gymneus/f-watch/doc/fosdem2015/pictures/pcb_component_placement.jpg

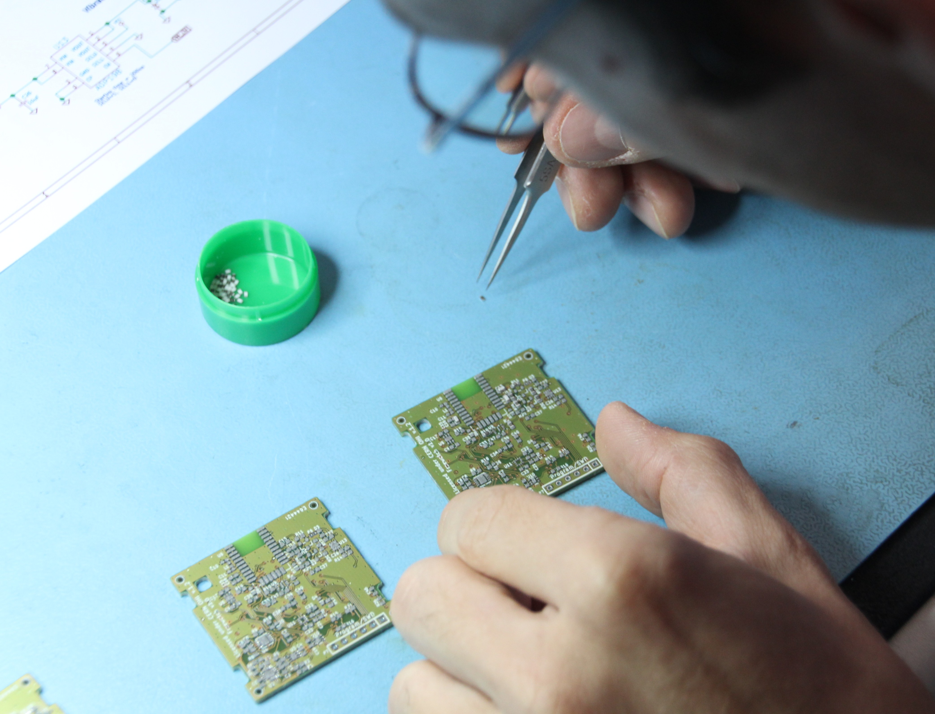
doc/fosdem2015/pictures/pcb_component_placement.jpg
