gymneus/f-watch/doc/fosdem2015/pictures/pcb_assembly_diagram.jpg

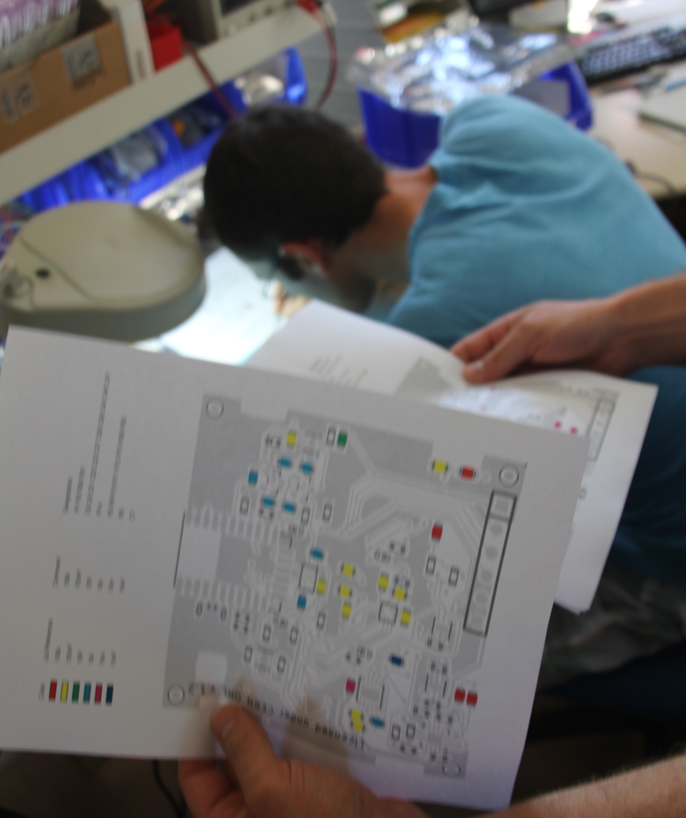
doc/fosdem2015/pictures/pcb_assembly_diagram.jpg
