gymneus/f-watch/doc/fosdem2015/pictures/battery.jpg

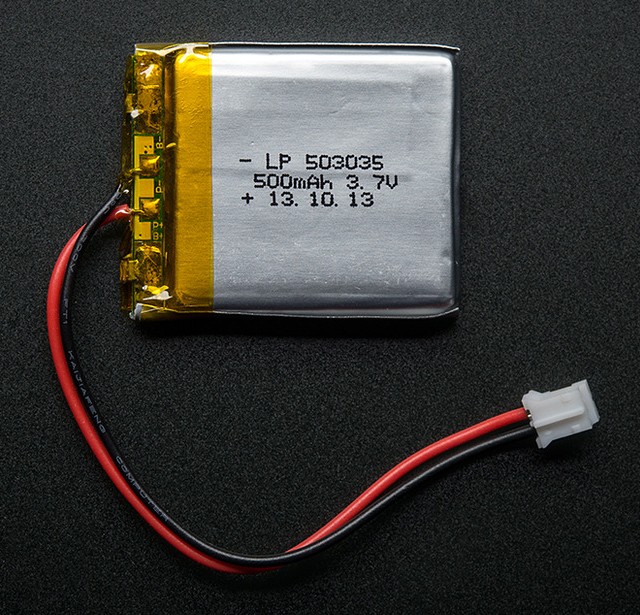
doc/fosdem2015/pictures/battery.jpg
