gymneus/f-watch/doc/fosdem2015/pictures/bl_custom_off.jpg

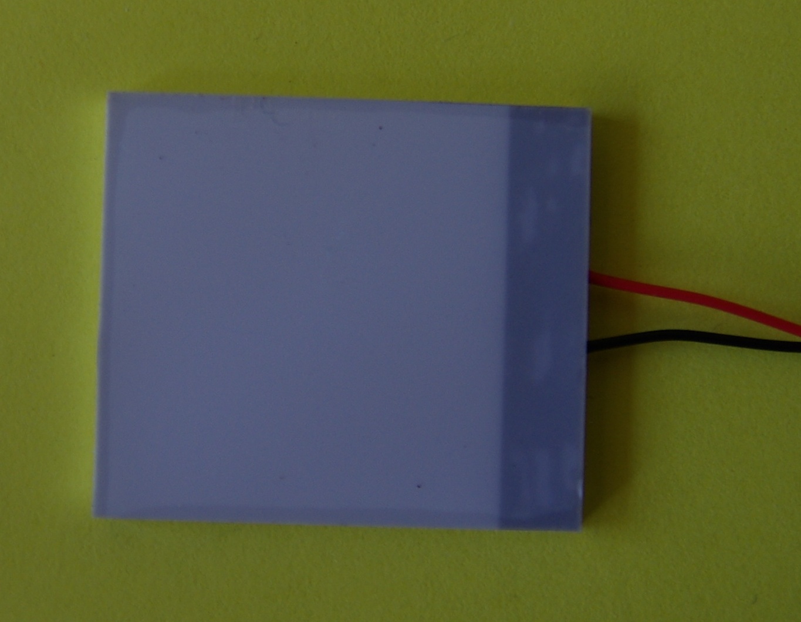
doc/fosdem2015/pictures/bl_custom_off.jpg
