gymneus/f-watch/doc/fosdem2015/pictures/bl_custom_on.jpg

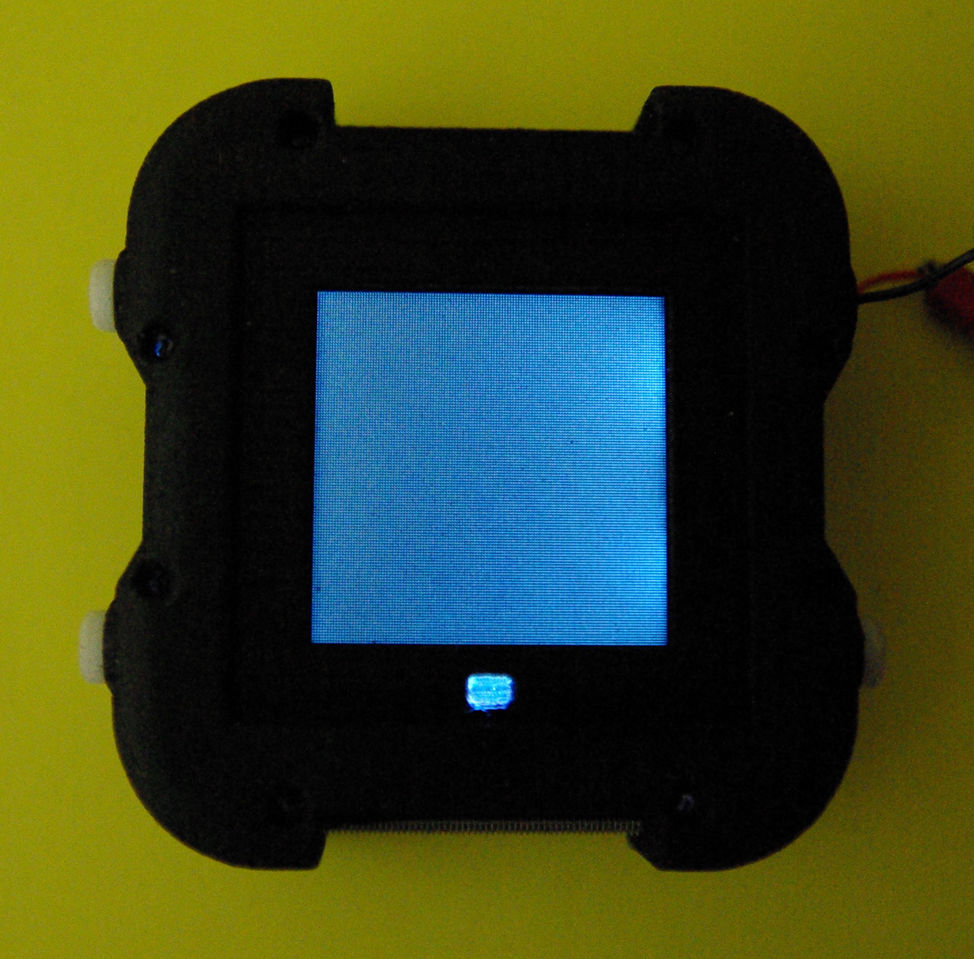
doc/fosdem2015/pictures/bl_custom_on.jpg
