gymneus/f-watch/doc/fosdem2015/pictures/bl_led_off.jpg

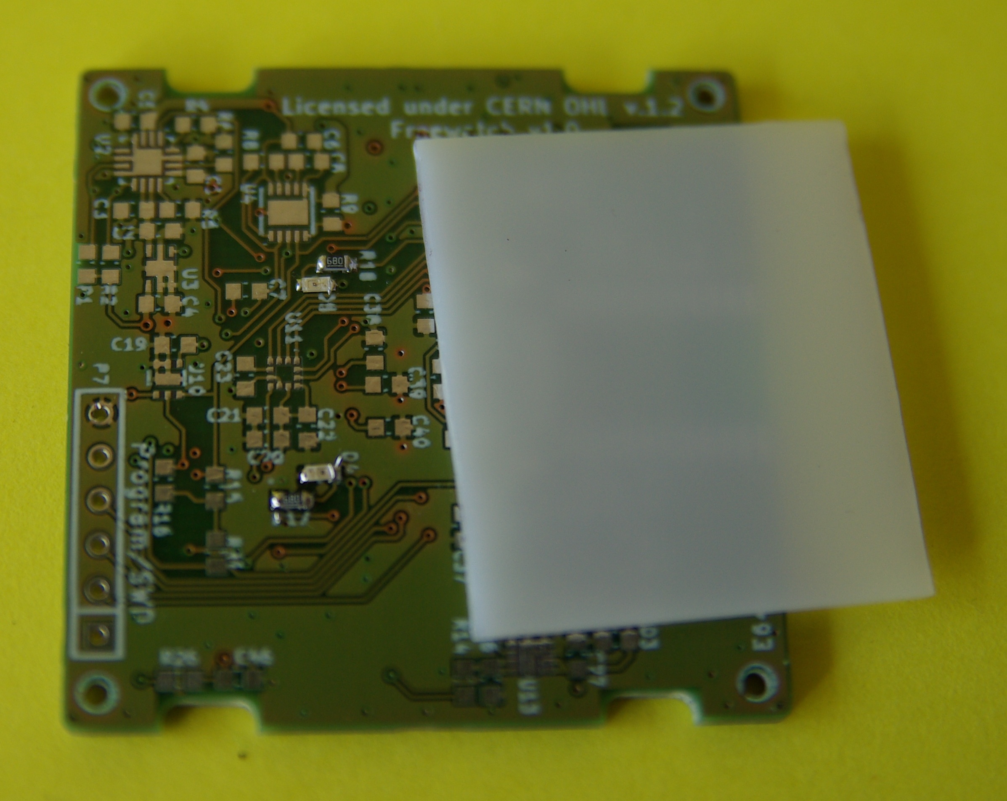
doc/fosdem2015/pictures/bl_led_off.jpg
