gymneus/f-watch/doc/fosdem2015/pictures/bl_led_on.jpg

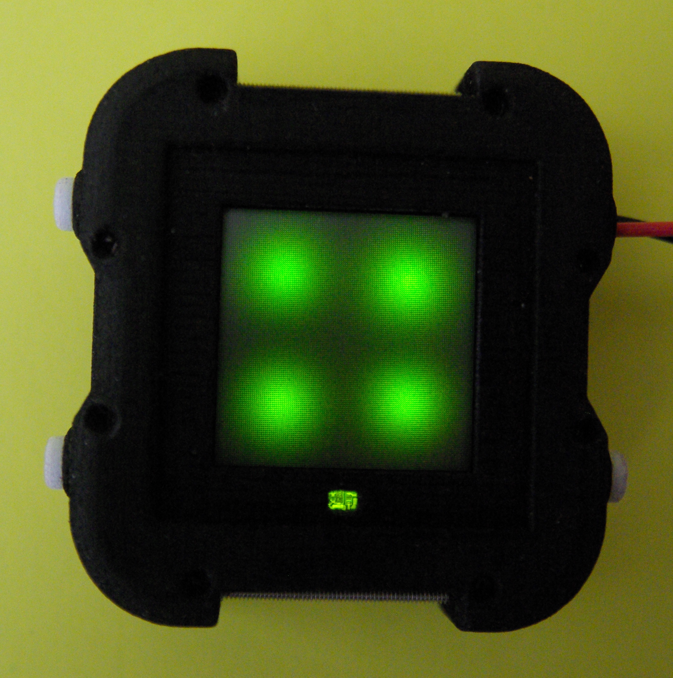
doc/fosdem2015/pictures/bl_led_on.jpg
