gymneus/f-watch/doc/fosdem2015/pictures/bl_smartphone_off.jpg

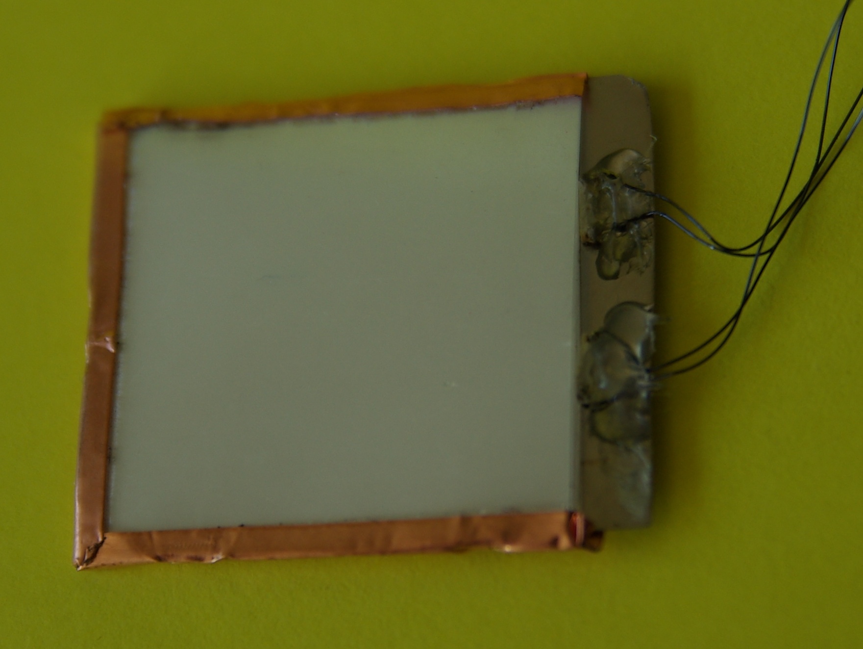
doc/fosdem2015/pictures/bl_smartphone_off.jpg
