gymneus/f-watch/doc/fosdem2015/pictures/bl_smartphone_on.jpg

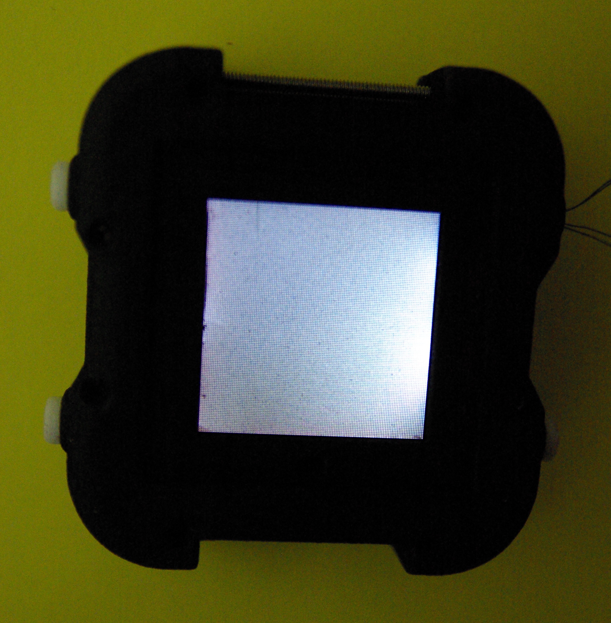
doc/fosdem2015/pictures/bl_smartphone_on.jpg
