gymneus/f-watch/doc/fosdem2015/pictures/case-design-model.jpg

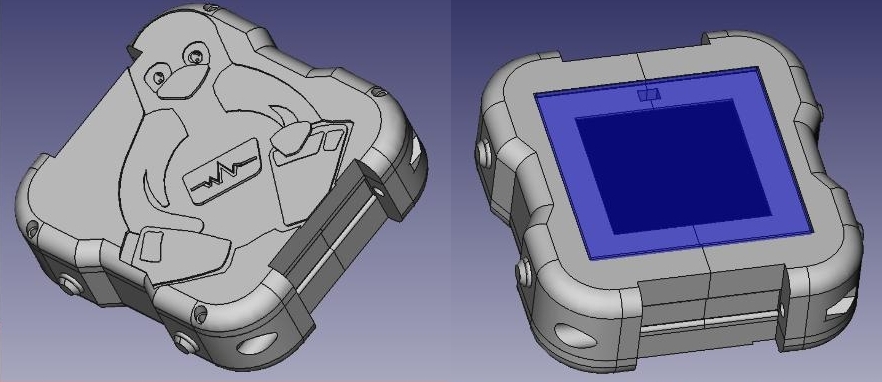
doc/fosdem2015/pictures/case-design-model.jpg
