gymneus/f-watch/doc/fosdem2015/pictures/fwatch-bike.jpg

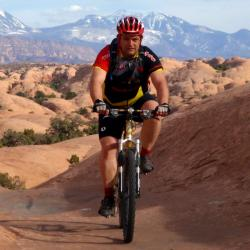
doc/fosdem2015/pictures/fwatch-bike.jpg
