gymneus/f-watch/doc/fosdem2015/pictures/fwatch-full-side-btn.jpg

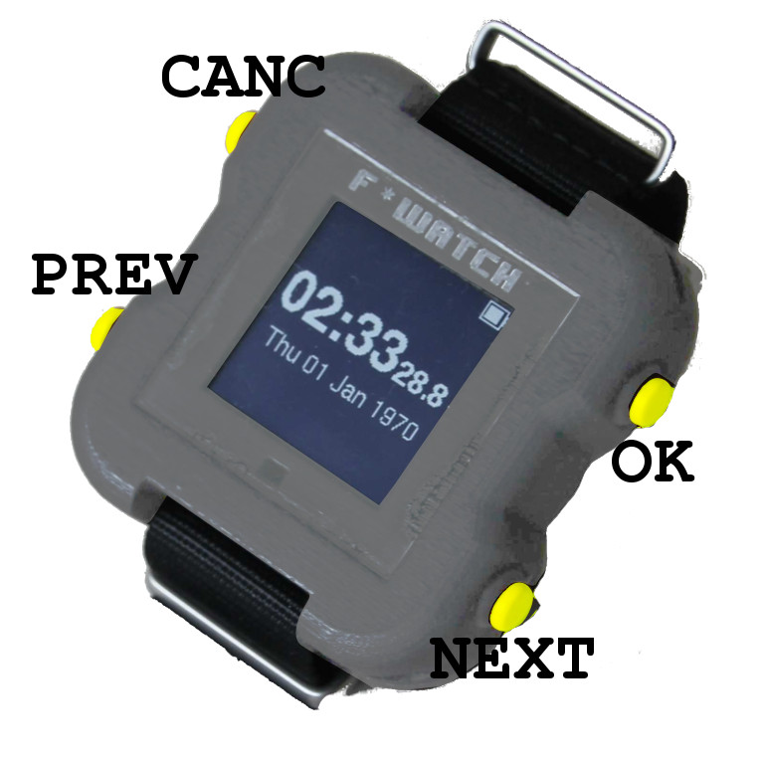
doc/fosdem2015/pictures/fwatch-full-side-btn.jpg
