gymneus/f-watch/doc/fosdem2015/pictures/fwatch-full-side.jpg

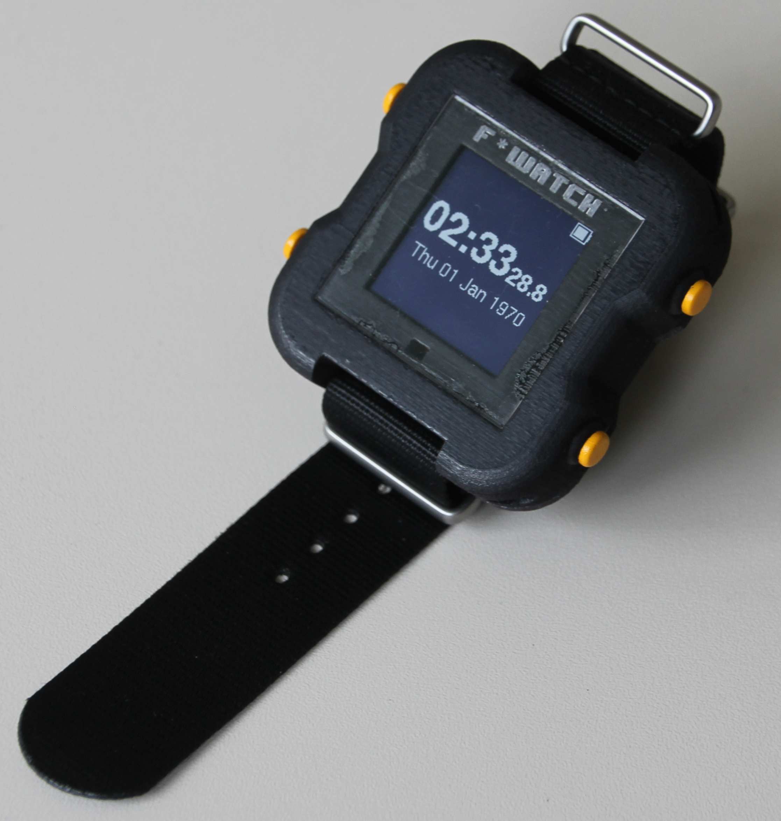
doc/fosdem2015/pictures/fwatch-full-side.jpg
