gymneus/f-watch/doc/fosdem2015/pictures/fwatch-para.jpg

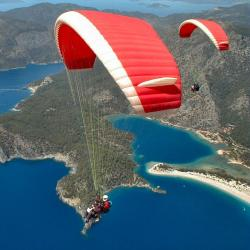
doc/fosdem2015/pictures/fwatch-para.jpg
