gymneus/f-watch/doc/fosdem2015/pictures/fwatch-team.jpg

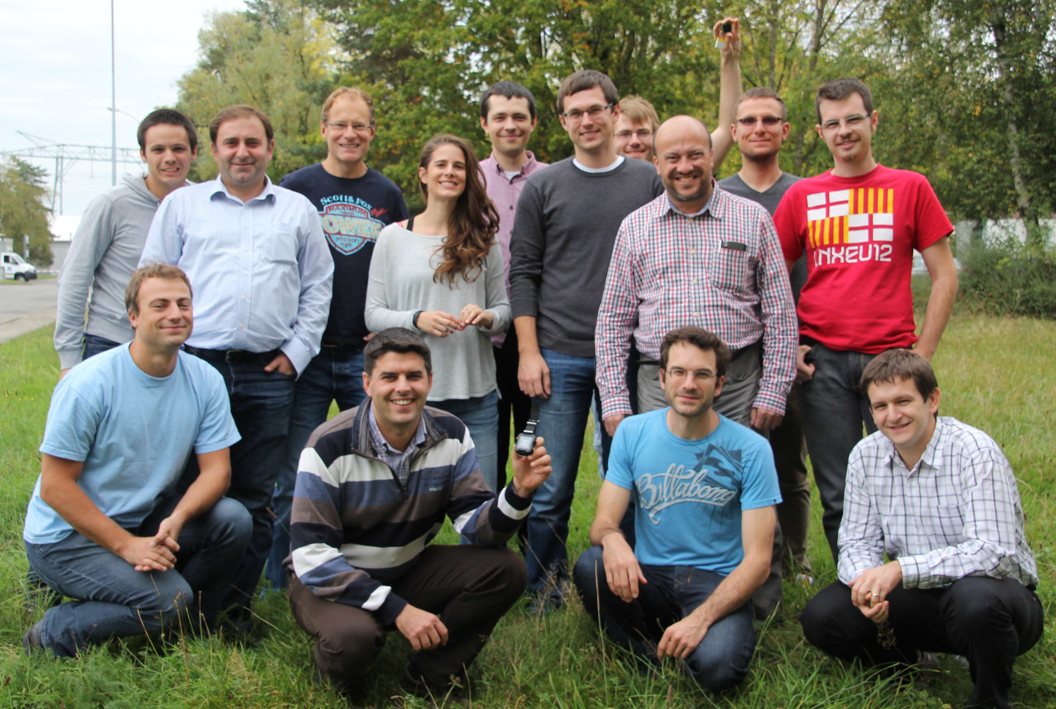
doc/fosdem2015/pictures/fwatch-team.jpg
