gymneus/f-watch/doc/fosdem2015/pictures/fwatch-tenn.jpg

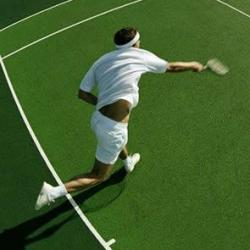
doc/fosdem2015/pictures/fwatch-tenn.jpg
