gymneus/f-watch/doc/fosdem2015/pictures/fwatch-trek.jpg

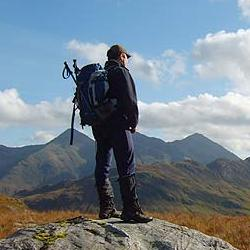
doc/fosdem2015/pictures/fwatch-trek.jpg
