gymneus/f-watch/doc/fosdem2015/pictures/LCD.jpg

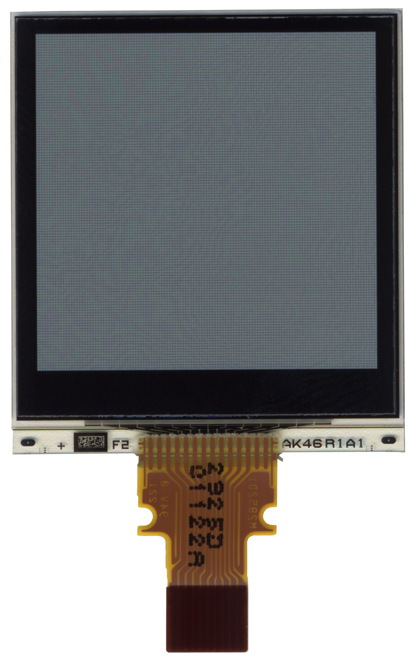
doc/fosdem2015/pictures/LCD.jpg
