gymneus/f-watch/doc/fosdem2015/pictures/M10478-A1.jpg

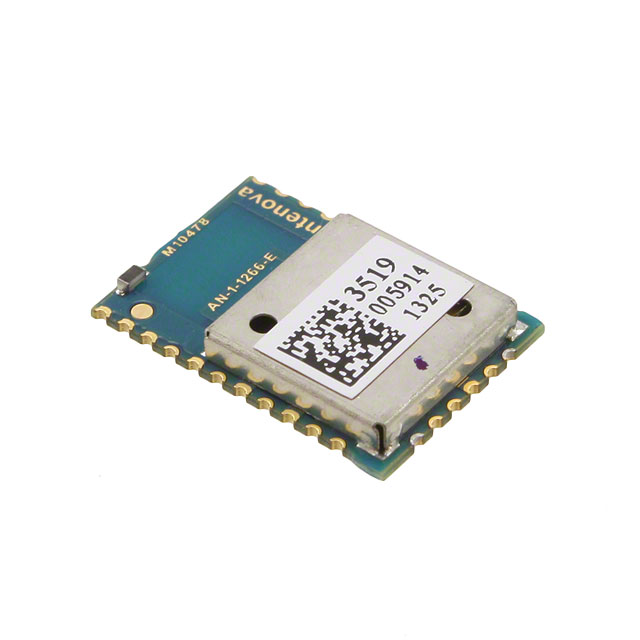
doc/fosdem2015/pictures/M10478-A1.jpg
