gymneus/f-watch/doc/fosdem2015/pictures/mcu_efm32.jpg

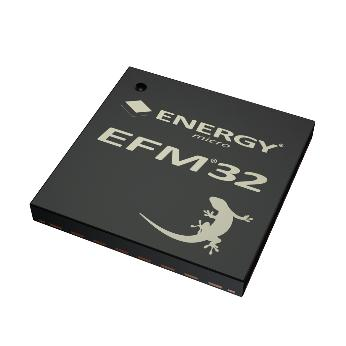
doc/fosdem2015/pictures/mcu_efm32.jpg
