gymneus/f-watch/doc/fosdem2015/pictures/MS5806-02BA52-51.jpg

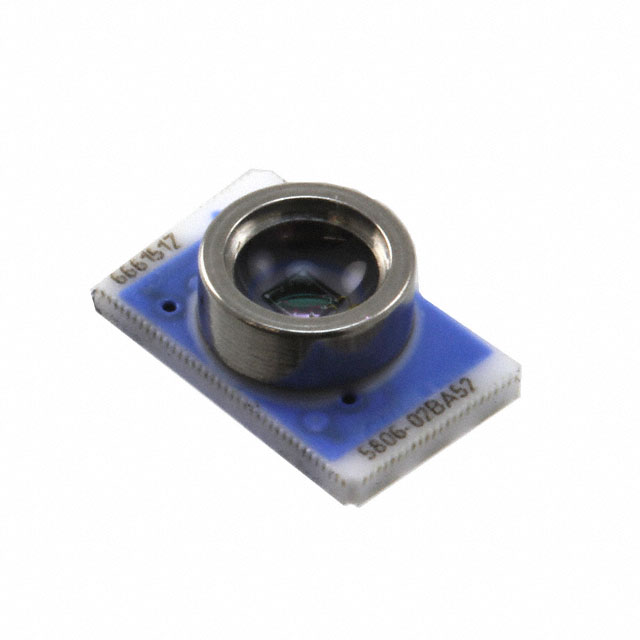
doc/fosdem2015/pictures/MS5806-02BA52-51.jpg
