gymneus/f-watch/doc/fosdem2015/pictures/pcb_mounted_bottom.jpg

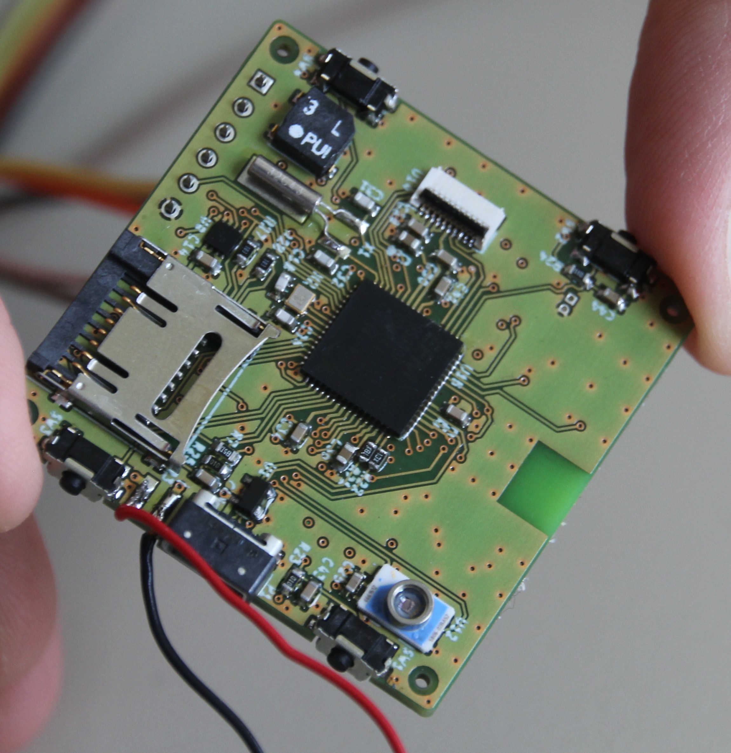
doc/fosdem2015/pictures/pcb_mounted_bottom.jpg
