gymneus/f-watch/doc/fosdem2015/pictures/pcb_mounted_top.jpg

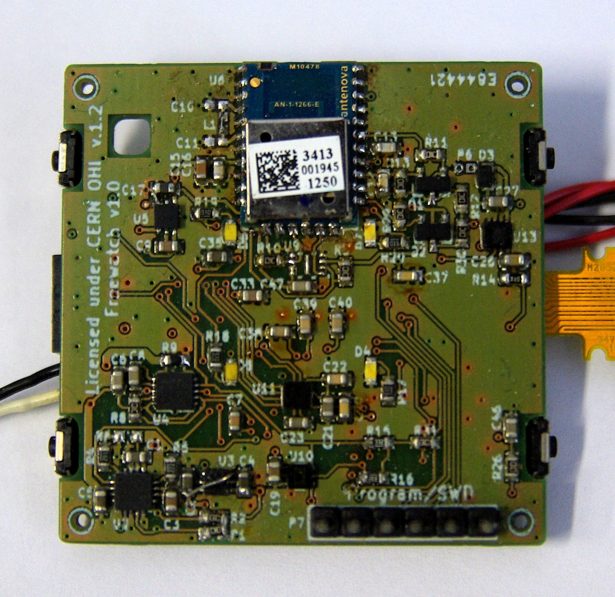
doc/fosdem2015/pictures/pcb_mounted_top.jpg
