gymneus/f-watch/doc/fosdem2015/pictures/pcb_stencil_paste.jpg

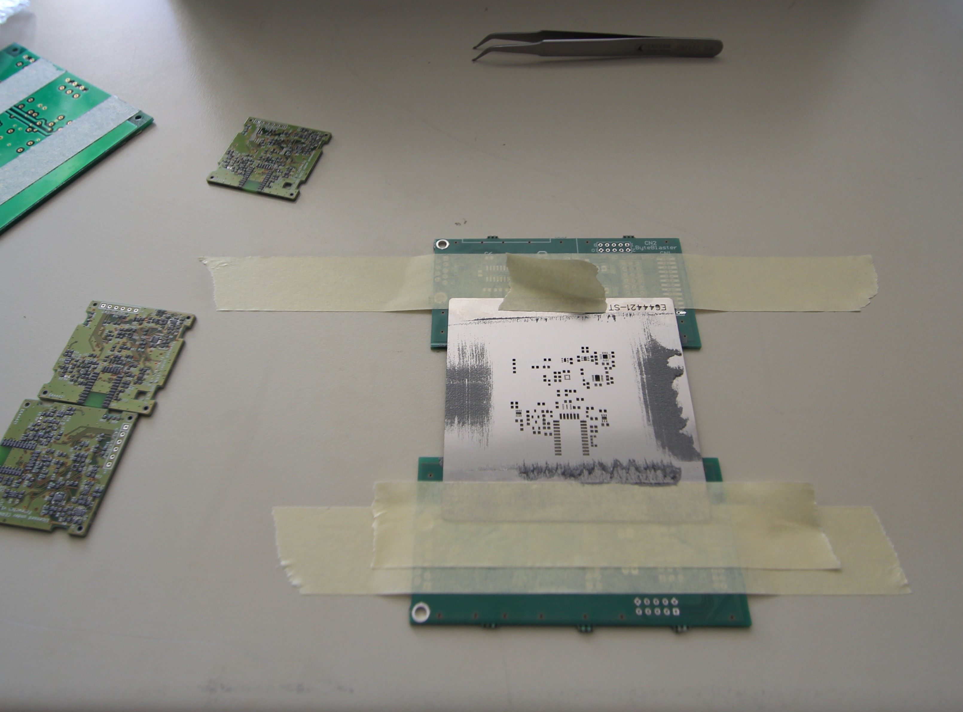
doc/fosdem2015/pictures/pcb_stencil_paste.jpg
