gymneus/f-watch/doc/fosdem2015/pictures/plexiglass.jpg

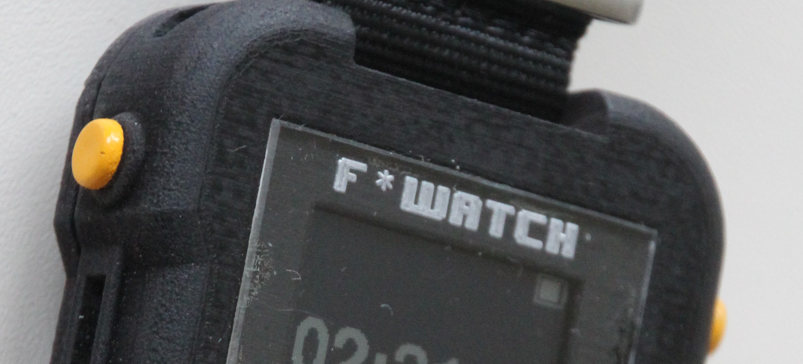
doc/fosdem2015/pictures/plexiglass.jpg
