gymneus/f-watch/doc/fosdem2015/pictures/sw_hello_world.jpg

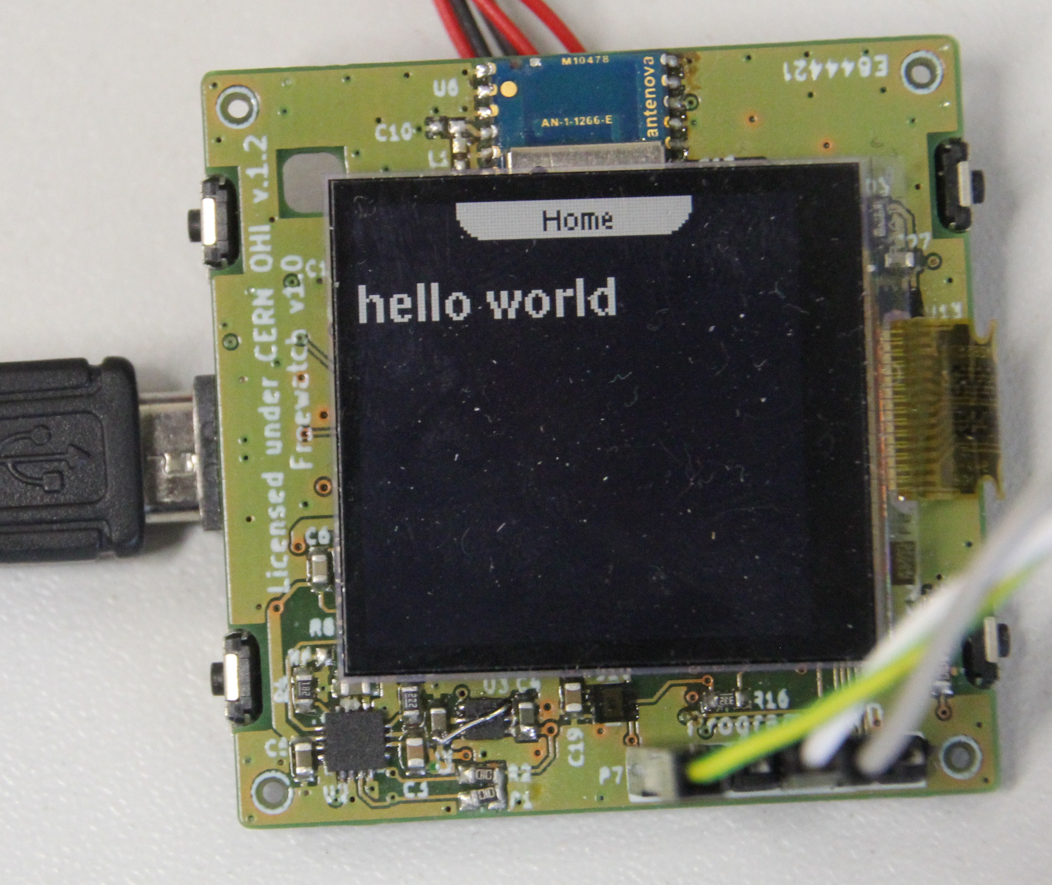
doc/fosdem2015/pictures/sw_hello_world.jpg
