gymneus/f-watch/doc/fosdem2015/pictures/tools.jpg

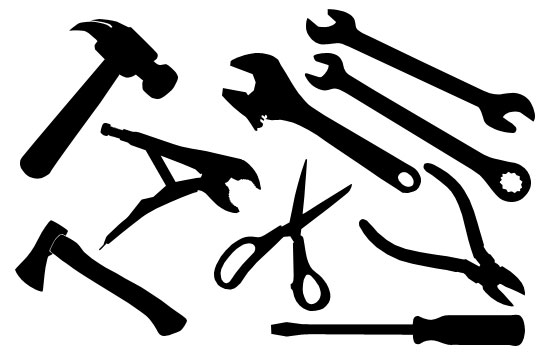
doc/fosdem2015/pictures/tools.jpg
