gymneus/f-watch/flyer.jpg

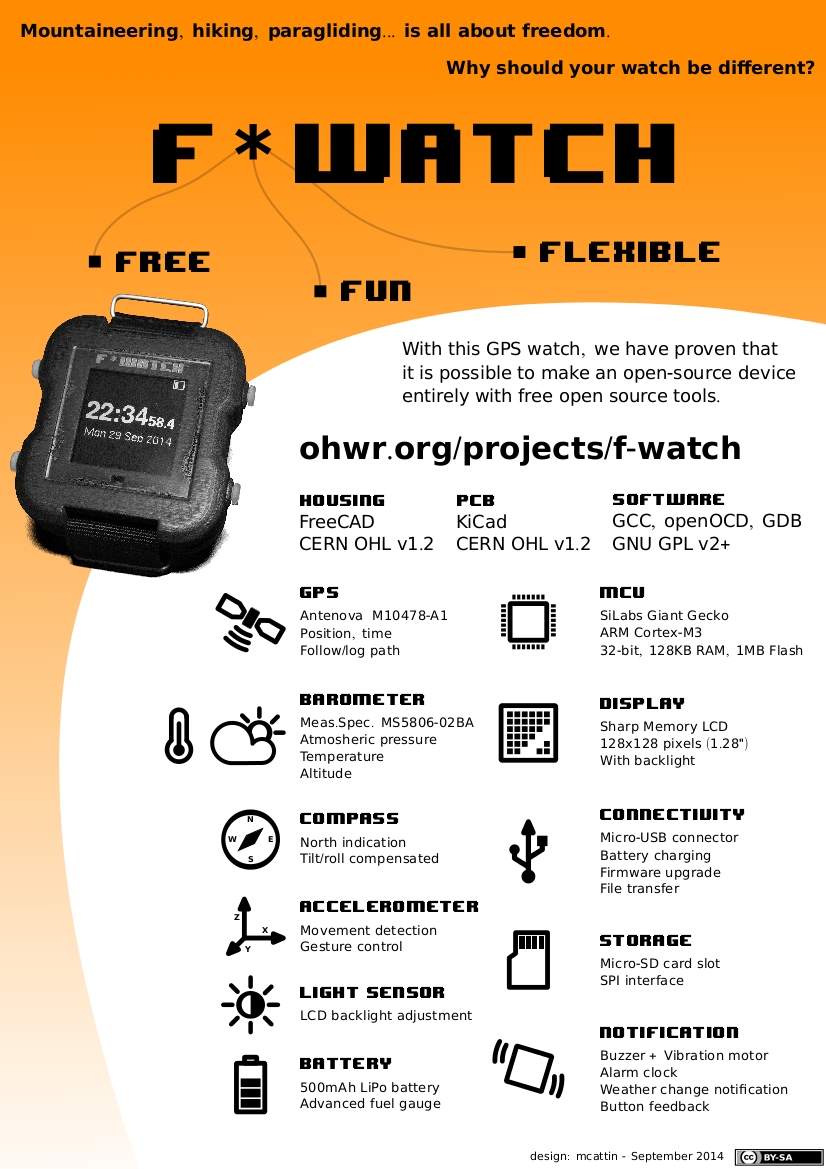
flyer.jpg
