gymneus/f-watch/sw/bitmaps/comp_circle2.bmp

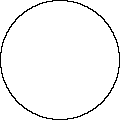
sw/bitmaps/comp_circle2.bmp
