gymneus/f-watch/sw/bitmaps/comp_circle3.bmp

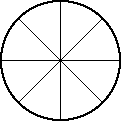
sw/bitmaps/comp_circle3.bmp
