gymneus/f-watch/sw/common/emdrv/emdrvdoc/html/group__EM__Drivers.png

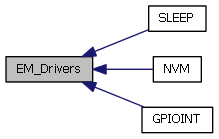
sw/common/emdrv/emdrvdoc/html/group__EM__Drivers.png
