gymneus/f-watch/mec/pcb_model/pcb_assembly.fcstd

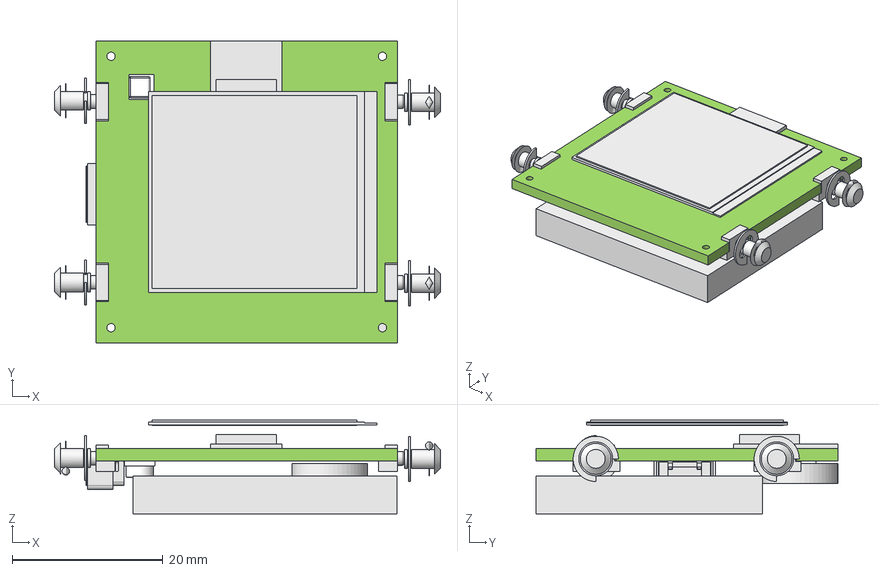
[picture p32: CAD file, 2014-10-09]
mec/pcb_model/pcb_assembly.fcstd
51.2 x 40.0 x 12.4 mm
Button1
Button2
Button3
Button4
Pressure_sensor
USB
GPS
Display
battery
Rivet_button1
Rivet_button2
Rivet_button3
Rivet_button4
PCB
Vibrating Motor
