gymneus/f-watch/mec/button_model/3d_printed_button.fcstd

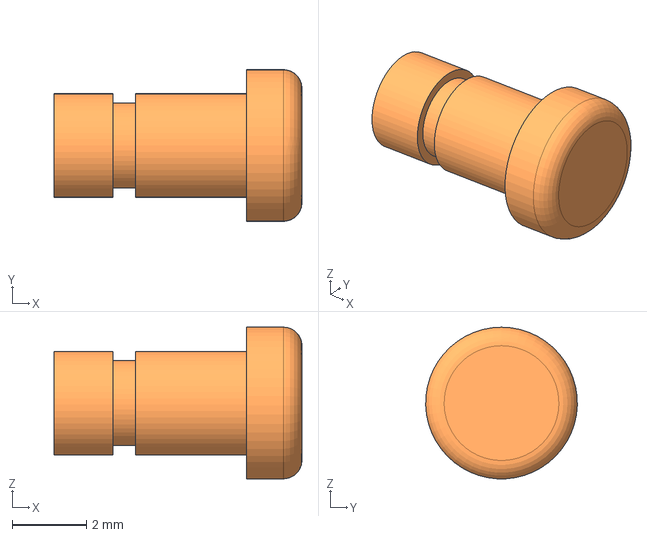
[picture p33: CAD file, 2014-10-09]
mec/button_model/3d_printed_button.fcstd
6.70 x 4.10 x 4.10 mm
