gymneus/f-watch/mec/case_model/Exported.v3/bottom.stl

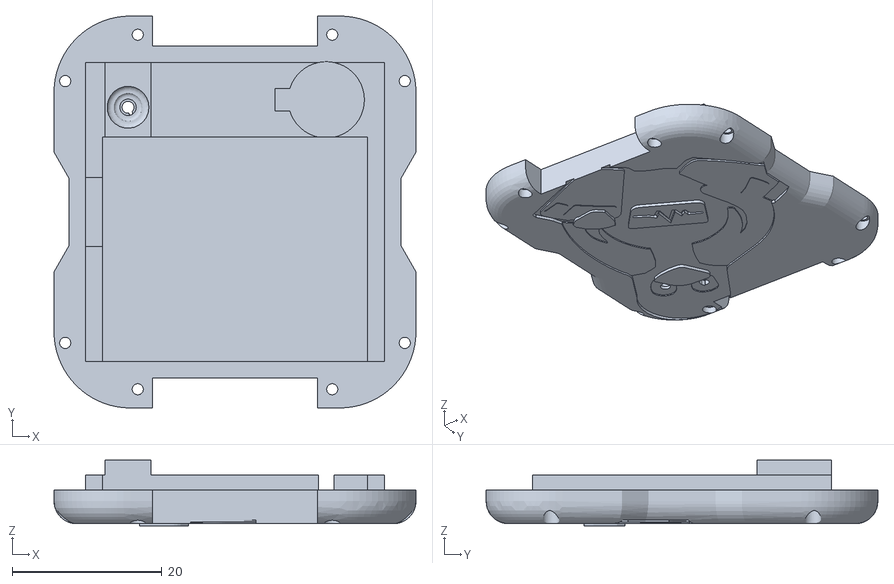
[picture p34: CAD file, 2014-10-09]
mec/case_model/Exported.v3/bottom.stl
48.4 x 52.4 x 8.80
