gymneus/f-watch/mec/case_model/Exported/TopRight.step

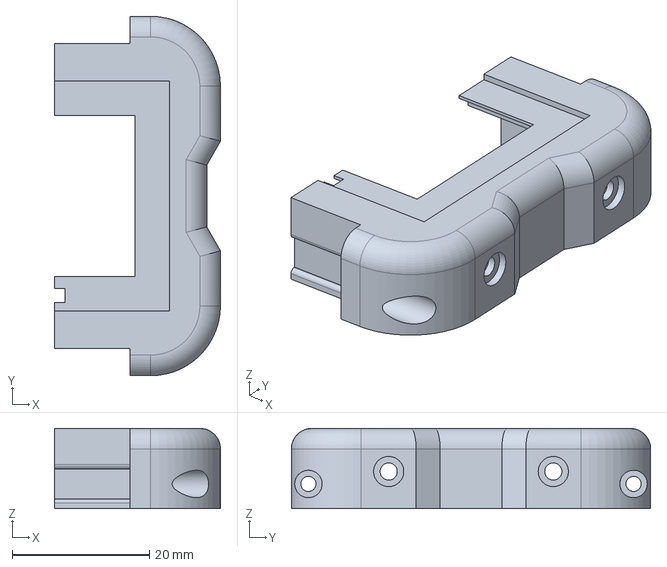
[picture p35: CAD file, 2014-10-09]
mec/case_model/Exported/TopRight.step
24.2 x 52.4 x 11.7 mm
