gymneus/f-watch/mec/case_model/watch_case.v2-simple.fcstd

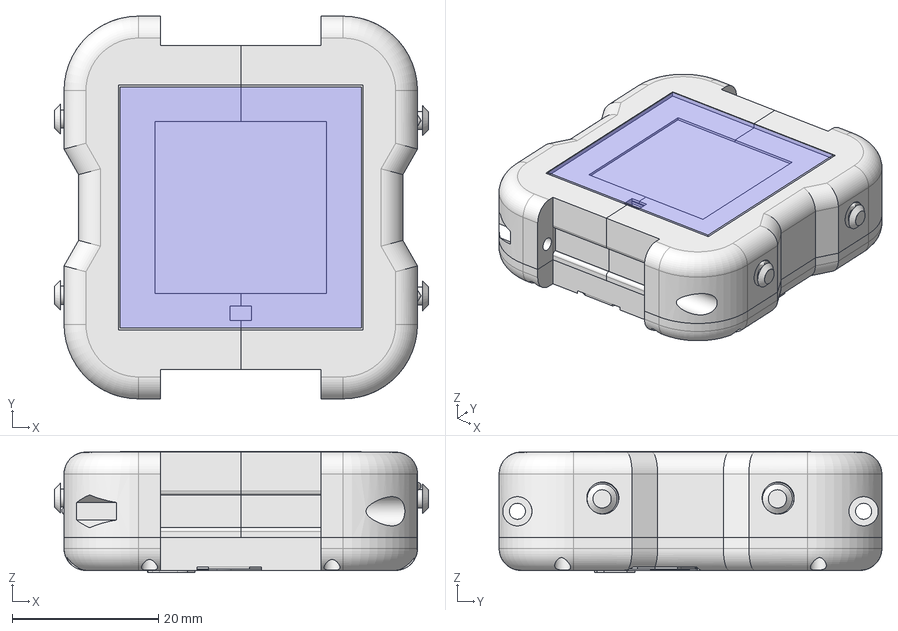
[picture p36: CAD file, 2014-10-09]
mec/case_model/watch_case.v2-simple.fcstd
51.2 x 52.4 x 16.6 mm
Rivet_buttons
PCB_assemblly
Sapphire Glass
Bottom
TopLeft
TopRigth
