gymneus/f-watch/mec/pcb_model/display_LS013B7DH03.fcstd

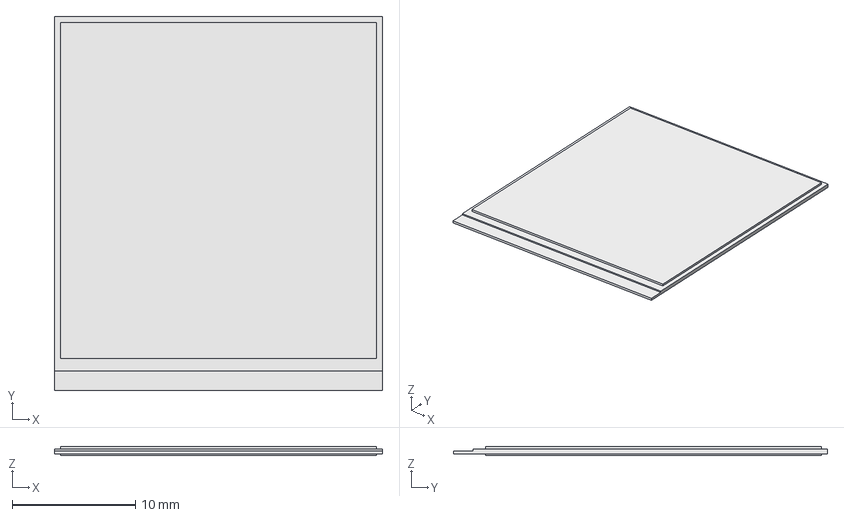
[picture p37: CAD file, 2014-10-09]
mec/pcb_model/display_LS013B7DH03.fcstd
26.6 x 30.3 x 0.741 mm
