gymneus/f-watch/mec/sketch/watch_case.fcstd

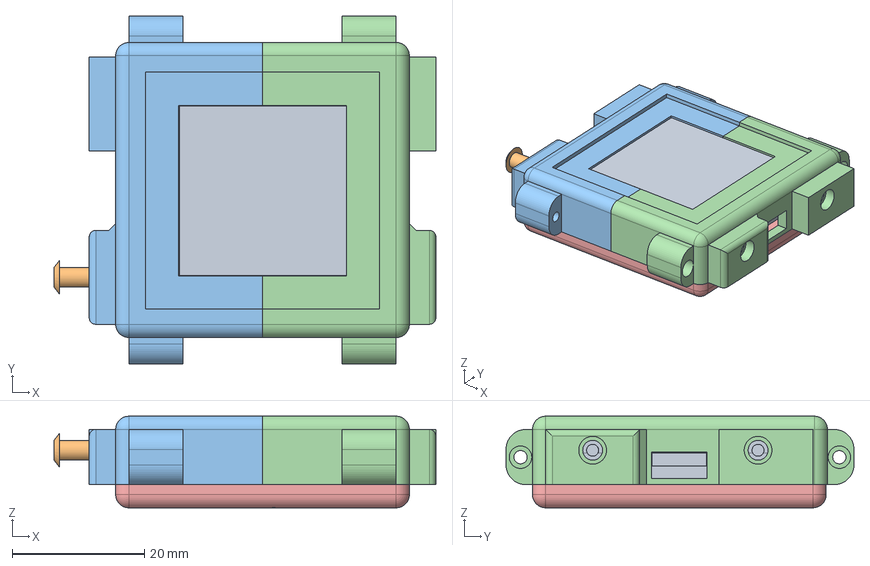
[picture p38: CAD file, 2014-10-09]
mec/sketch/watch_case.fcstd
57.7 x 52.6 x 13.9 mm
Pocket017 (Mirror #1)
