gymneus/f-watch/mec/button_model/array_test.fcstd

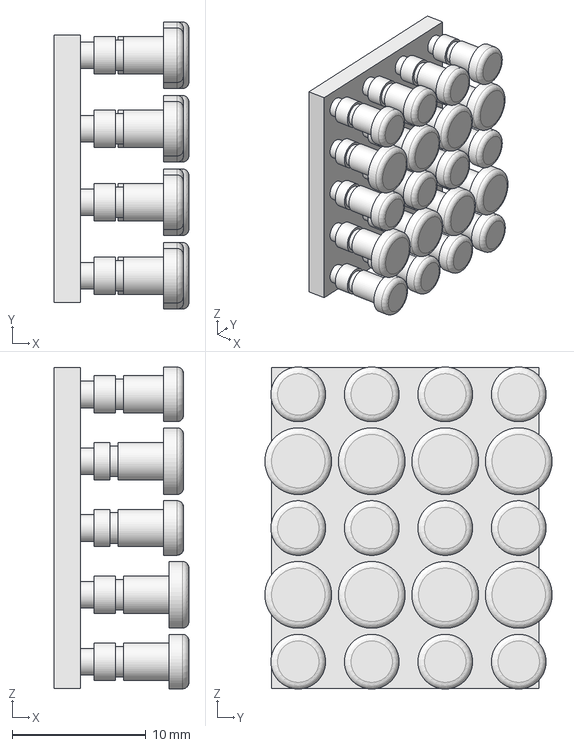
[picture p39: CAD file, 2014-10-09]
mec/button_model/array_test.fcstd
10.1 x 21.5 x 24.1 mm
