gymneus/f-watch/mec/case_model/Exported.v3/top.stl

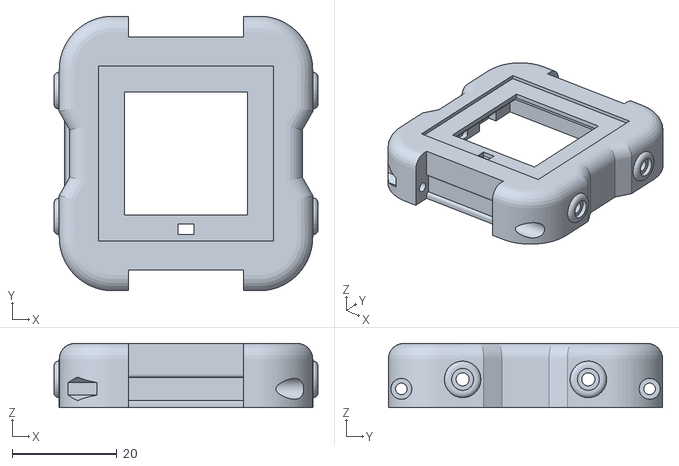
[picture p40: CAD file, 2014-10-09]
mec/case_model/Exported.v3/top.stl
50.4 x 52.4 x 12.3
