gymneus/f-watch/mec/case_model/watch_case.v1.fcstd

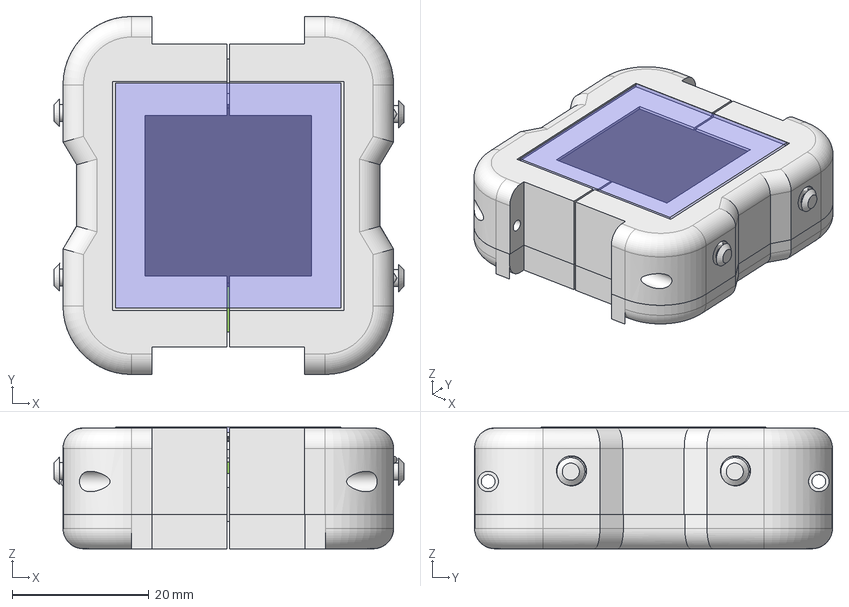
[picture p41: CAD file, 2014-10-09]
mec/case_model/watch_case.v1.fcstd
51.2 x 52.4 x 17.8 mm
Button1
Button2
Button3
Button4
Pressure_sensor
USB
GPS
Display
battery
PCB
Rivet_buttons
Vibrating Motor
Fillet001001001001002 (Mirror #2)
Sapphire Glass
