gymneus/f-watch/mec/pcb_model/gps_module_M10478.fcstd

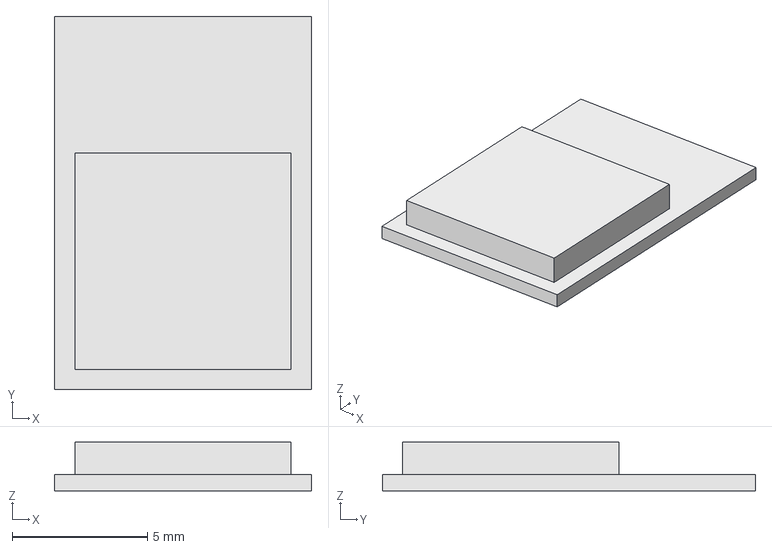
[picture p42: CAD file, 2014-10-09]
mec/pcb_model/gps_module_M10478.fcstd
9.50 x 13.8 x 1.80 mm
