gymneus/f-watch/mec/button_model/Rivet_button.fcstd

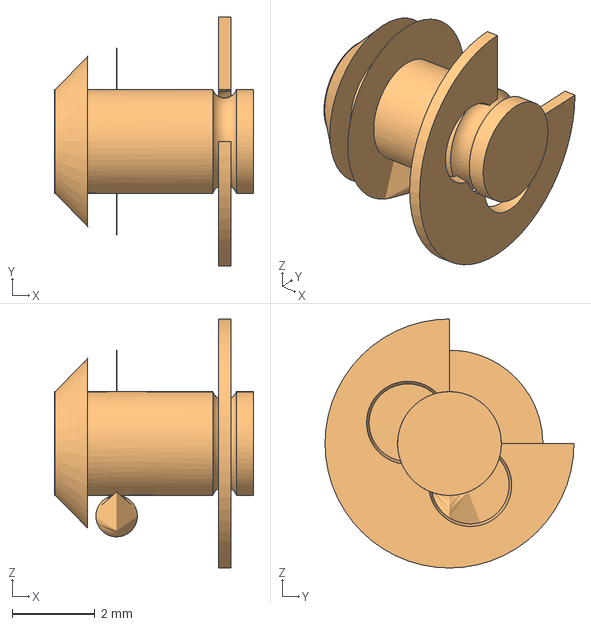
[picture p43: CAD file, 2014-10-09]
mec/button_model/Rivet_button.fcstd
4.80 x 6.00 x 6.00 mm
Rivet_button
