gymneus/f-watch/mec/pcb_model/pcb.fcstd

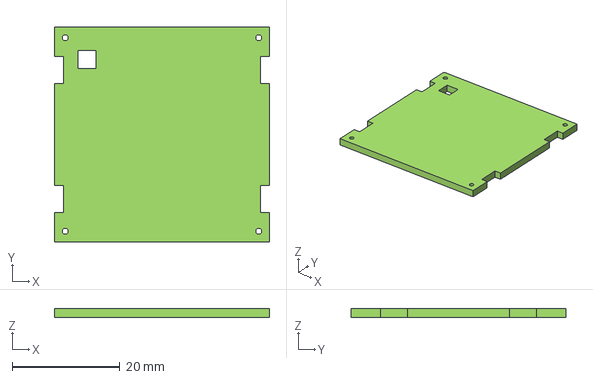
[picture p44: CAD file, 2014-10-09]
mec/pcb_model/pcb.fcstd
40.0 x 40.0 x 1.70 mm
