gymneus/f-watch/mec/sketch/watch_case.v2.fcstd

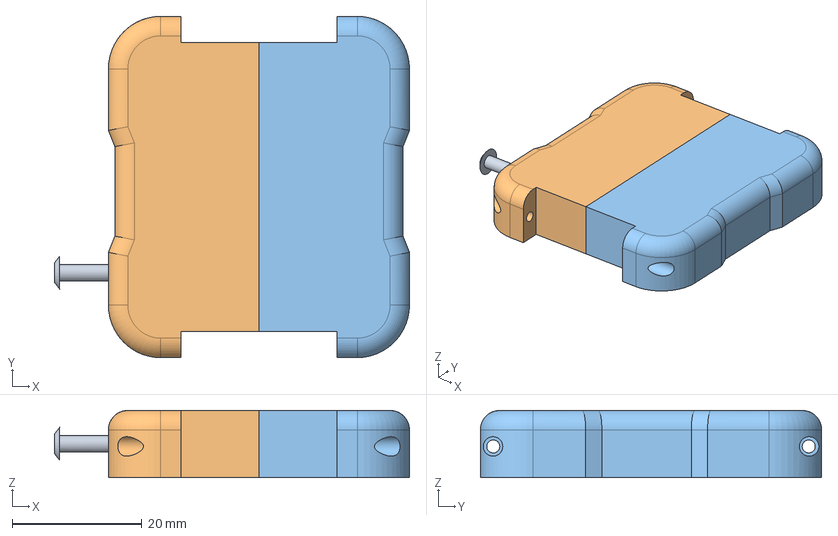
[picture p45: CAD file, 2014-10-09]
mec/sketch/watch_case.v2.fcstd
54.7 x 52.6 x 10.4 mm
Fillet (Mirror #1)
