gymneus/f-watch/mec/case_model/Exported/Top.step

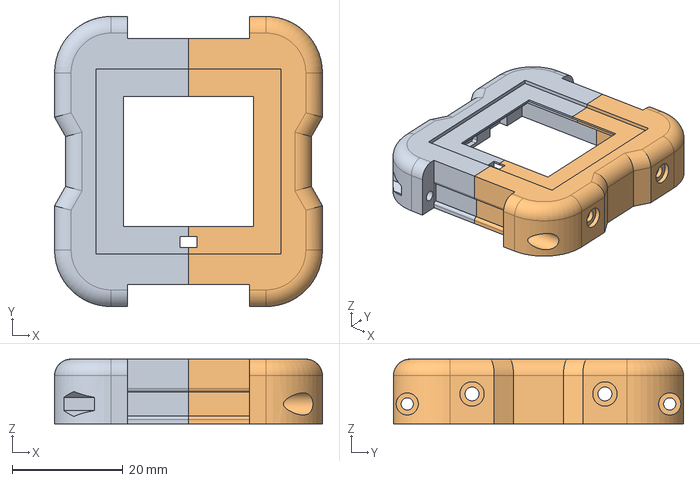
[picture p46: CAD file, 2014-10-09]
mec/case_model/Exported/Top.step
48.4 x 52.4 x 11.7 mm
