gymneus/f-watch/mec/pcb_model/pressure_sensor_MS5806-02BA.fcstd

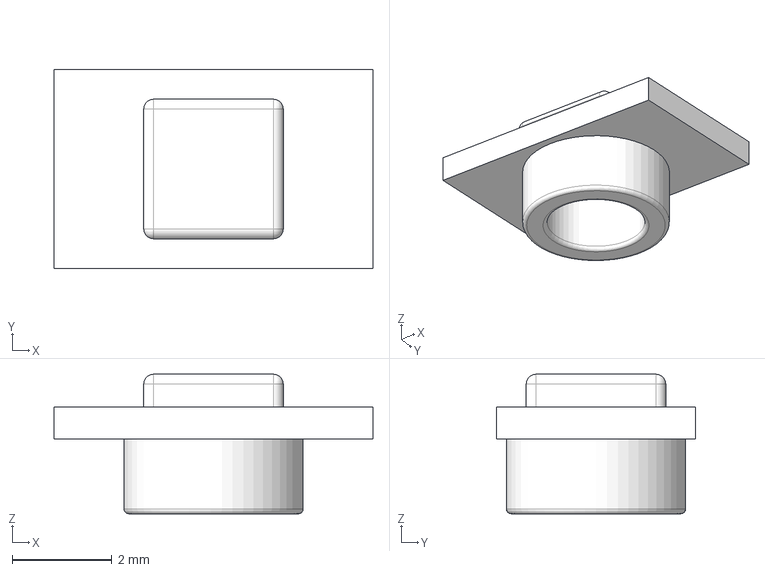
[picture p47: CAD file, 2014-10-09]
mec/pcb_model/pressure_sensor_MS5806-02BA.fcstd
6.40 x 4.00 x 2.80 mm
