gymneus/f-watch/mec/sketch/components_placement.fcstd

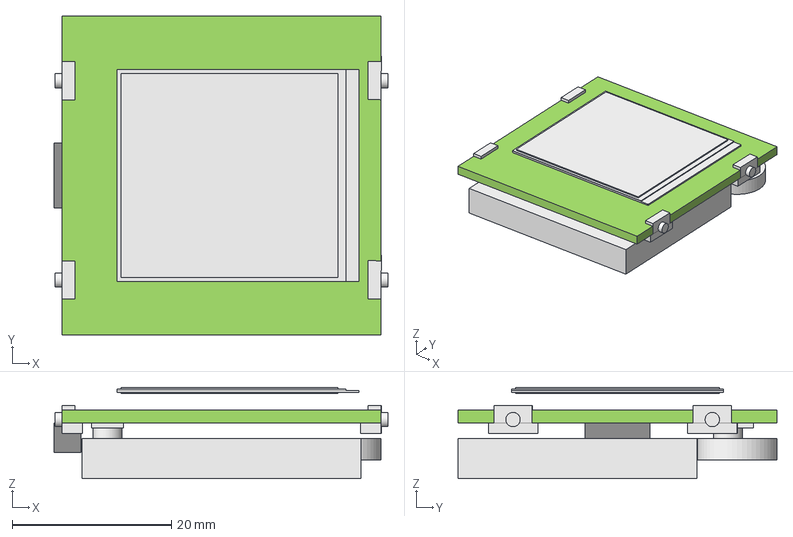
[picture p48: CAD file, 2014-10-09]
mec/sketch/components_placement.fcstd
41.9 x 40.0 x 11.4 mm
battery
usb
pcb
vibre
button
button001
button002
button003
button004
display
MS5806-02BA
