gymneus/f-watch/mec/pcb_model/button_EVQP4.fcstd

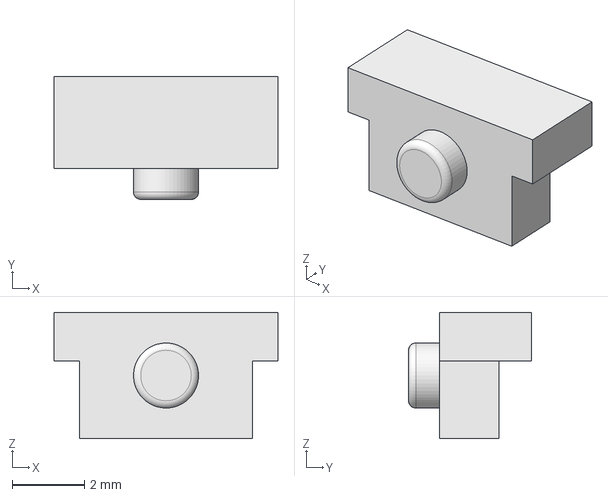
[picture p49: CAD file, 2014-10-09]
mec/pcb_model/button_EVQP4.fcstd
6.20 x 3.40 x 3.50 mm
