gymneus/f-watch/mec/sketch/button_idea.fcstd

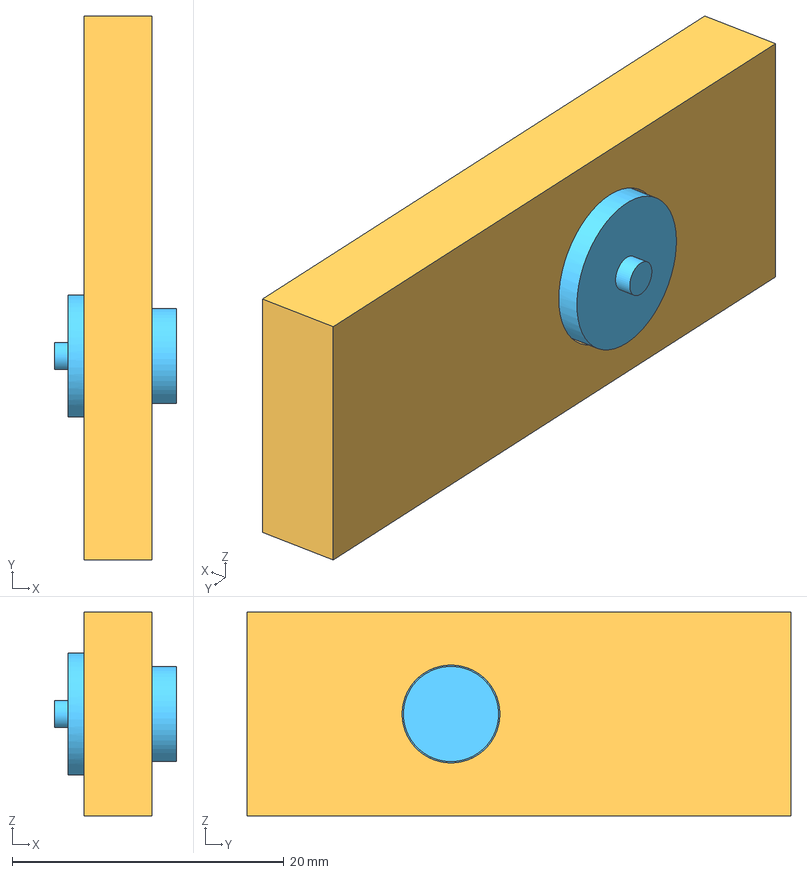
[picture p50: CAD file, 2014-05-12]
mec/sketch/button_idea.fcstd
9.00 x 40.0 x 15.0 mm
o-ring
button
