gymneus/f-watch/mec/pcb_model/usb_connector_1551629.fcstd

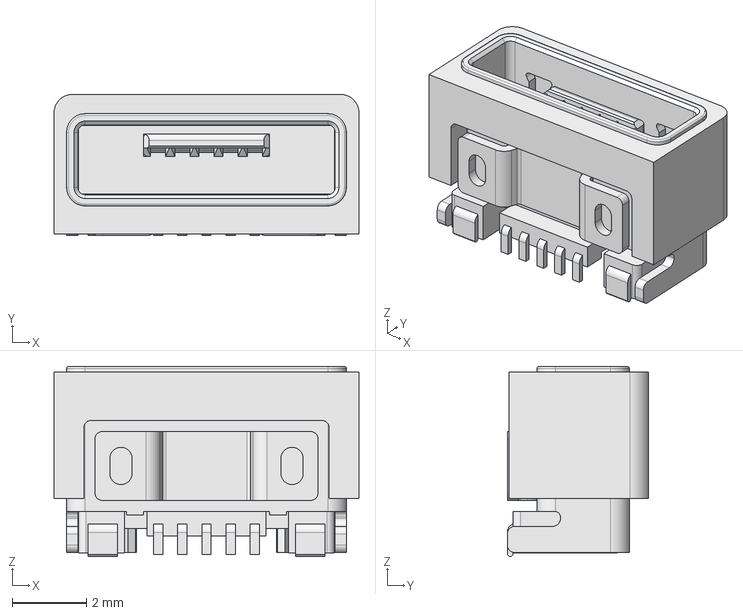
[picture p51: CAD file, 2014-10-09]
mec/pcb_model/usb_connector_1551629.fcstd
8.20 x 3.80 x 5.11 mm
