gymneus/f-watch/(list of files, cad)

Other CAD files:
watch_case.v2-simple.fcstd
mec/case_model/Exported/Bottom.step
mec/sketch/watch_case-testing-crazy-idea.fcstd
watch_case.v2.fcstd
mec/case_model/Exported/TopLeft.step
mec/case_model/Exported/Bottom.stl
mec/case_model/Exported/Top.stl
mec/case_model/Exported/TopLeft.stl
mec/case_model/Exported/TopRight.stl
