gymneus/f-watch/doc/fosdem2015/pictures/case-design-print-v1-2.jpg

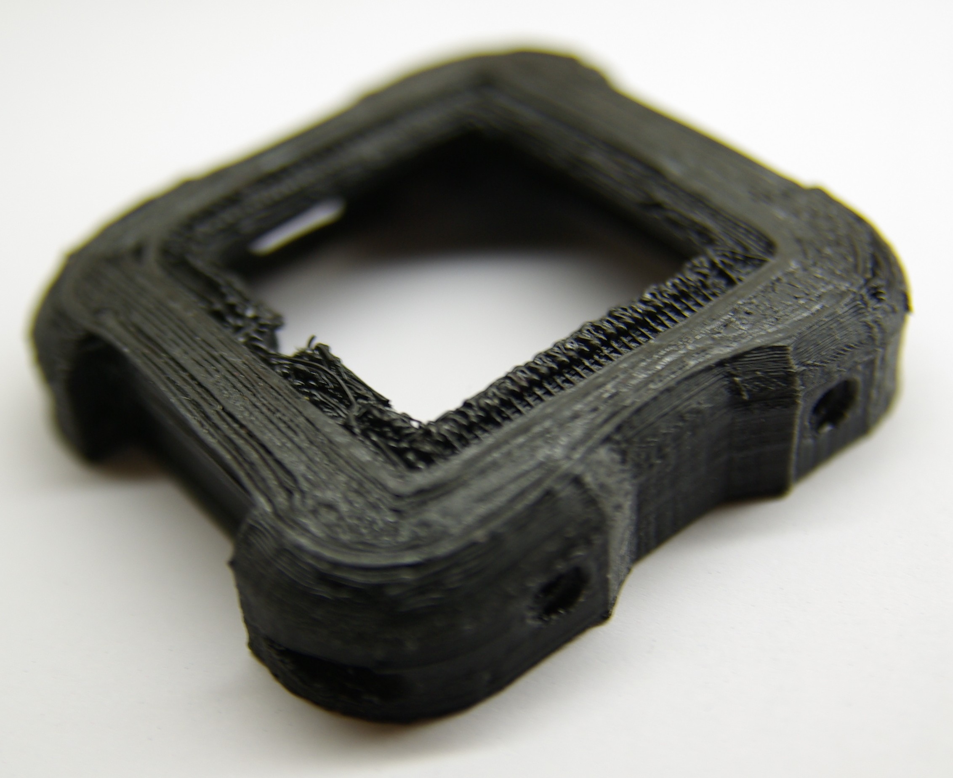
doc/fosdem2015/pictures/case-design-print-v1-2.jpg
