gymneus/f-watch/doc/fosdem2015/pictures/case-design-print-v3.jpg

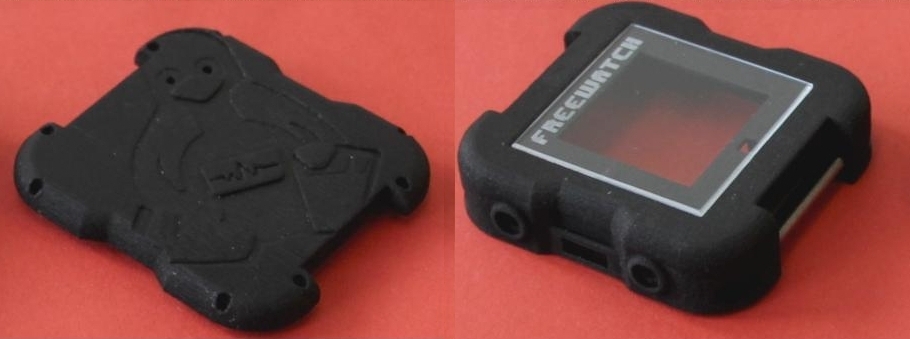
doc/fosdem2015/pictures/case-design-print-v3.jpg
