gymneus/f-watch/flyer.pdf

Mountaineering, hiking, paragliding... is all about freedom.

## Why should your watch be different?

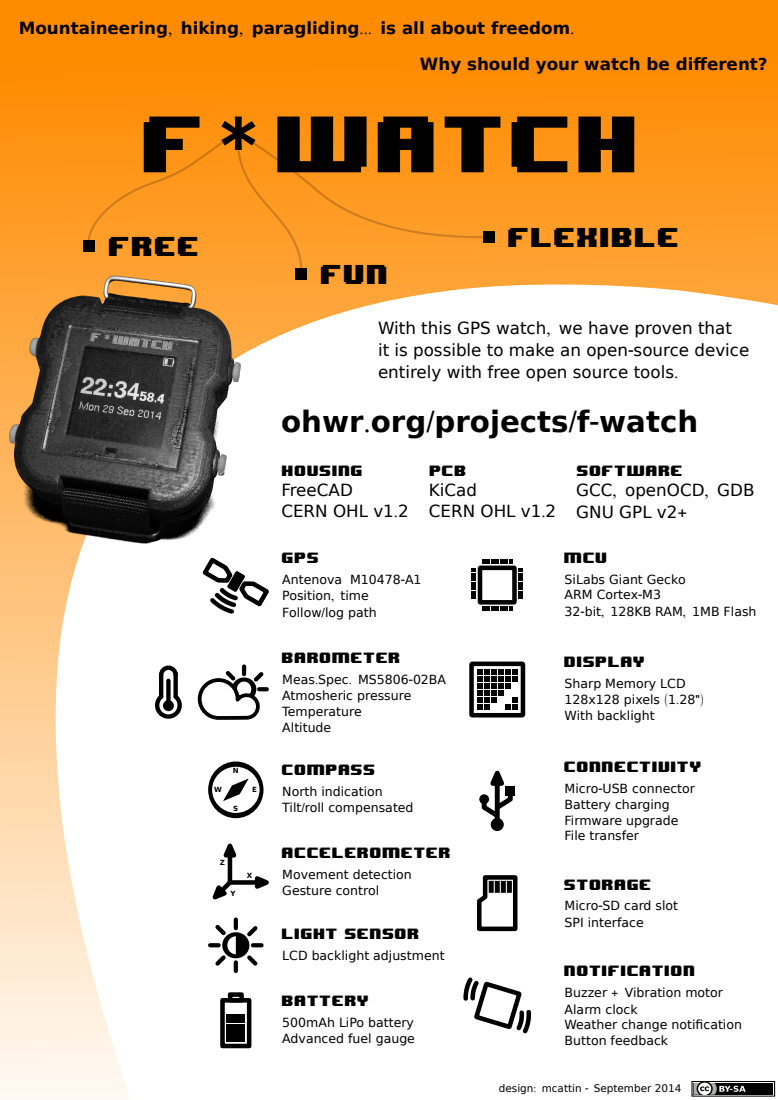
[picture p56: page 1]
FreeCAD CERN OHL v1.2; HOUSING; KiCad CERN OHL v1.2; PCB; BAROMETER; Meas.Spec. MS5806-02BA Atmosheric pressure Temperature Altitude; ACCELEROMETER; Movement detection Gesture control; FREE; FLEXIBLE; FUN; F WATCH *

With this GPS watch, we have proven that
it is possible to make an open-source device
entirely with free open source tools.
ohwr.org/projects/f-watch

Software
GCC, openOCD, GDB
GNU GPL v2+

GPS
Antenova M10478-A1
Position, time
Follow/log path

MCU
SiLabs Giant Gecko
ARM Cortex-M3
32-bit, 128KB RAM, 1MB Flash

DISPLAY
Sharp Memory LCD
128x128 pixels (1.28")
With backlight

COMPASS
North indication
Tilt/roll compensated

CONNECTIVITY
Micro-USB connector
Battery charging
Firmware upgrade
File transfer

STORAGE
Micro-SD card slot
SPI interface

LIGHT SENSOR
LCD backlight adjustment

NOTIFICATION
Buzzer + Vibration motor
Alarm clock
Weather change notification
Button feedback

BATTERY
500mAh LiPo battery
Advanced fuel gauge

design: mcattin - September 2014
