gymneus/f-watch/freewatch_v1_sch.pdf

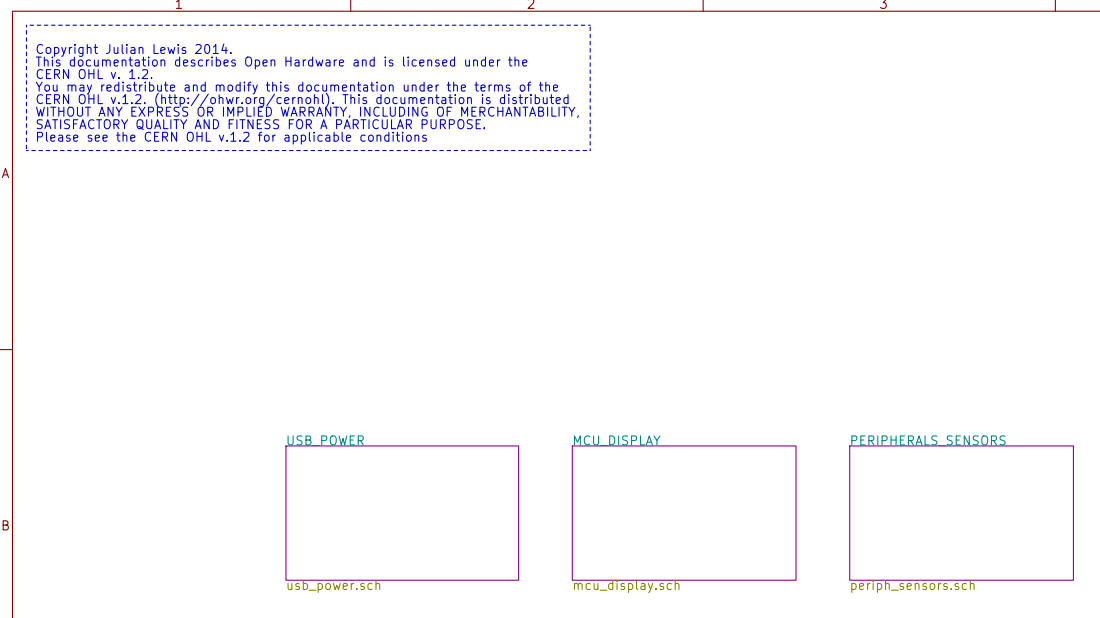
[picture p57: page 1]

Copyright Julian Lewis 2014.
This documentation describes Open Hardware and is licensed under the CERN OHL v. 1.2. You may redistribute and modify this documentation under the terms of the

CERN OHL v.1.2. (http://ohwr.org/cernohl). This documentation is distributed WITHOUT ANY EXPRESS OR IMPLIED WARRANTY, INCLUDING OF MERCHANTABILITY, SATISFACTORY QUALITY AND FITNESS FOR A PARTICULAR PURPOSE. Please see the CERN OHL v.1.2 for applicable conditions

File: freewatch_v1.sch Sheet: /
Id: 1/4 Title: Freewatch top

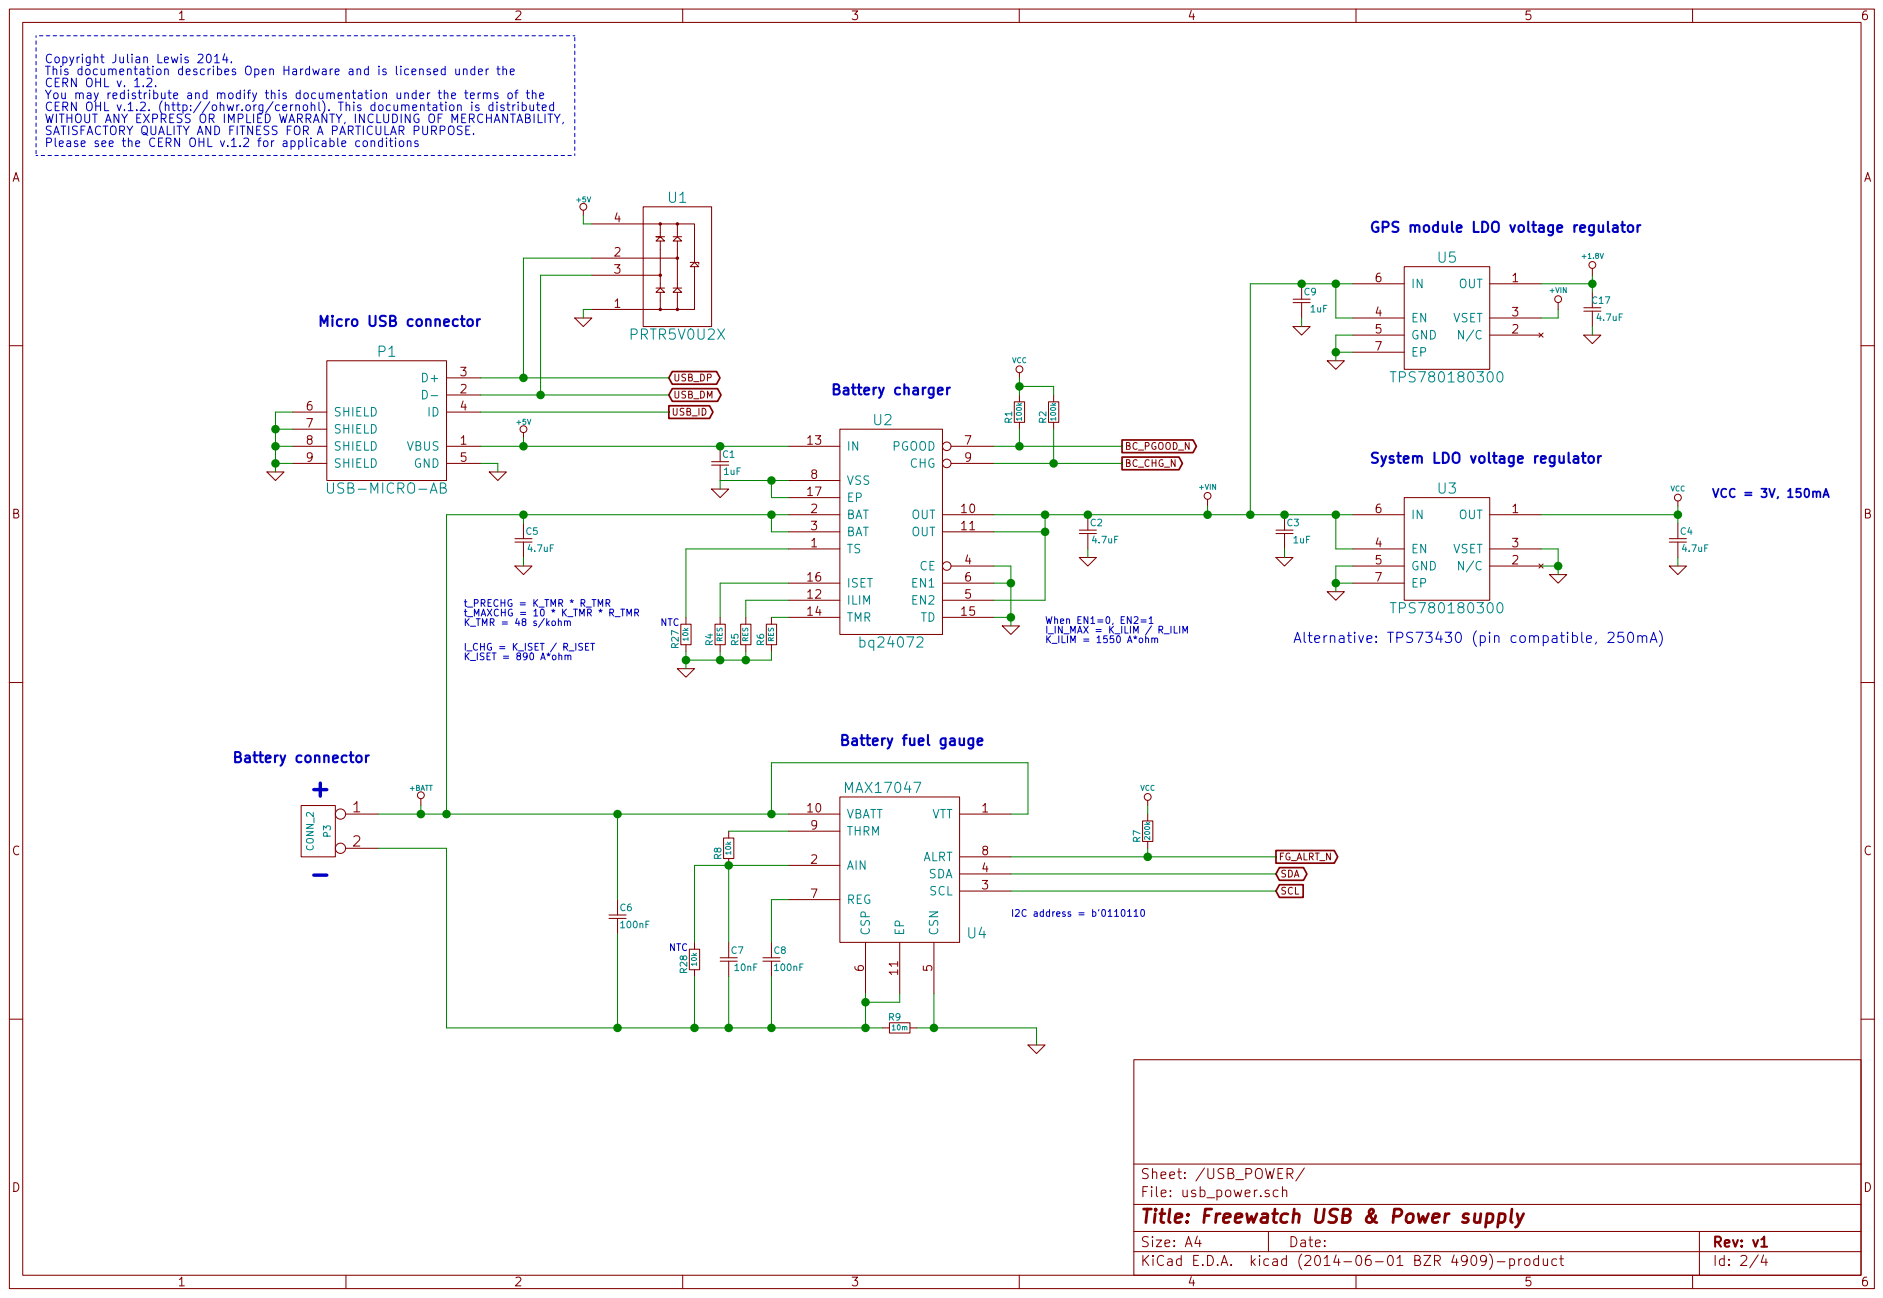
[picture p58: page 2]
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

4.7uF GPS module LDO voltage regulator

System LDO voltage regulator

6 REG 7 ALRT 8 THRM 9 VBATT 10 EP 11 U4 MAX17047

Sheet: /USB_POWER/
File: usb_power.sch
Id: 2/4 Title: Freewatch USB & Power supply

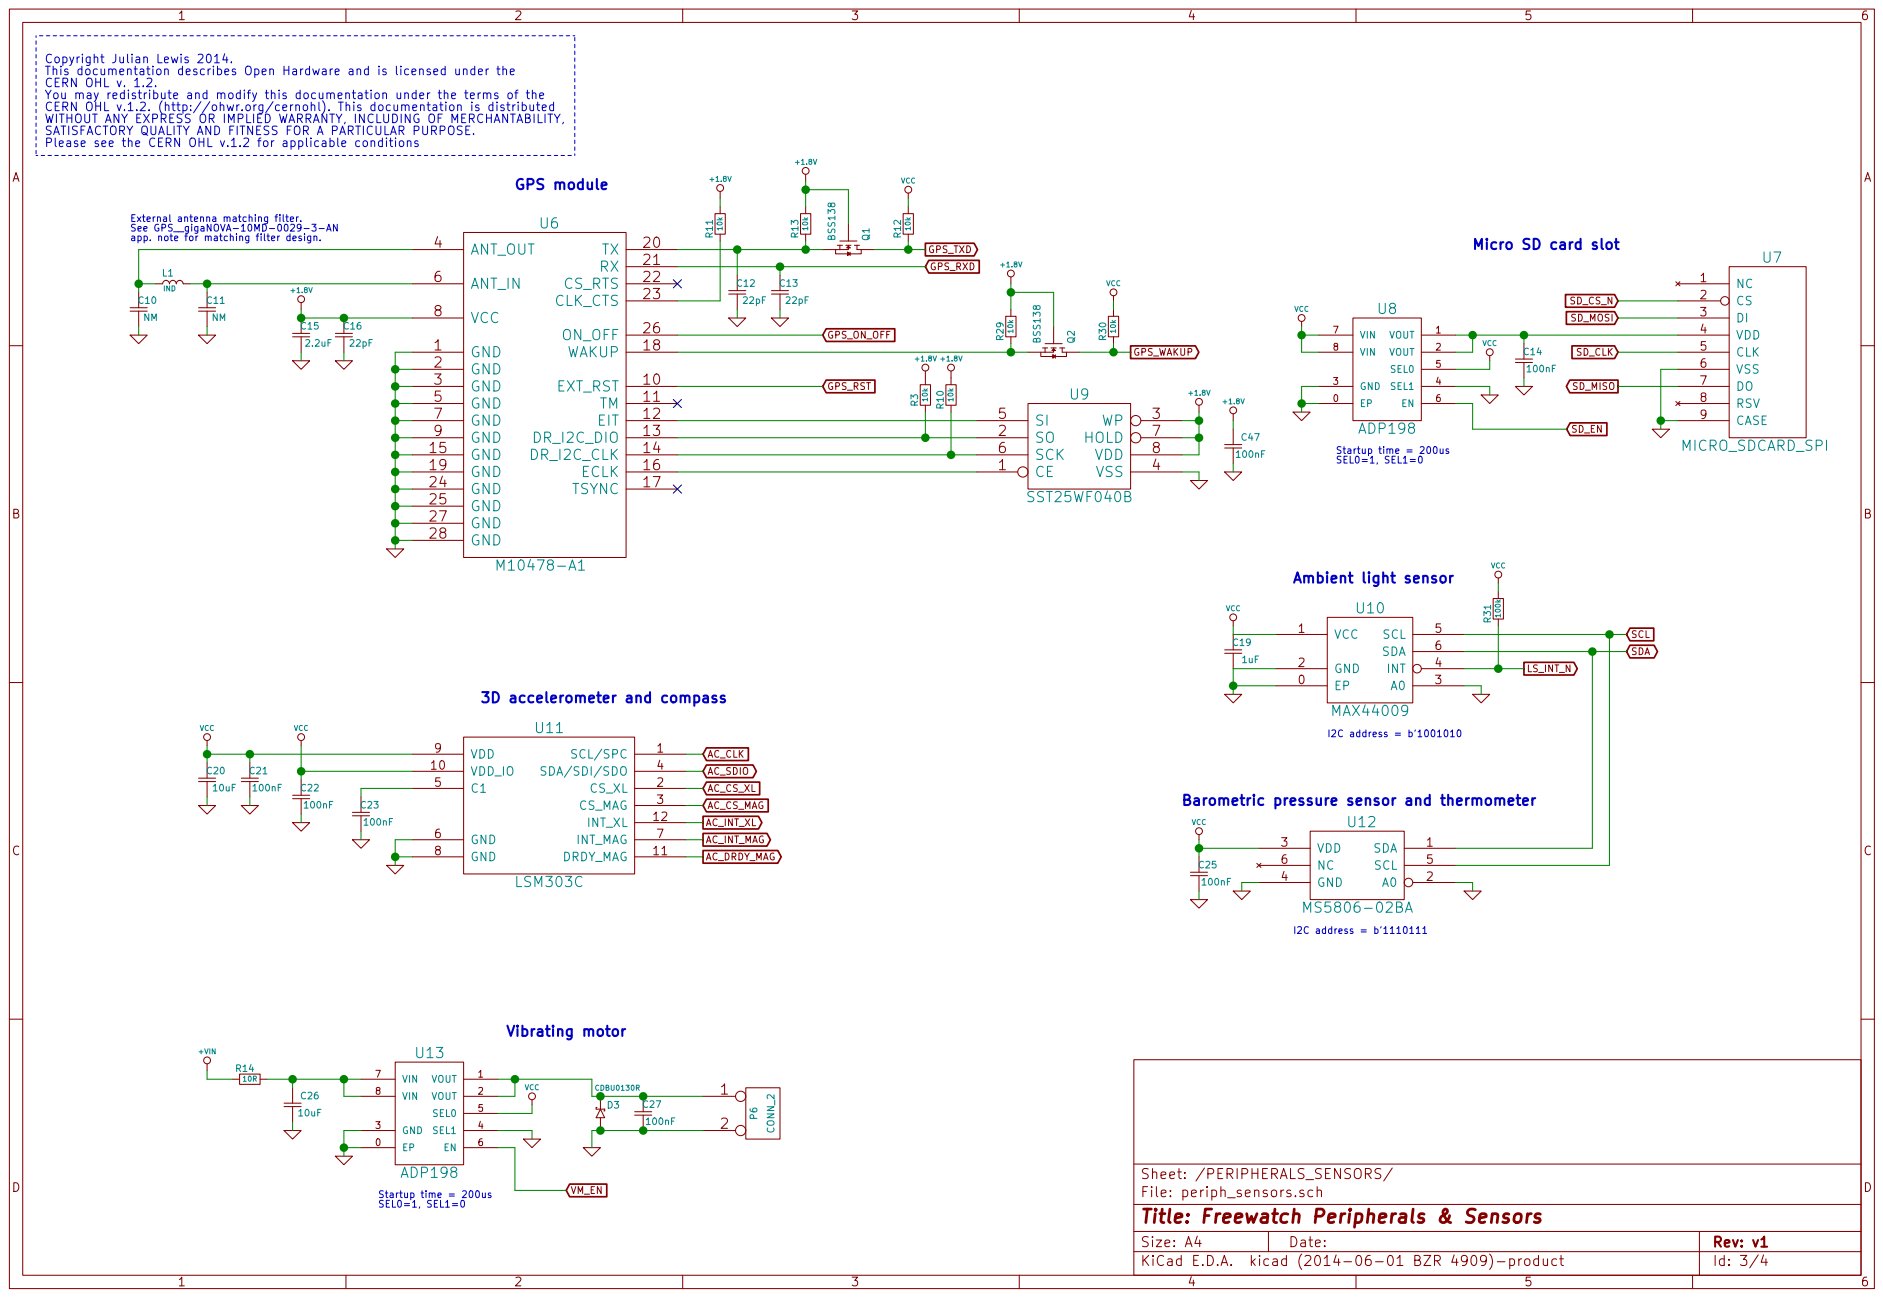
[picture p59: page 3]
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

External antenna matching filter. See GPS__gigaNOVA-10MD-0029-3-AN
app. note for matching filter design.

Micro SD card slot

Barometric pressure sensor and thermometer Startup time = 200us SEL0=1, SEL1=0

File: periph_sensors.sch
Id: 3/4 Title: Freewatch Peripherals & Sensors

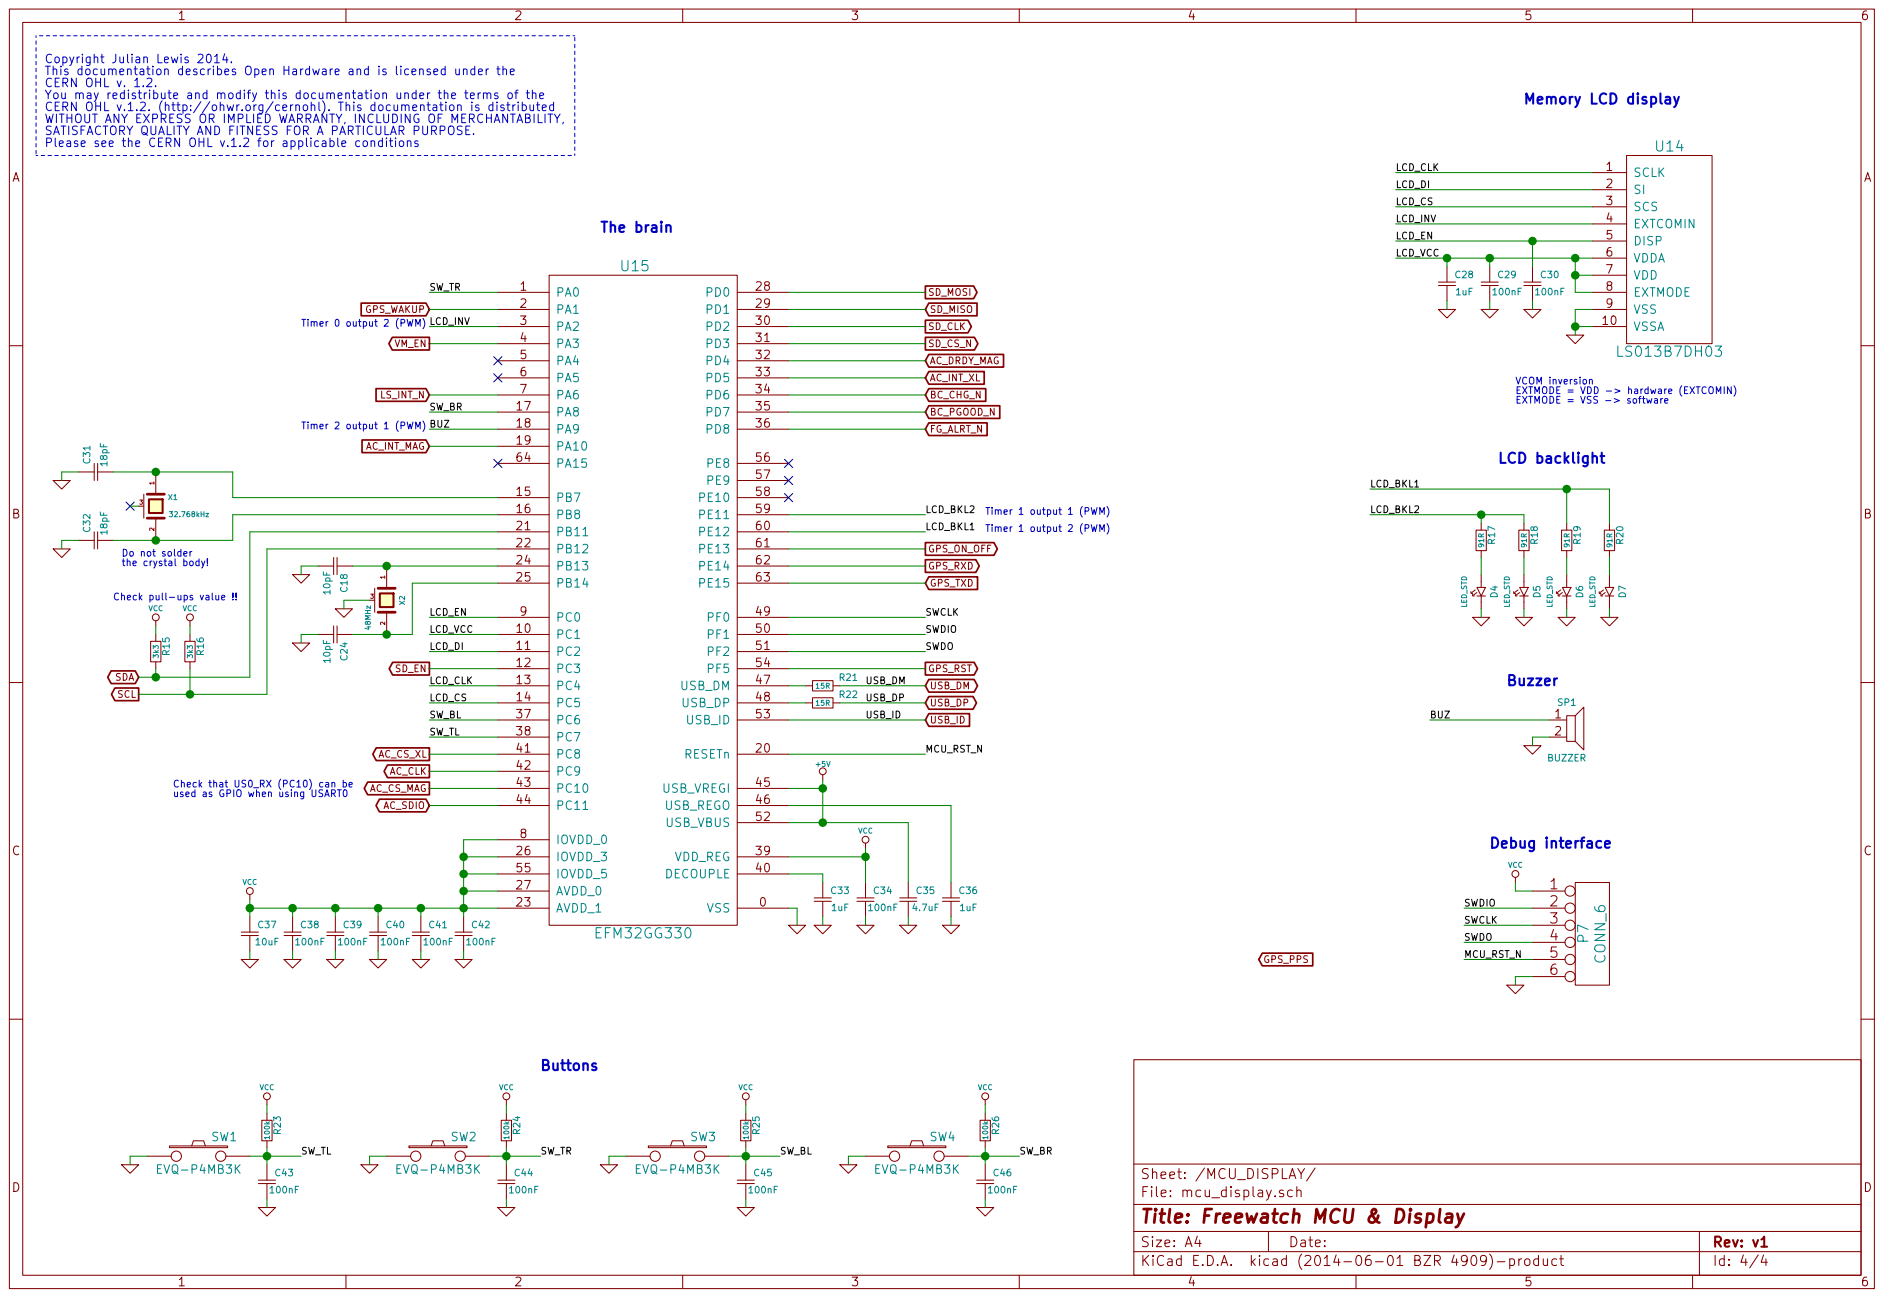
[picture p60: page 4]

This documentation describes Open Hardware and is licensed under the CERN OHL v. 1.2. You may redistribute and modify this documentation under the terms of the
LCD_DI LCD_INV

VCOM inversion EXTMODE = VDD -> hardware (EXTCOMIN) EXTMODE = VSS -> software C29

Check that US0_RX (PC10) can be

File: mcu_display.sch
Id: 4/4 Title: Freewatch MCU & Display
