gymneus/f-watch/freewatch_v1_layout.pdf

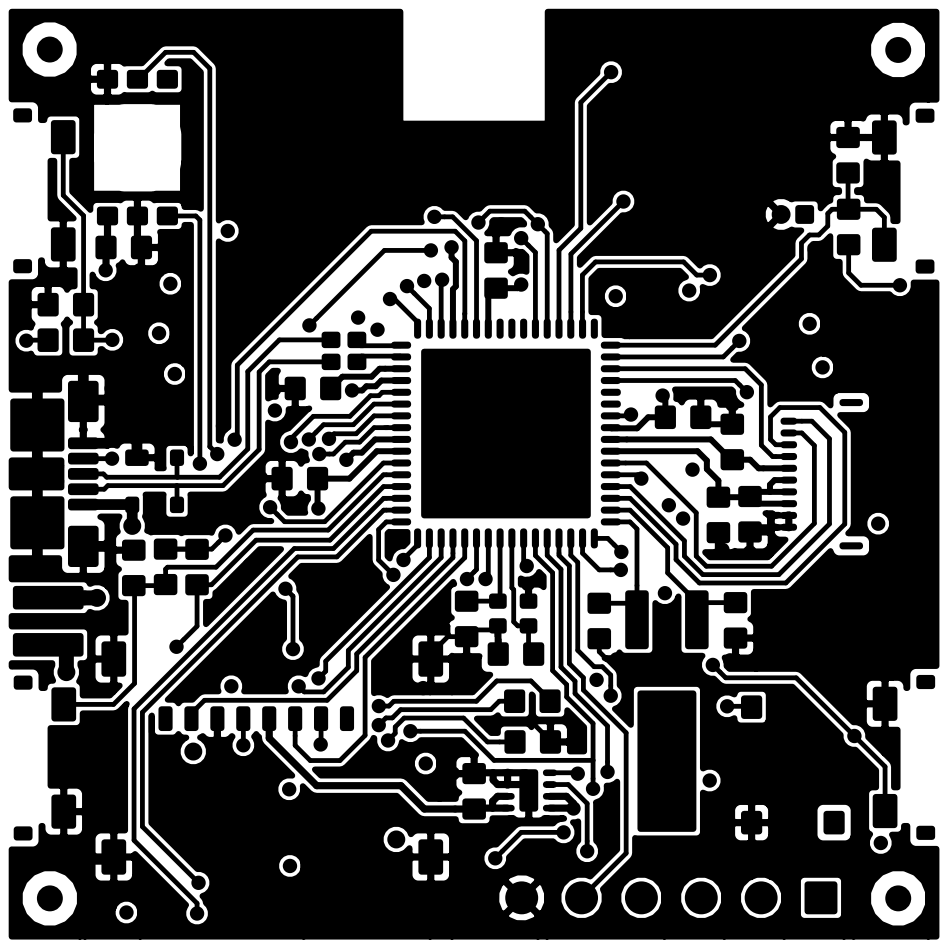
[picture p61: page 1]

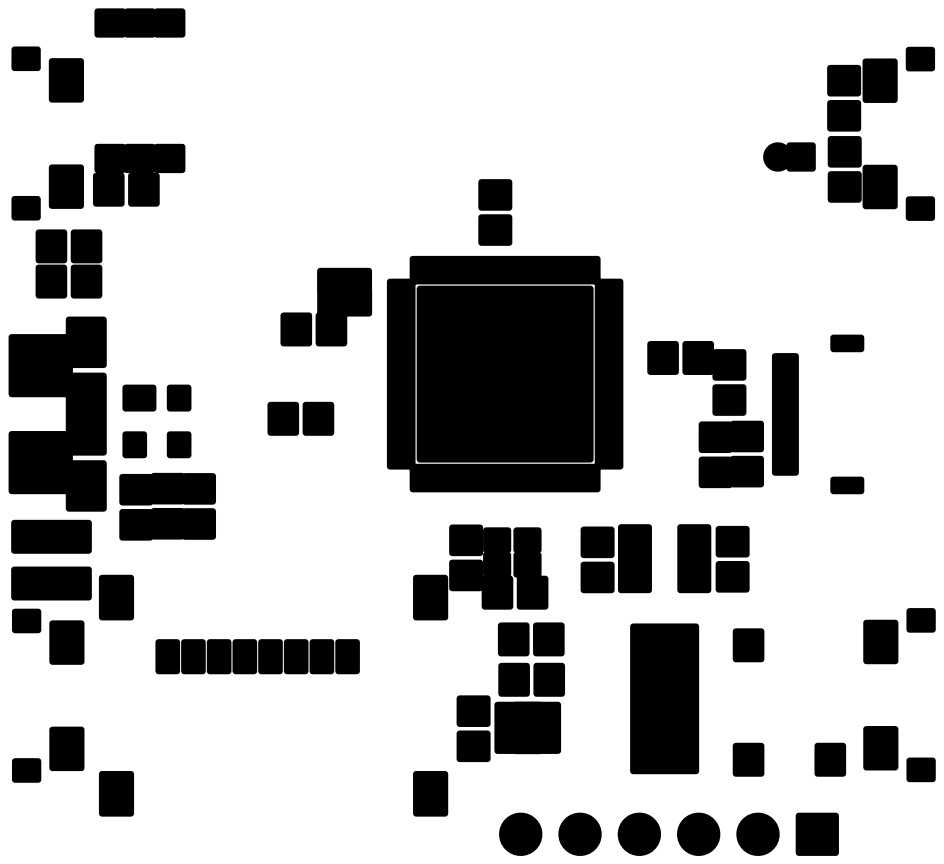
[picture p62: page 2]

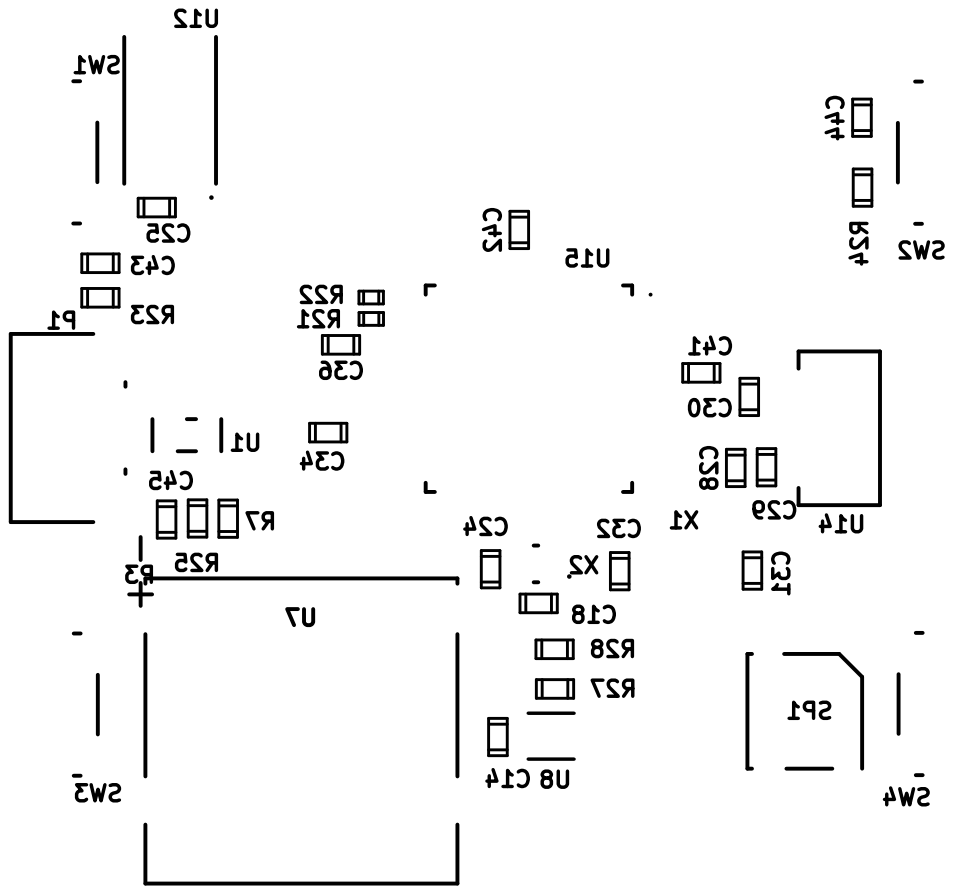
[picture p63: page 4]

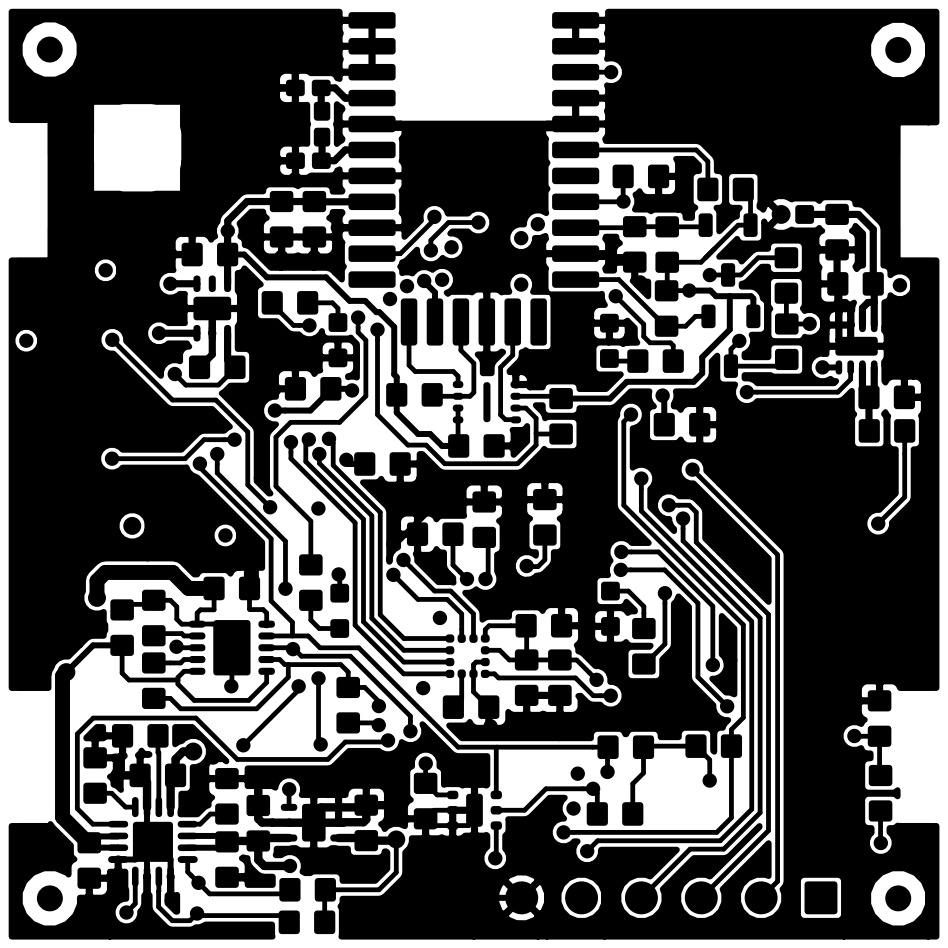
[picture p64: page 6]

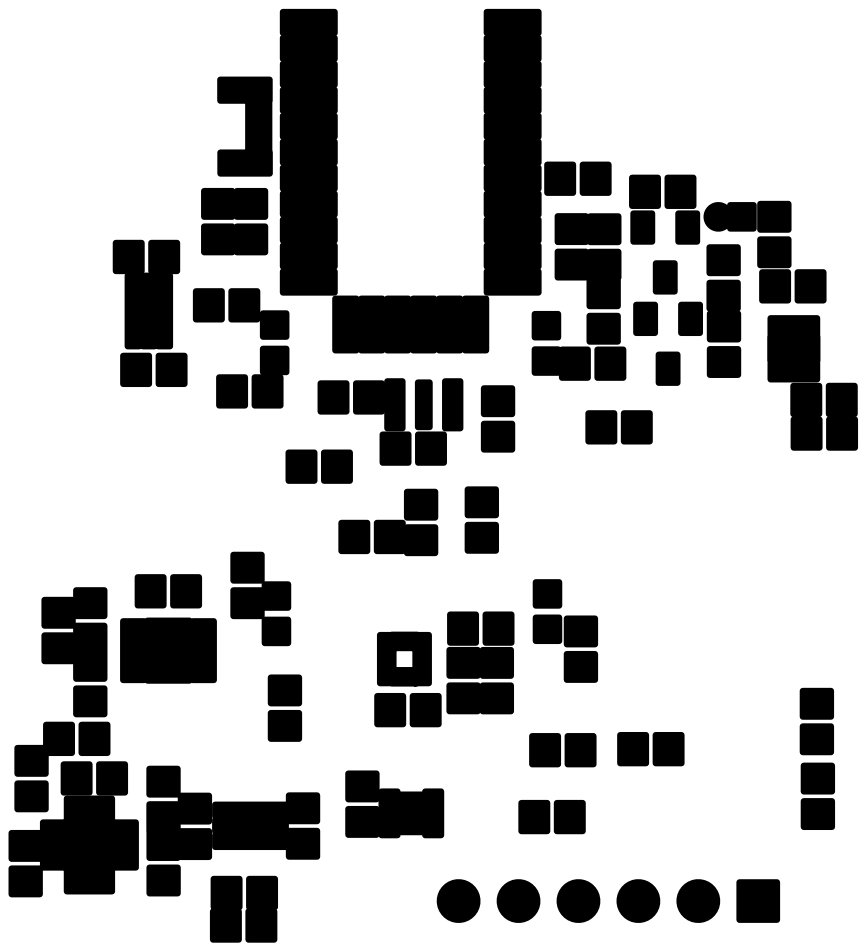
[picture p65: page 7]

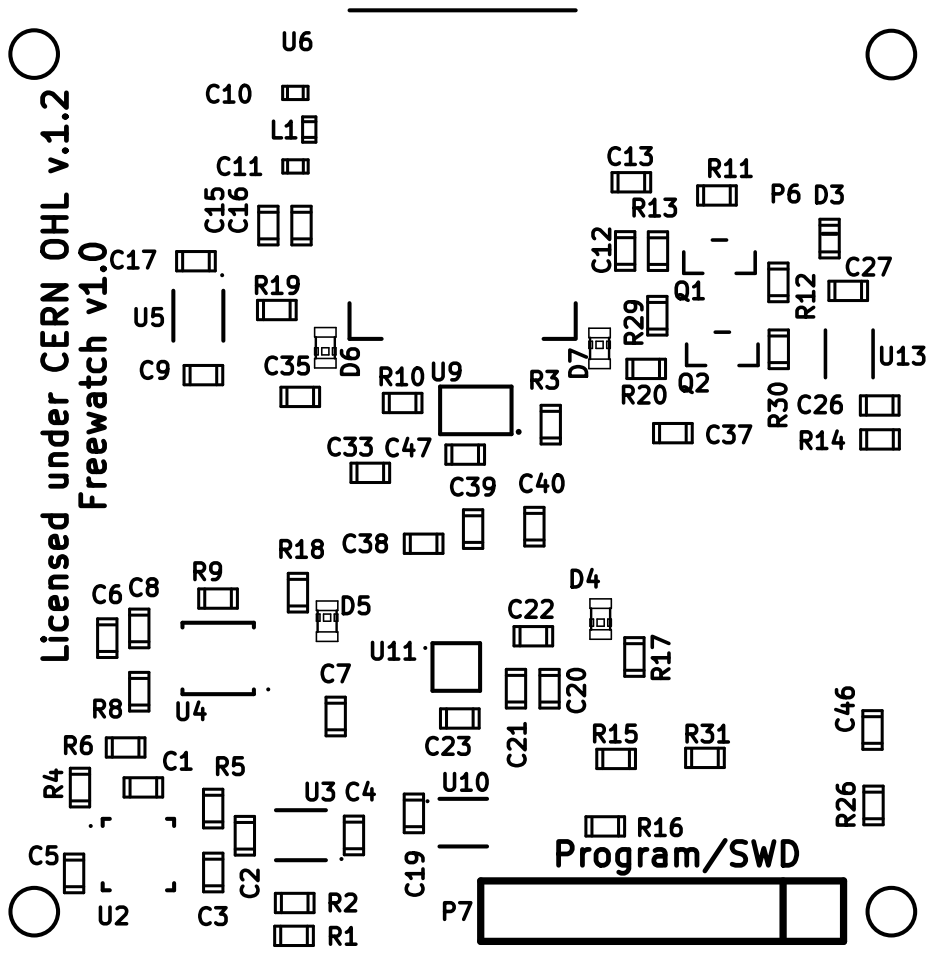
[picture p66: page 9]

Freewatch v1.0 Program/SWD Licensed under CERN OHL v.1.2 C47 R10 U6 C35 C33C38 C39 C40 D7U13 U11 U10 U4 U3 U2 R26 R20 R19R18 R17 R16 R15R13 R12 R11 R9 R8 R6 R5 R4 R2 R1 D3 C46 C37 C27 C23 C22C21 C20 C19 C17 C15 C16 C13 C12 C9 C8 C7 C6 C5 C4 C3 C2 C1 D4 D6 D5 C10 C11 L1 Q1 R3 Q2 R29 R30 U5 P7 P6C26 R14 R31 U9

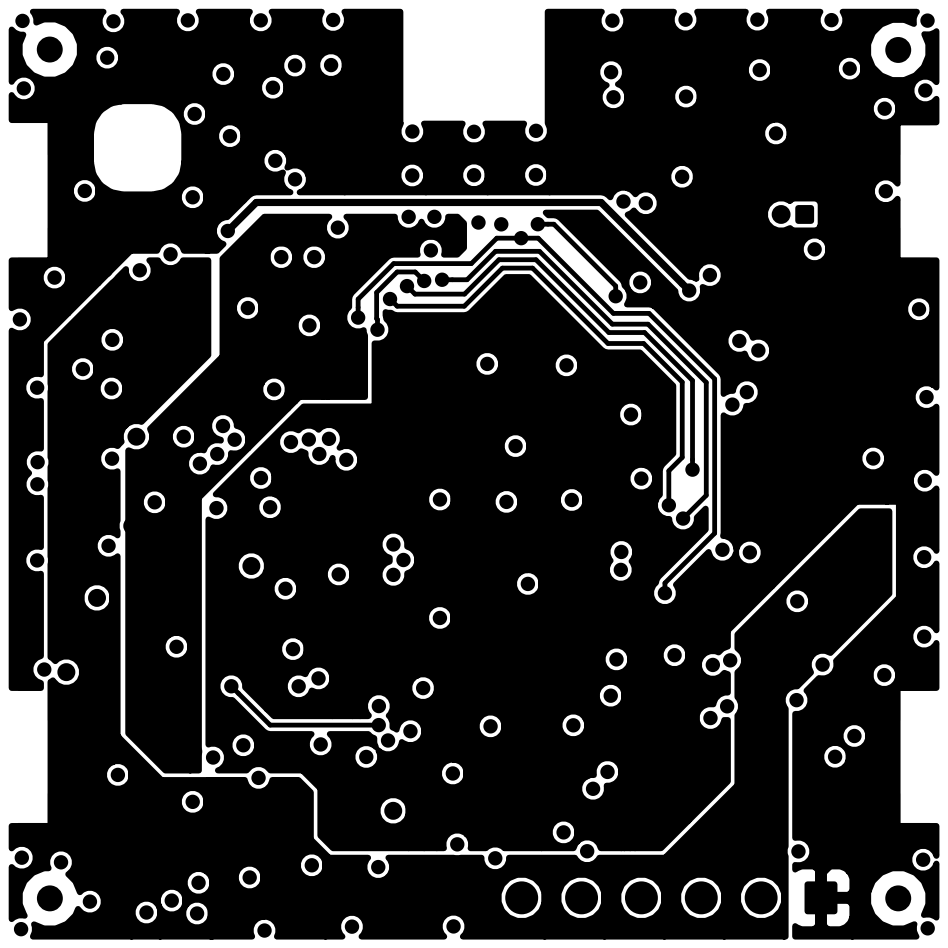
[picture p67: page 10]

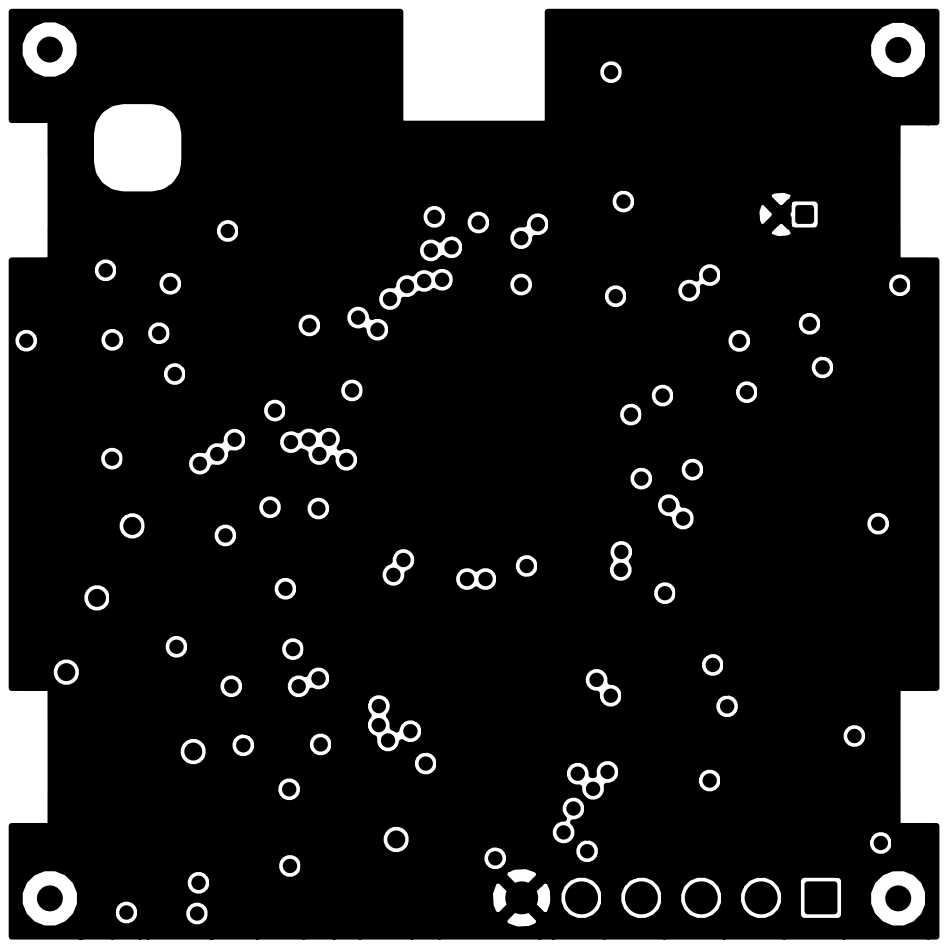
[picture p68: page 11]

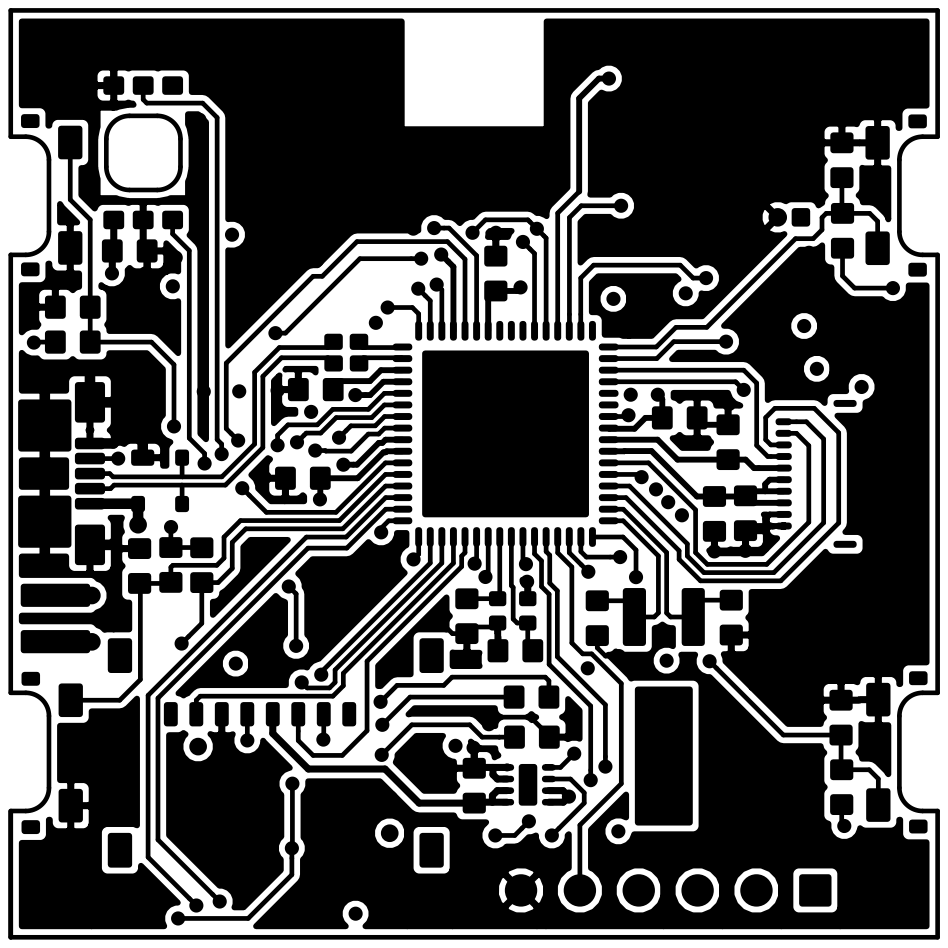
[picture p69: page 12]

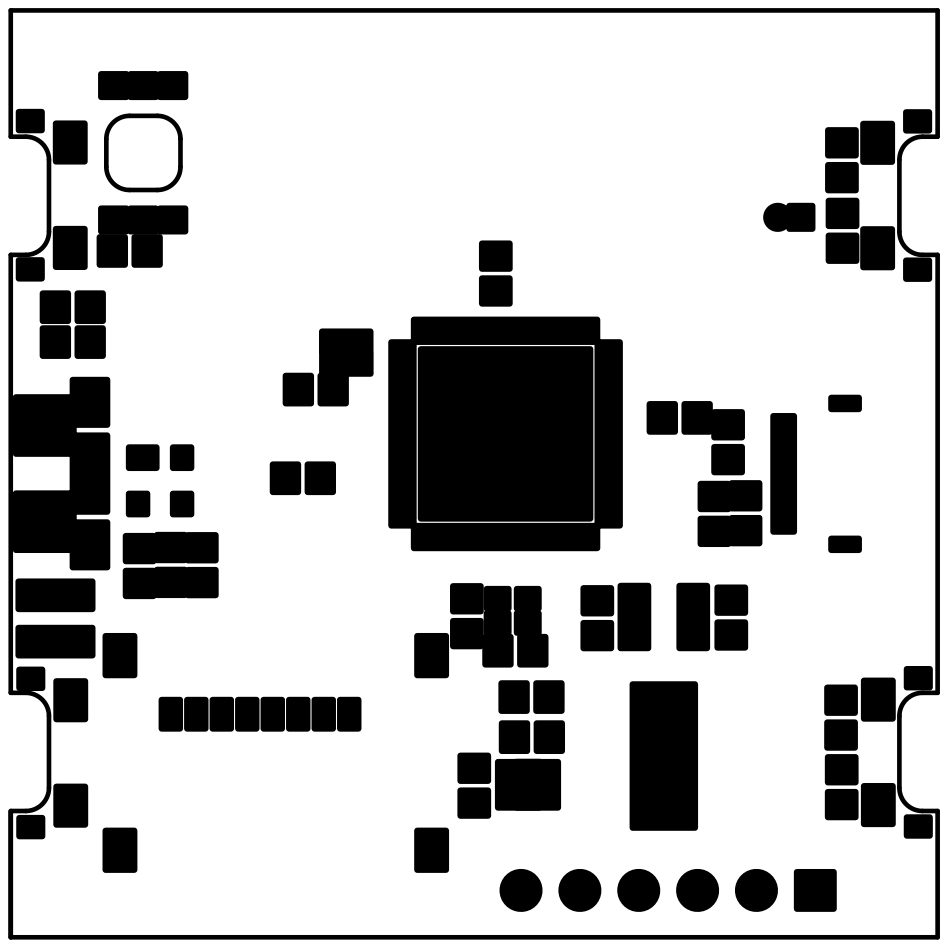
[picture p70: page 13]

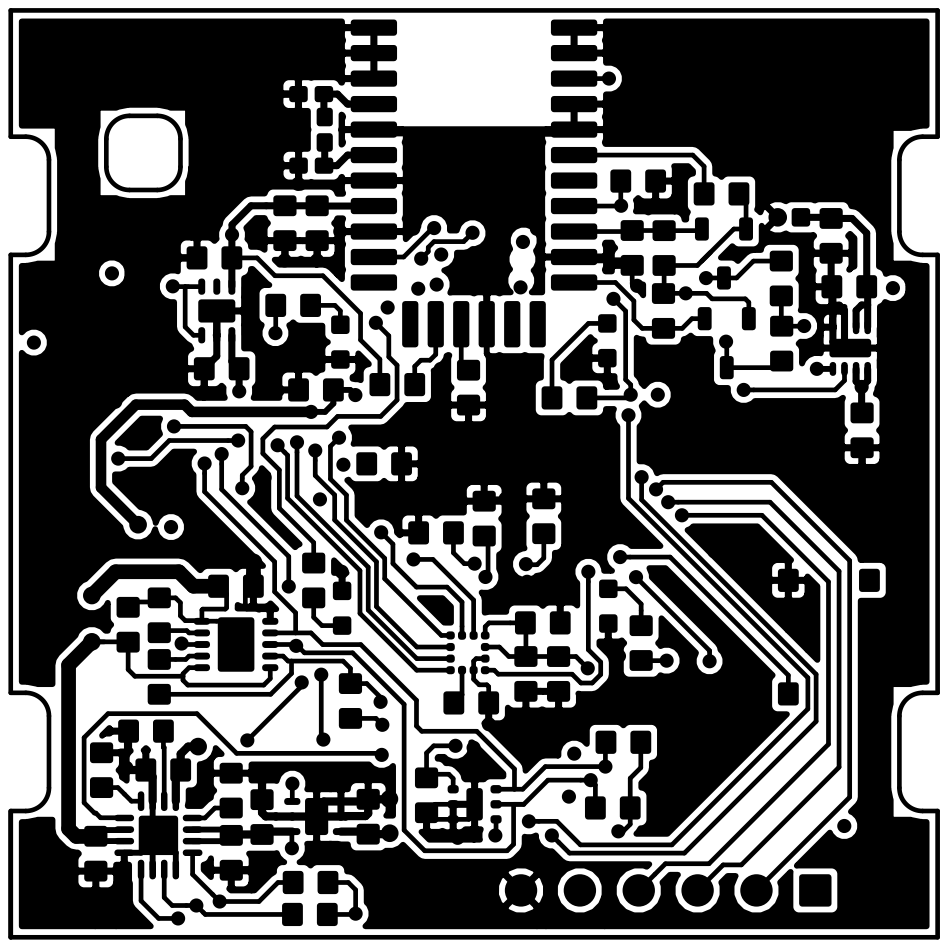
[picture p71: page 17]

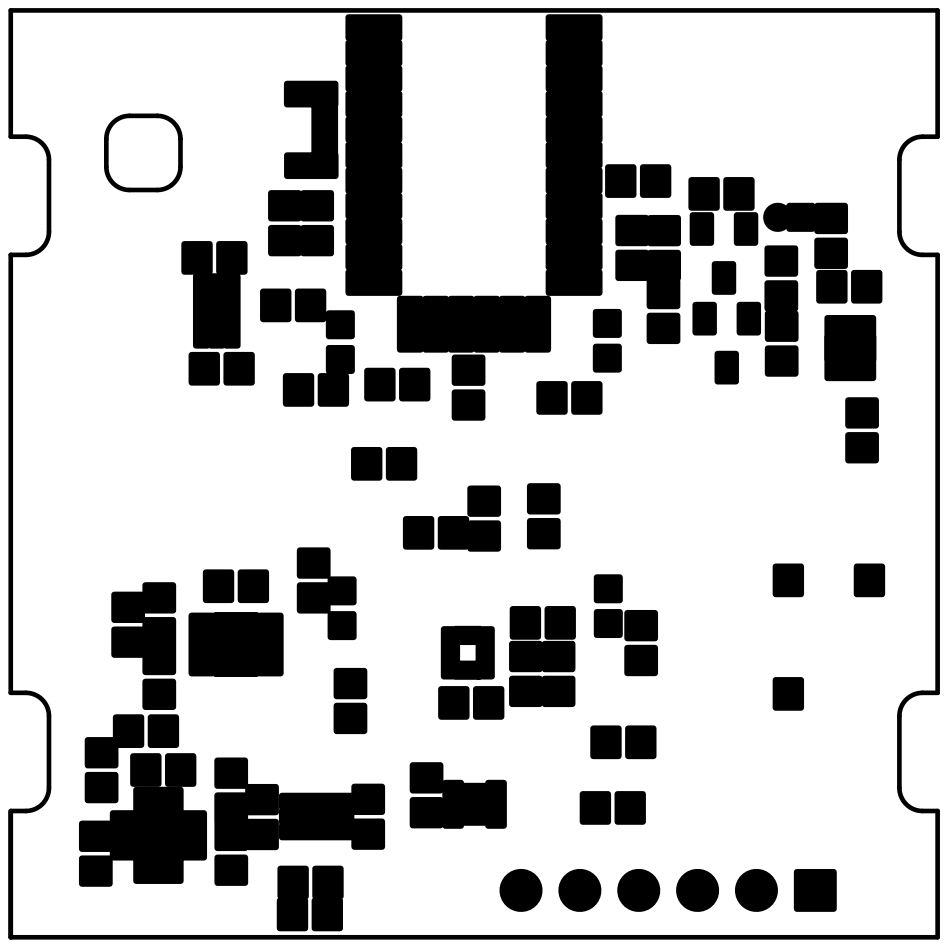
[picture p72: page 18]

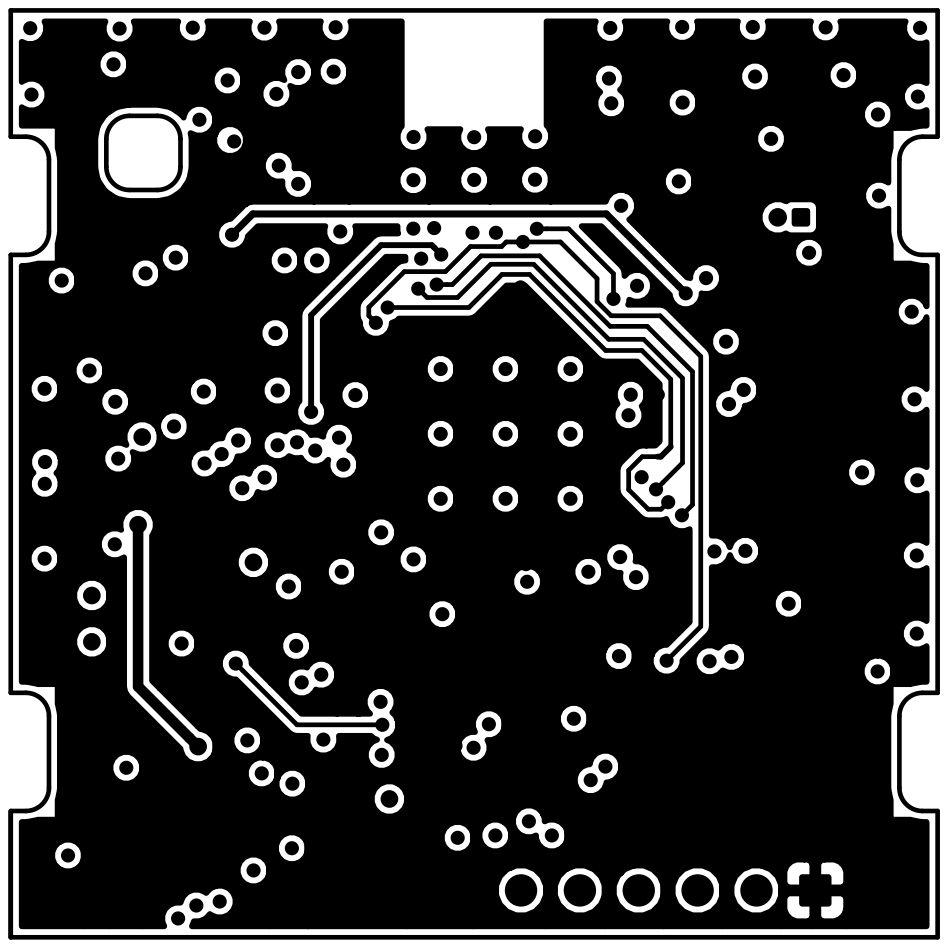
[picture p73: page 21]

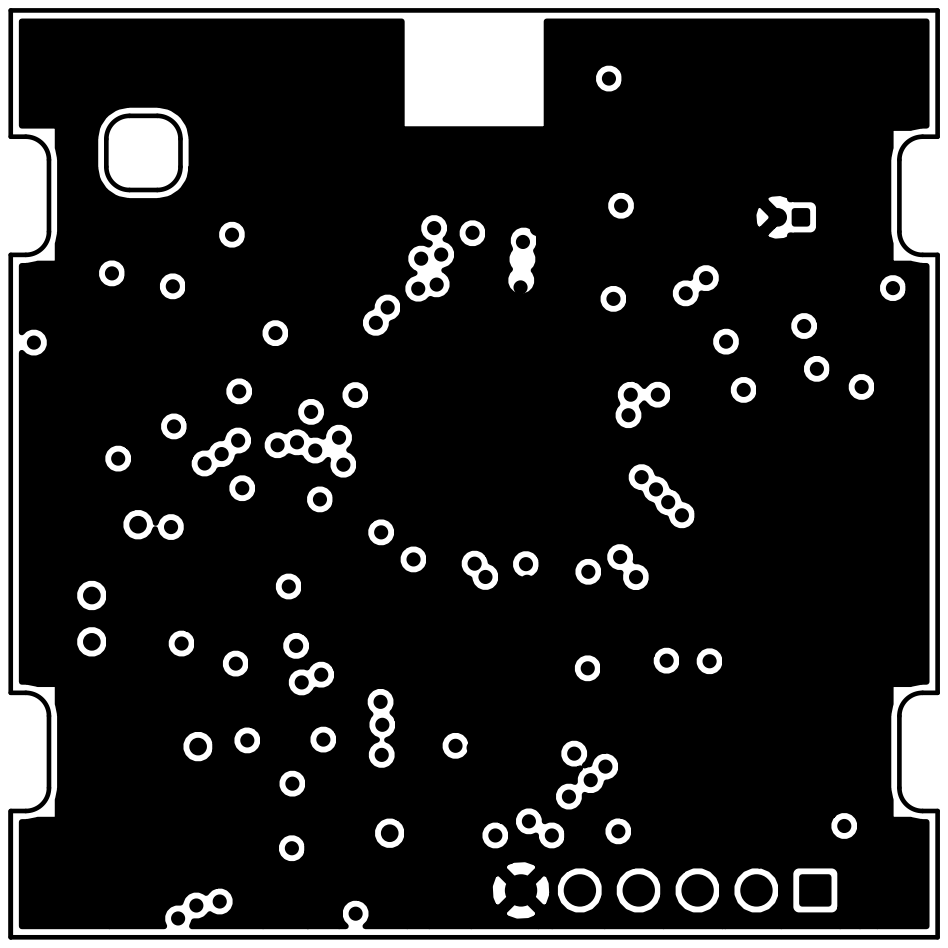
[picture p74: page 22]
