gymneus/f-watch/hw/freewatch_v1/freewatch_v1.kicad_pcb

## KiCad design hw/freewatch_v1/freewatch_v1.kicad_pcb (2014-10-09)

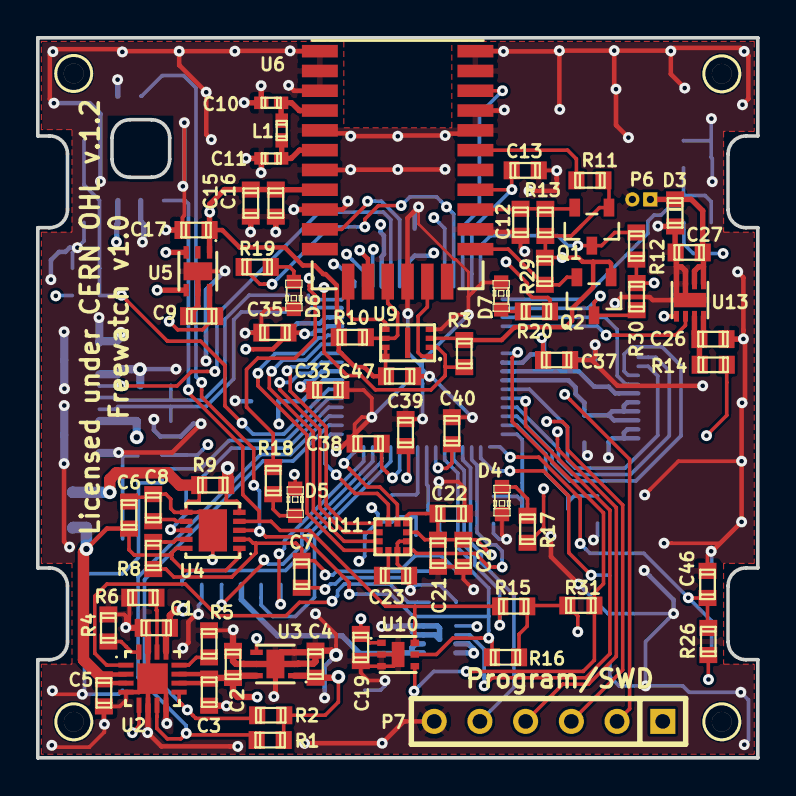
[picture p75: board freewatch_v1.kicad_pcb from above]

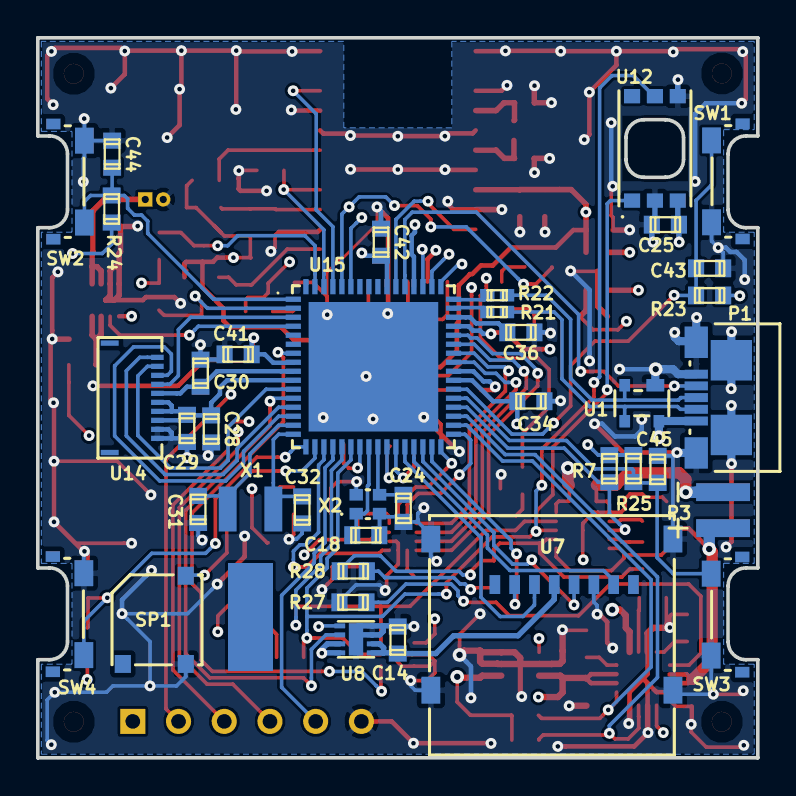
[picture p76: board freewatch_v1.kicad_pcb from below]

Board: 4 copper layers, 40.0 x 40.0 mm, 116 parts (39 on the bottom side), 83 nets.

Parts:
C1, C3, C9, C19, C28, C33, C36: 1uF; c_0603
C2, C4, C5, C17, C35: 4.7uF; c_0603
C6, C8, C14, C21, C22, C23, C25, C27, C29, C30, C34, C38, C39, C40, C41, C42, C43, C44, C45, C46, C47: 100nF; c_0603
C7: 10nF; c_0603
C10, C11: NM; c_0402
C12, C13, C16: 22pF; c_0603
C15: 2.2uF; c_0603
C18, C24: 10pF; c_0603
C20, C26, C37: 10uF; c_0603
C31, C32: 18pF; c_0603
D3: CDBU0130R; d_0603
D4, D5, D6, D7: LED_STD; LED-0603
HOLE_1.1MM, HOLE_1.1MM#2, HOLE_1.1MM#3, HOLE_1.1MM#4: VAL**; HOLE_1.1MM
L1: IND; c_0402
P1: USB-MICRO-AB; USB_MICRO_AB
P3: CONN_2; SMD_BAT_CONN
P6: CONN_2; CONN_1MM_2P
P7: CONN_6; SIL-6
Q1, Q2: BSS138; sot23
R1, R2, R23, R24, R25, R26, R31: 100k; r_0603
R3, R8, R10, R11, R12, R13, R27, R28, R29, R30: 10k; r_0603
R4, R5, R6: RES; r_0603
R7: 200k; r_0603
R9: 10m; r_0603
R14: 10R; r_0603
R15, R16: 3k3; r_0603
R17, R18, R19, R20: 91R; r_0603
R21, R22: 15R; c_0402
SP1: BUZZER; BUZZER_SMT-0540-S-R
SW1, SW2, SW3, SW4: EVQ-P4MB3K; SWITCH_EVQP4
U1: PRTR5V0U2X; SOT143B
U2: bq24072; S-PVQFN-N16
U3, U5: TPS780180300; SON-6
U4: MAX17047; TDFN-10
U6: M10478-A1
U7: MICRO_SDCARD_SPI; CONN_MICRO_SDCARD_1010030368
U8, U13: ADP198; LFCSP_8L
U9: SST25WF040B; USON_2X3
U10: MAX44009; UTDFN6_OPTO
U11: LSM303C; LGA12
U12: MS5806-02BA
U14: LS013B7DH03; FPC_10_503480-1000
U15: EFM32GG330; QFN64
X1: 32.768kHz; AB26TRB
X2: 48MHz; ABM11_CRYSTAL

Connections:
+1.8V: C15.1, C16.1, C17.1, C47.1, Q1.1, Q2.1, R3.2, R10.2, R11.2, R13.2, R29.2, U5.1, U6.8, U9.3, U9.7, U9.8
+5V: C1.1, C35.1, P1.1, U1.4, U2.13, U15.45, U15.52
+BATT: C5.1, C6.1, P3.1, U2.2, U2.3, U4.1, U4.10
+VIN: C2.1, C3.1, C9.1, R14.1, U2.5, U2.10, U2.11, U3.4, U3.6, U5.3, U5.4, U5.6
/MCU_DISPLAY/BUZ: SP1.1, U15.18
/MCU_DISPLAY/LCD_BKL1: R19.1, R20.1, U15.60
/MCU_DISPLAY/LCD_BKL2: R17.1, R18.1, U15.59
/MCU_DISPLAY/LCD_CLK: U14.1, U15.13
/MCU_DISPLAY/LCD_CS: U14.3, U15.14
/MCU_DISPLAY/LCD_DI: U14.2, U15.11
/MCU_DISPLAY/LCD_EN: C30.1, U14.5, U15.9
/MCU_DISPLAY/LCD_INV: U14.4, U15.3
/MCU_DISPLAY/LCD_VCC: C28.1, C29.1, U14.6, U14.7, U14.8, U15.10
/MCU_DISPLAY/MCU_RST_N: P7.5, U15.20
/MCU_DISPLAY/SWCLK: P7.3, U15.49
/MCU_DISPLAY/SWDIO: P7.2, U15.50
/MCU_DISPLAY/SWDO: P7.4, U15.51
/MCU_DISPLAY/SW_BL: C45.1, R25.2, SW3.2, U15.37
/MCU_DISPLAY/SW_BR: C46.1, R26.2, SW4.2, U15.17
/MCU_DISPLAY/SW_TL: C43.1, R23.2, SW1.2, U15.38
/MCU_DISPLAY/SW_TR: C44.1, R24.2, SW2.2, U15.1
AC_CLK: U11.1, U15.42
AC_CS_MAG: U11.3, U15.43
AC_CS_XL: U11.2, U15.41
AC_DRDY_MAG: U11.11, U15.32
AC_INT_MAG: U11.7, U15.19
AC_INT_XL: U11.12, U15.33
AC_SDIO: U11.4, U15.44
BC_CHG_N: R2.1, U2.9, U15.34
BC_PGOOD_N: R1.1, U2.7, U15.35
FG_ALRT_N: R7.1, U4.8, U15.36
GND: C1.2, C2.2, C3.2, C4.2, C5.2, C9.2, C10.2, C11.2, C12.2, C13.2, C14.2, C15.2, C16.2, C17.2, C18.2, C19.2, C20.2, C21.2, C22.2, C23.2, C24.2, C25.2, C26.2, C27.2, C28.2, C29.2, C30.2, C31.1, C32.1, C33.2, C34.2, C35.2, C36.2, C37.2, C38.2, C39.2, C40.2, C41.2, C42.2, C43.2, C44.2, C45.2, C46.2, C47.2, D3.1, D4.2, D5.2, D6.2, D7.2, P1.5, P1.6, P1.7, P1.8, P1.9, P6.2, P7.6, R4.1, R5.1, R6.1, R9.2, R27.1, SP1.2, SW1.1, SW2.1, SW3.1, SW4.1, U1.1, U2.4, U2.6, U2.8, U2.15, U2.17, U3.2, U3.3, U3.5, U3.7, U4.5, U5.5, U5.7, U6.1, U6.2, U6.3, U6.5, U6.7, U6.9, U6.15, U6.19, U6.24, U6.25, U6.27, U6.28, U7.6, U7.9, U8.0, U8.3, U8.4, U9.4, U10.0, U10.2, U10.3, U11.6, U11.8, U12.2, U12.4, U13.0, U13.3, U13.4, U14.9, U14.10, U15.0, X2.3
GPS_ON_OFF: U6.26, U15.61
GPS_RST: U6.10, U15.54
GPS_RXD: C13.1, U6.21, U15.62
GPS_TXD: Q1.3, R12.1, U15.63
GPS_WAKUP: Q2.3, R30.1, U15.2
LS_INT_N: R31.1, U10.4, U15.7
unnamed: C6.2, C7.2, C8.2, P3.2, R9.1, R28.1, U4.6, U4.11
unnamed: C7.1, R8.1, R28.2, U4.2
unnamed: C8.1, U4.7
unnamed: C10.1, L1.1, U6.4
unnamed: C11.1, L1.2, U6.6
unnamed: C12.1, Q1.2, R13.1, U6.20
unnamed: C14.1, U7.4, U8.1, U8.2
unnamed: C18.1, U15.24, X2.1
unnamed: C23.1, U11.5
unnamed: C24.1, U15.25, X2.2
unnamed: C26.1, R14.2, U13.7, U13.8
unnamed: C27.1, D3.2, P6.1, U13.1, U13.2
unnamed: C31.2, U15.15, X1.1
unnamed: C32.2, U15.16, X1.2
unnamed: C33.1, U15.40
unnamed: C36.1, U15.46
unnamed: D4.1, R17.2
unnamed: D5.1, R18.2
unnamed: D6.1, R19.2
unnamed: D7.1, R20.2
unnamed: Q2.2, R29.1, U6.18
unnamed: R3.1, U6.13, U9.2
unnamed: R4.2, U2.16
unnamed: R5.2, U2.12
unnamed: R6.2, U2.14
unnamed: R8.2, U4.9
unnamed: R10.1, U6.14, U9.6
unnamed: R11.1, U6.23
unnamed: R21.2, U15.47
unnamed: R22.2, U15.48
unnamed: R27.2, U2.1
unnamed: U6.12, U9.5
unnamed: U6.16, U9.1
SCL: R16.2, U4.3, U10.5, U12.5, U15.22
SDA: R15.2, U4.4, U10.6, U12.1, U15.21
SD_CLK: U7.5, U15.30
SD_CS_N: U7.2, U15.31
SD_EN: U8.6, U15.12
SD_MISO: U7.7, U15.29
SD_MOSI: U7.3, U15.28
USB_DM: P1.2, R21.1, U1.3
USB_DP: P1.3, R22.1, U1.2
USB_ID: P1.4, U15.53
VCC: C4.1, C19.1, C20.1, C21.1, C22.1, C25.1, C34.1, C37.1, C38.1, C39.1, C40.1, C41.1, C42.1, P7.1, R1.2, R2.2, R7.2, R12.2, R15.1, R16.1, R23.1, R24.1, R25.1, R26.1, R30.2, R31.2, U3.1, U8.5, U8.7, U8.8, U10.1, U11.9, U11.10, U12.3, U13.5, U15.8, U15.23, U15.26, U15.27, U15.39, U15.55
VM_EN: U13.6, U15.4
