gymneus/f-watch/hw/efm32_breakout/efm32_breakout.kicad_pcb

## KiCad design hw/efm32_breakout/efm32_breakout.kicad_pcb (2014-06-06)

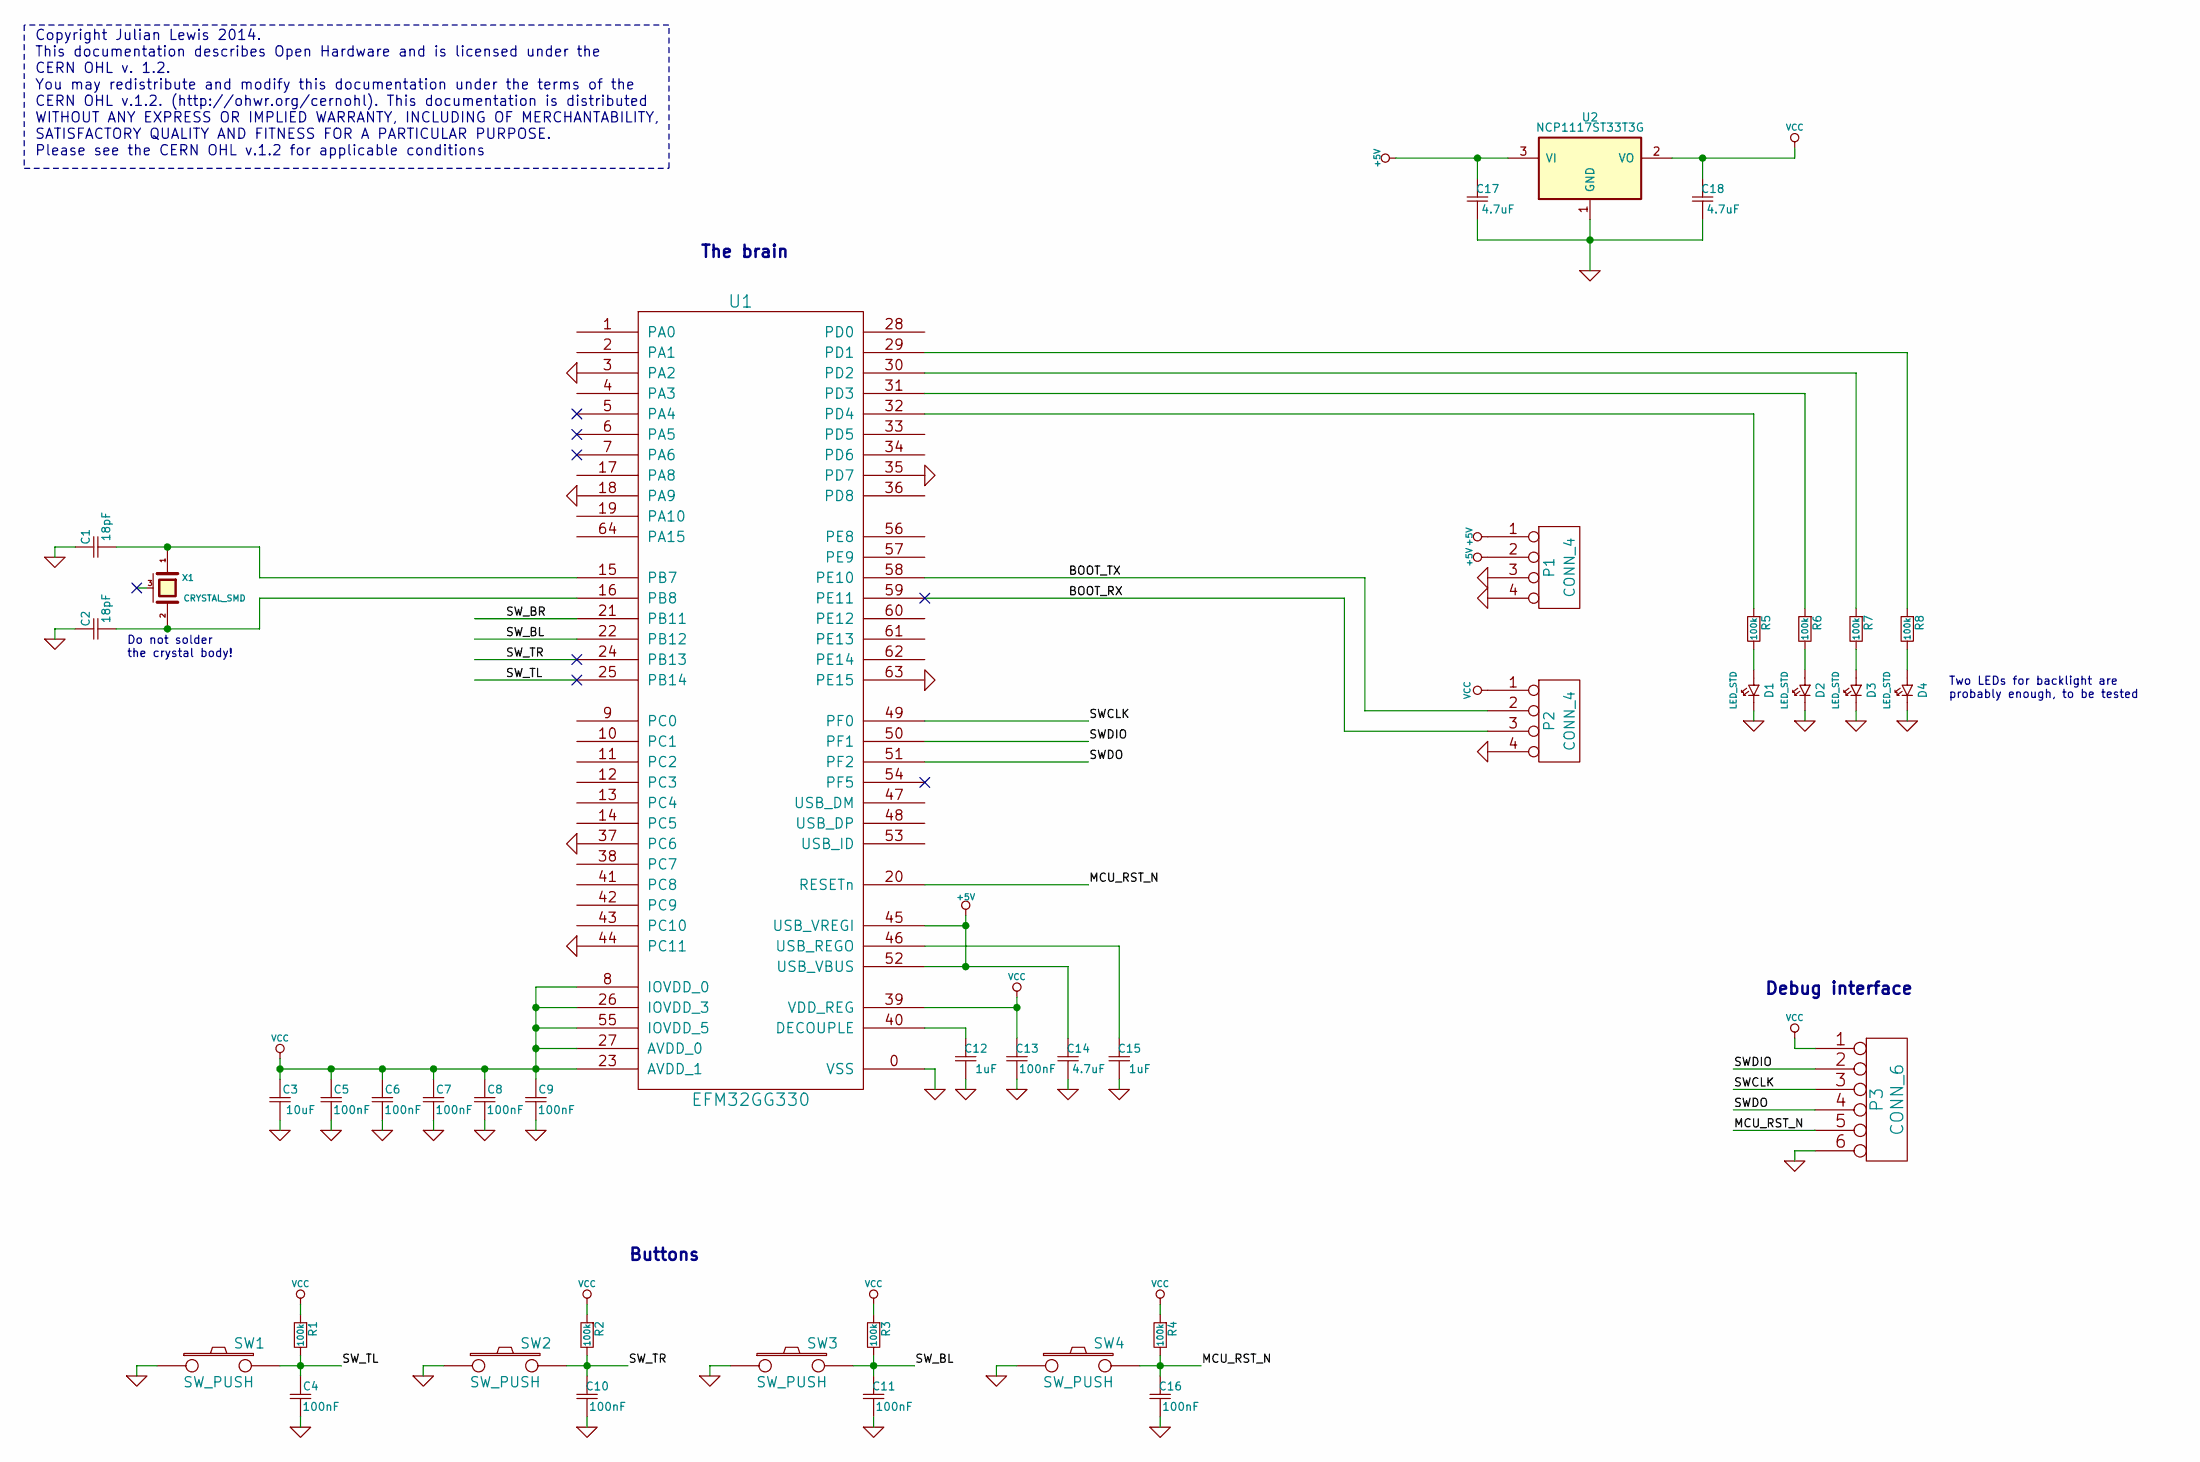
[picture p77: schematic efm32_breakout.sch, Freewatch MCU & Display]

Parts:
C1, C2: 18pF
C3: 10uF
C4, C5, C6, C7, C8, C9, C10, C11, C13, C16: 100nF
C12, C15: 1uF
C14, C17, C18: 4.7uF
D1, D2, D3, D4: LED_STD
P1, P2: CONN_4
P3: CONN_6
R1, R2, R3, R4, R5, R6, R7, R8: 100k
SW1, SW2, SW3, SW4: SW_PUSH
U1: EFM32GG330
U2: NCP1117ST33T3G
X1: CRYSTAL_SMD

Connections:
+5V: C14.1, C17.1, P1.1, P1.2, U1.45 (USB_VREGI), U1.52 (USB_VBUS), U2.3 (VI)
/BOOT_RX: P2.3, U1.59 (PE11)
/BOOT_TX: P2.2, U1.58 (PE10)
/MCU_RST_N: C16.1, P3.5, R4.2, SW4.2, U1.20 (RESETn)
/SWCLK: P3.3, U1.49 (PF0)
/SWDIO: P3.2, U1.50 (PF1)
/SWDO: P3.4, U1.51 (PF2)
/SW_BL: C11.1, R3.2, SW3.2, U1.22 (PB12)
/SW_BR: U1.21 (PB11)
/SW_TL: C4.1, R1.2, SW1.2, U1.25 (PB14)
/SW_TR: C10.1, R2.2, SW2.2, U1.24 (PB13)
GND: C1.1, C2.1, C3.2, C4.2, C5.2, C6.2, C7.2, C8.2, C9.2, C10.2, C11.2, C12.2, C13.2, C14.2, C15.2, C16.2, C17.2, C18.2, D1.2 (K), D2.2 (K), D3.2 (K), D4.2 (K), P1.3, P1.4, P2.4, P3.6, SW1.1, SW2.1, SW3.1, SW4.1, U1.0 (VSS), U1.3 (PA2), U1.18 (PA9), U1.35 (PD7), U1.37 (PC6), U1.44 (PC11), U1.63 (PE15), U2.1 (GND)
unnamed: C1.2, U1.15 (PB7), X1.1
unnamed: C2.2, U1.16 (PB8), X1.2
unnamed: C12.1, U1.40 (DECOUPLE)
unnamed: C15.1, U1.46 (USB_REGO)
unnamed: D1.1 (A), R5.2
unnamed: D2.1 (A), R6.2
unnamed: D3.1 (A), R7.2
unnamed: D4.1 (A), R8.2
unnamed: R5.1, U1.32 (PD4)
unnamed: R6.1, U1.31 (PD3)
unnamed: R7.1, U1.30 (PD2)
unnamed: R8.1, U1.29 (PD1)
VCC: C3.1, C5.1, C6.1, C7.1, C8.1, C9.1, C13.1, C18.1, P2.1, P3.1, R1.1, R2.1, R3.1, R4.1, U1.8 (IOVDD_0), U1.23 (AVDD_1), U1.26 (IOVDD_3), U1.27 (AVDD_0), U1.39 (VDD_REG), U1.55 (IOVDD_5), U2.2 (VO)

Notes on the sheet:
Copyright Julian Lewis 2014. This documentation describes Open Hardware and is licensed under the CERN OHL v. 1.2. You may redistribute and modify this documentation under the terms of the CERN OHL v.1.2. (http://ohwr.org/cernohl). This documentation is distributed WITHOUT ANY EXPRESS OR IMPLIED WA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
Do not solder the crystal body!
Debug interface
Buttons
The brain
Two LEDs for backlight are probably enough, to be tested

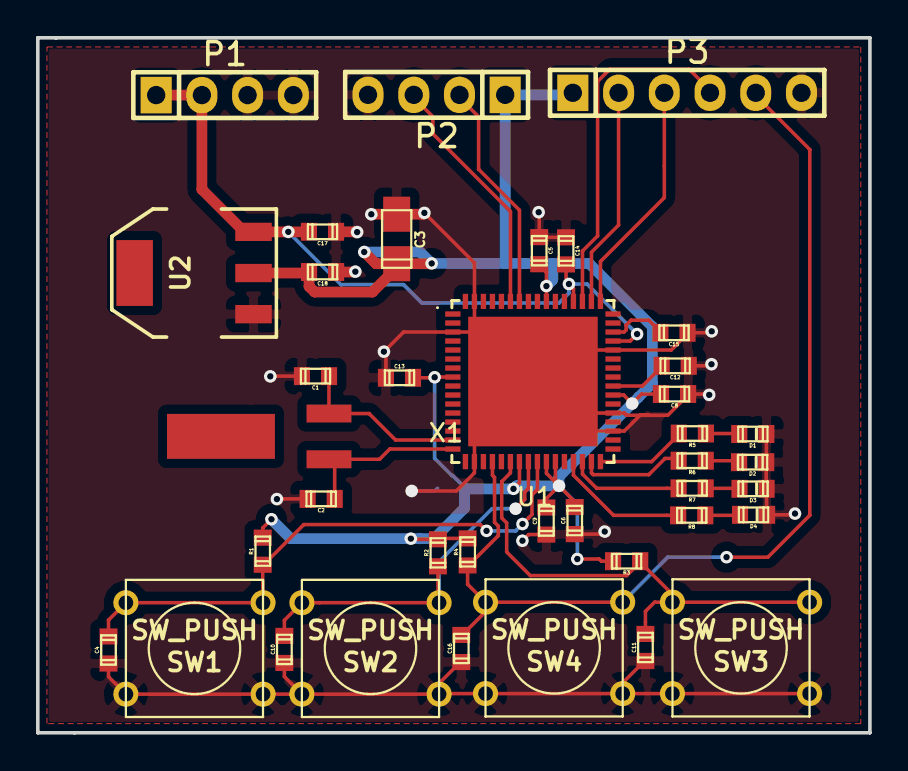
[picture p78: board efm32_breakout.kicad_pcb from above]

Board: 2 copper layers, 46.2 x 38.6 mm, 40 parts (1 on the bottom side), 24 nets.
