gymneus/f-watch/sw/common/kits/common/drivers/dmactrl.c

/***************************************************************************//**
 * @file
 * @brief DMA control data block.
 * @version 3.20.5
 *******************************************************************************
 * @section License
 * <b>(C) Copyright 2014 Silicon Labs, http://www.silabs.com</b>
 *******************************************************************************
 *
 * This file is licensensed under the Silabs License Agreement. See the file
 * "Silabs_License_Agreement.txt" for details. Before using this software for
 * any purpose, you must agree to the terms of that agreement.
 *
 ******************************************************************************/




#include "em_device.h"
#include "dmactrl.h"

#if ( ( DMA_CHAN_COUNT > 4 ) && ( DMA_CHAN_COUNT <= 8 ) )
#define DMACTRL_CH_CNT      8
#define DMACTRL_ALIGNMENT   256

#elif ( ( DMA_CHAN_COUNT > 8 ) && ( DMA_CHAN_COUNT <= 16 ) )
#define DMACTRL_CH_CNT      16
#define DMACTRL_ALIGNMENT   512

#else
#error "Unsupported DMA channel count (dmactrl.c)."
#endif


/** DMA control block array, requires proper alignment. */
#if defined (__ICCARM__)
#pragma data_alignment=DMACTRL_ALIGNMENT
DMA_DESCRIPTOR_TypeDef dmaControlBlock[DMACTRL_CH_CNT * 2];

#elif defined (__CC_ARM)
DMA_DESCRIPTOR_TypeDef dmaControlBlock[DMACTRL_CH_CNT * 2] __attribute__ ((aligned(DMACTRL_ALIGNMENT)));

#elif defined (__GNUC__)
DMA_DESCRIPTOR_TypeDef dmaControlBlock[DMACTRL_CH_CNT * 2] __attribute__ ((aligned(DMACTRL_ALIGNMENT)));

#else
#error Undefined toolkit, need to define alignment
#endif
