gymneus/f-watch/sw/common/drivers/lcd.h

/*
 * Copyright (C) 2014 Julian Lewis
 * @author Maciej Suminski <maciej.suminski@cern.ch>
 * @author Bartosz Bielawski <bartosz.bielawski@cern.ch>
 *
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
 * You should have received a copy of the GNU General Public License
 * along with this program; if not, you may find one here:
 * http://www.gnu.org/licenses/gpl-3.0-standalone.html
 * or you may search the http://www.gnu.org website for the version 3 license,
 * or you may write to the Free Software Foundation, Inc.,
 * 51 Franklin Street, Fifth Floor, Boston, MA  02110-1301, USA
 */

/**
 * @brief LS013B7DH03 LCD driver
 */

#ifndef LCD_H
#define LCD_H

#include "em_gpio.h"

#ifdef FREERTOS
#include <FreeRTOS.h>
#include <semphr.h>
extern xSemaphoreHandle lcd_sem;
#endif /* FREERTOS */

// DMA is broken when EM2 or deeper is enabled
#if configSLEEP_MODE > 1
#define LCD_NODMA
#endif

// Dimensions
#define LCD_HEIGHT          128
#define LCD_WIDTH           128

// Enable 90* rotation
#define LCD_ROTATE_90

// Pinout
#define LCD_PORT_SCLK       gpioPortC
#define LCD_PIN_SCLK        4
#define LCD_PORT_SI         gpioPortC
#define LCD_PIN_SI          2
#define LCD_PORT_SCS        gpioPortC
#define LCD_PIN_SCS         5
#define LCD_PORT_EXTCOMIN   gpioPortA
#define LCD_PIN_EXTCOMIN    2
#define LCD_PORT_DISP_SEL   gpioPortC
#define LCD_PIN_DISP_SEL    0
#define LCD_PORT_DISP_PWR   gpioPortC
#define LCD_PIN_DISP_PWR    1

// Types of SPI commands
#define LCD_CMD_UPDATE      0x01
#define LCD_CMD_ALL_CLEAR   0x04

// Peripherals
#define LCD_SPI_UNIT        USART2
#define LCD_SPI_CLOCK       cmuClock_USART2
#define LCD_SPI_LOCATION    USART_ROUTE_LOCATION_LOC0
#define LCD_SPI_BAUDRATE    500000
#define LCD_POL_INV_FREQ    60

// Additional bytes to control the LCD; stored in framebuffer, required for DMA transfers
#define LCD_CONTROL_BYTES       2

// Number of bytes to store one line
#define LCD_STRIDE          (LCD_WIDTH / 8 + LCD_CONTROL_BYTES)

// Framebuffer size (in bytes)
#define LCD_BUF_SIZE        (LCD_STRIDE * LCD_HEIGHT + LCD_CONTROL_BYTES)

/**
 * @brief LCD initialization routine.
 */
void lcd_init(void);

/**
 * @brief Controls DISP_EN pin - it allows to turn off the display, but preserve the memory.
 * @param uint8_t enable enables the display if greater than 0.
 */
void lcd_enable(uint8_t enable);

/**
 * @brief Controls power for the display.
 * @param uint8_t enable turns on the power if greater than 0.
 */
void lcd_power(uint8_t enable);

/**
 * @brief Clears the LCD and the framebuffer.
 */
void lcd_clear(void);

/**
 * @brief Refreshes the screen with the framebuffer contents.
 */
void lcd_update(void);

/**
 * @brief Switches on/off a single pixel.
 * @param uint8_t x is the x coordinate of the pixel.
 * @param uint8_t y is the y coordinate of the pixel.
 * @param uint8_t value turns off the pixel if 0, turns on otherwise.
 */
static inline void lcd_set_pixel(uint8_t x, uint8_t y, uint8_t value)
{
    extern uint8_t * const off_buffer;

    // x %= LCD_WIDTH;
    // y %= LCD_HEIGHT;

#if defined(LCD_ROTATE_90)
    uint8_t mask = 0x80 >> (y & 0x07);
    uint16_t offset = (x * LCD_STRIDE) + ((LCD_HEIGHT - 1 - y) >> 3);
#elif defined(LCD_ROTATE_270)
    uint8_t mask = 1 << (y & 0x07);
    uint16_t offset = ((LCD_WIDTH - x - 1) * LCD_STRIDE) + (y >> 3);
#else
    uint8_t mask = 1 << (x & 0x07);                 // == 1 << (x % 8)
    uint16_t offset = (y * LCD_STRIDE) + (x >> 3);  // == y * LCD_STRIDE + x / 8
#endif

    if(value)
        off_buffer[offset] |= mask;
    else
        off_buffer[offset] &= ~mask;
}

/**
 * @brief Toggles a single pixel.
 * @param uint8_t x is the x coordinate of the pixel.
 * @param uint8_t y is the y coordinate of the pixel.
 */
static inline void lcd_toggle_pixel(uint8_t x, uint8_t y)
{
    extern uint8_t * const off_buffer;

    // x %= LCD_WIDTH;
    // y %= LCD_HEIGHT;

#if defined(LCD_ROTATE_90)
    uint8_t mask = 0x80 >> (y & 0x07);
    uint16_t offset = (x * LCD_STRIDE) + ((LCD_HEIGHT - 1 - y) >> 3);
#elif defined(LCD_ROTATE_270)
    uint8_t mask = 1 << (y & 0x07);
    uint16_t offset = ((LCD_WIDTH - x - 1) * LCD_STRIDE) + (y >> 3);
#else
    uint8_t mask = 1 << (x & 0x07);                 // == 1 << (x % 8)
    uint16_t offset = (y * LCD_STRIDE) + (x >> 3);  // == y * LCD_STRIDE + x / 8
#endif

    off_buffer[offset] ^= mask;
}

/**
 * @brief Returns the state of a single pixel.
 * @param uint8_t x is the x coordinate of the pixel.
 * @param uint8_t y is the y coordinate of the pixel.
 */
static inline uint8_t lcd_get_pixel(uint8_t x, uint8_t y)
{
    extern uint8_t * const off_buffer;

    // x %= LCD_WIDTH;
    // y %= LCD_HEIGHT;

#if defined(LCD_ROTATE_90)
    uint8_t mask = 0x80 >> (y & 0x07);
    uint16_t offset = (x * LCD_STRIDE) + ((LCD_HEIGHT - 1 - y) >> 3);
#elif defined(LCD_ROTATE_270)
    uint8_t mask = 1 << (y & 0x07);
    uint16_t offset = ((LCD_WIDTH - x - 1) * LCD_STRIDE) + (y >> 3);
#else
    uint8_t mask = 1 << (x & 0x07);                 // == 1 << (x % 8)
    uint16_t offset = (y * LCD_STRIDE) + (x >> 3);  // == y * LCD_STRIDE + x / 8
#endif

    return off_buffer[offset] & mask;
}

#endif /* LCD_H */
