gymneus/f-watch/sw/common/kits/common/drivers/msdscsi.c

/***************************************************************************//**
 * @file  msdscsi.c
 * @brief SCSI interface for Mass Storage Devices (MSD).
 * @version 3.20.5
 *******************************************************************************
 * @section License
 * <b>(C) Copyright 2014 Silicon Labs, http://www.silabs.com</b>
 *******************************************************************************
 *
 * This file is licensensed under the Silabs License Agreement. See the file
 * "Silabs_License_Agreement.txt" for details. Before using this software for
 * any purpose, you must agree to the terms of that agreement.
 *
 ******************************************************************************/


#include "em_usb.h"
#include "msdscsi.h"
#include "msdbot.h"

/** @cond DO_NOT_INCLUDE_WITH_DOXYGEN */

/**************************************************************************//**
 * @brief Default Command Block Wrapper (CBW) data for
 *        SCSI Read10 command.
 *****************************************************************************/
#define CBW_SCSI_READ10_INIT_DEFAULT                 \
  {                                                  \
    CBW_SIGNATURE,   /* CBW Signature, ascii USBC */ \
    0x78563412,      /* CBW Tag                   */ \
    0x00000000,      /* CBW Data Transfer Length  */ \
    { { 0, 0, 1 } }, /* CBW Flags                 */ \
    { { 0, 0 } },    /* CBW Lun                   */ \
    { { 10, 0 } },   /* CBW CBLength              */ \
    { SCSI_READ10,   /* CBW CB                    */ \
      0, 0, 0, 0,                                    \
      0, 0, 0, 0,                                    \
      0, 0, 0, 0,                                    \
      0, 0, 0 }                                      \
  }

/**************************************************************************//**
 * @brief Default Command Block Wrapper (CBW) data for
 *        SCSI Write10 command.
 *****************************************************************************/
#define CBW_SCSI_WRITE10_INIT_DEFAULT                \
  {                                                  \
    CBW_SIGNATURE,   /* CBW Signature, ascii USBC */ \
    0x78563412,      /* CBW Tag                   */ \
    0x00000000,      /* CBW Data Transfer Length  */ \
    { { 0, 0, 0 } }, /* CBW Flags                 */ \
    { { 0, 0 } },    /* CBW Lun                   */ \
    { { 10, 0 } },   /* CBW CBLength              */ \
    { SCSI_WRITE10,  /* CBW CB                    */ \
      0, 0, 0, 0,                                    \
      0, 0, 0, 0,                                    \
      0, 0, 0, 0,                                    \
      0, 0, 0 }                                      \
  }

/**************************************************************************//**
 * @brief Default Command Block Wrapper (CBW) data for
 *        SCSI Inquiry command.
 *****************************************************************************/
EFM32_ALIGN(4)
static const char cbwInquiry[ CBW_LEN ] __attribute__ ((aligned(4))) =
{
  'U',          'S',                  'B',  'C',  /* CBW Signature                     */
  0x12,                         0x34, 0x56, 0x78, /* CBW Tag                           */
  SCSI_INQUIRYDATA_LEN,                           /* CBW Data Transfer Length          */
  0x00,                         0x00, 0x00,
  BOT_DIR_IN,                   0x00,    6,       /* CBW Flags, CBW Lun, CBW CB Length */
  SCSI_INQUIRY,                 0x00, 0x00,       /* 6 byte CBW CB                     */
  0x00,         SCSI_INQUIRYDATA_LEN,
  0x00,                         0x00, 0x00, 0x00,
  0x00,                         0x00, 0x00, 0x00,
  0x00,                         0x00, 0x00
};

/**************************************************************************//**
 * @brief Default Command Block Wrapper (CBW) data for
 *        SCSI Read Capacity command.
 *****************************************************************************/
EFM32_ALIGN(4)
static const char cbwReadCap[ CBW_LEN ] __attribute__ ((aligned(4))) =
{
  'U',        'S',  'B',  'C',  /* CBW Signature                     */
  0x12,       0x34, 0x56, 0x78, /* CBW Tag                           */
  SCSI_READCAPACITYDATA_LEN,    /* CBW Data Transfer Length          */
  0x00,       0x00, 0x00,
  BOT_DIR_IN, 0x00,   10,       /* CBW Flags, CBW Lun, CBW CB Length */
  SCSI_READCAPACITY,            /* 10 byte CBW CB                    */
  0x00,       0x00, 0x00, 0x00,
  0x00,       0x00, 0x00, 0x00,
  0x00,       0x00, 0x00, 0x00,
  0x00,       0x00, 0x00
};

/**************************************************************************//**
 * @brief Default Command Block Wrapper (CBW) data for
 *        SCSI Request Sense command.
 *****************************************************************************/
EFM32_ALIGN(4)
static const char cbwRs[ CBW_LEN ] __attribute__ ((aligned(4))) =
{
  'U',                       'S',  'B',  'C',  /* CBW Signature                     */
  0x12,                      0x34, 0x56, 0x78, /* CBW Tag                           */
  SCSI_REQUESTSENSEDATA_LEN,                   /* CBW Data Transfer Length          */
  0x00,                      0x00, 0x00,
  BOT_DIR_IN,                0x00,    6,       /* CBW Flags, CBW Lun, CBW CB Length */
  SCSI_REQUESTSENSE,         0x00,             /* 6 byte CBW CB                     */
  0x00,                      0x00,
  SCSI_REQUESTSENSEDATA_LEN,
  0x00,                      0x00, 0x00, 0x00,
  0x00,                      0x00, 0x00, 0x00,
  0x00,                      0x00, 0x00
};
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
