gymneus/f-watch/(commit log)

2014-05-12 mec: Add button idea mechanical sketch.
    [button_idea.fcstd]
2014-05-17 hw: Change pressure sensor model. Move block diagram to its own folder.
2014-05-17 hw: Add device icons (svg).
2014-05-17 hw: Add first kicad symbols. Feedback on kicad.
2014-05-18 hw: Add more symbols and footprints.
2014-05-19 hw: Schematics structure, update kicad feedback and sch lib.
    [freewatch_v1.sch, mcu_display.sch, periph_sensors.sch, usb_power.sch]
2014-05-20 hw: Start schematics. add LNA symbol/footprint, update kicad feedback and fix some symbols.
    [freewatch_v1.sch, mcu_display.sch, periph_sensors.sch, usb_power.sch]
2014-05-21 hw: Continue schematics, add usb esd diode symbol/footprint, update kicad feedback.
    [freewatch_v1.sch, mcu_display.sch, periph_sensors.sch, usb_power.sch]
2014-05-22 hw: Work on schematics, add high-side switch symbol/footprint.
    [mcu_display.sch, periph_sensors.sch, usb_power.sch]
2014-05-23 hw: Add crystal to mcu + symbol/footprint.
    [mcu_display.sch, periph_sensors.sch]
2014-05-24 mec: Add components placement sketch.
    [components_placement.fcstd]
2014-05-25 hw: Schematics fully wired, add battery and debug connector footprints.
    [mcu_display.sch, periph_sensors.sch, usb_power.sch]
2014-05-26 hw: Add Buzzer and backlight to schematics, add buzzer and LED symbols.
    [mcu_display.sch]
2014-05-27 hw: Annotate sch, assign footprints, start placement, update footprints.
    [freewatch_v1.kicad_pcb, freewatch_v1.sch, mcu_display.sch, periph_sensors.sch, usb_power.sch]
2014-05-29 hw: Continue placement, start routing, fix some bug in symbols.
    [freewatch_v1.kicad_pcb, mcu_display.sch, periph_sensors.sch, usb_power.sch]
2014-05-31 hw: Add MS5806 symbol and footprint.
2014-05-31 hw: Continue placement and routing (might change pressure sensor and LDO).
    [components_placement.fcstd, freewatch_v1.kicad_pcb, periph_sensors.sch, usb_power.sch]
2014-06-01 hw: Change pressure sensor for MS5806-02BA, swap pins on MCU, continue routing.
    [components_placement.fcstd, freewatch_v1.kicad_pcb, mcu_display.sch, periph_sensors.sch, usb_power.sch]
2014-06-01 mec: Update components placement sketch (new pressure sensor, 1.6mm pcb).
    [components_placement.fcstd]
2014-06-02 hw: Continue routing.
    [freewatch_v1.kicad_pcb, mcu_display.sch]
2014-06-04 hw: Cleanup schematics a bit. Add missing trace on pcb.
    [freewatch_v1.kicad_pcb, mcu_display.sch]
2014-06-04 hw: Add Venus838 and patch antenna symbols and footprints.
2014-06-05 hw: Change GPS module to M10478-A1 (with integrated antenna), add symbol and footprint.
    [periph_sensors.sch, usb_power.sch]
2014-06-06 tom's wip
    [efm32_breakout.kicad_pcb, efm32_breakout.sch]
2014-06-09 Fixed 'Hello World' program. Added OpenOCD scripts for flashing.
    [efm32_stlink2.cfg, init.cfg]
2014-06-09 hw: Connect gps signal to MCU, modify sd card symbol/footprint to connect case to GND (to avoid floating conductor -> might be bad for GPS reception).
    [mcu_display.sch]
2014-06-10 hw: Re-start placement with M10478-A1 GPS module.
    [freewatch_v1.kicad_pcb, mcu_display.sch, periph_sensors.sch, usb_power.sch]
2014-06-11 Added example application for RTX.
    [efm32_stlink2.cfg, init.cfg]
2014-06-11 Pulled out the common part and moved to the 'common' directory.
    [efm32_stlink2.cfg, init.cfg]
2014-06-11 hw: Continue placement, start routing, add battery and vibrating motor connector footprints.
    [freewatch_v1.kicad_pcb]
2014-06-12 hw: Swap pins on MCU, continue routing.
    [freewatch_v1.kicad_pcb, mcu_display.sch]
2014-06-13 hw: Add 48MHz crystal (required for USB) + footprint, continue routing.
    [freewatch_v1.kicad_pcb, mcu_display.sch]
2014-06-14 hw: routing...
    [freewatch_v1.kicad_pcb, mcu_display.sch]
2014-06-15 hw: still routing.
    [freewatch_v1.kicad_pcb]
2014-06-16 hw: Cleanup schematics, routing almost finished.
    [freewatch_v1.kicad_pcb, mcu_display.sch, periph_sensors.sch, usb_power.sch]
2014-06-17 hw: Add mounting holes. Check with Eurocircuits PCB analyzer.
    -> problem with vias OAR and IAR, to be investigated.
    [freewatch_v1.kicad_pcb]
2014-06-18 hw: Change via sizes to millimeters (in design rules).
    [freewatch_v1.kicad_pcb]
2014-06-18 hw: change vias hole sizes to finished diameter (to pass Eurocircuits DRC).
    [freewatch_v1.kicad_pcb]
2014-06-18 mec: Modify components placement sketch to fit pcb layout.
    [components_placement.fcstd]
2014-06-24 hw: Move 1.8V LDO and motor to battery charger output (instead of 3V). Add pull-up on light sensor INT output. Add 10uF capacitor before motor switch.
    [freewatch_v1.kicad_pcb, periph_sensors.sch, usb_power.sch]
2014-06-25 hw: Add SPI flash memory for GPS module. Add SST25WF040B symbol and footprint.
    [freewatch_v1.kicad_pcb, mcu_display.sch, periph_sensors.sch, usb_power.sch]
2014-06-25 mec: Add pcb and components placement (based on sketches).
    [components_placement.fcstd, pcb.fcstd]
2014-06-25 started drawing watch case (dont get too scared, I will get better....)
    [watch_case.fcstd]
2014-06-26 Added display driver (not tested).
2014-06-26 progressed with drawing first sketch of the case
    [watch_case.fcstd]
2014-06-26 hw: Route SPI flash memory for GPS and 1.8V LDO + motor switch.
    [freewatch_v1.kicad_pcb, usb_power.sch]
2014-06-26 some crazy idea for the back-cover and pressure disguise
    [watch_case-testing-crazy-idea.fcstd]
2014-07-01 tom's little PCB cleanup
    [freewatch_v1.kicad_pcb]
2014-07-01 hw: Final clean-up before prototype production
    - Add more stitching vias
    - Reduce copper planes clearance to 6 mils (was 10)
    - Add copper pour keepouts to avoid antennas
    - Undo copper plane on battery negative pin to fuel gauge (following datasheet layout recommendations).
    [freewatch_v1.kicad_pcb]
2014-07-02 hw: (Painfully) fix some via diameter errors.
    [freewatch_v1.kicad_pcb]
2014-07-10 mec: Add gps module, pressure sensor, pcb, usb connector 3D models (based on sketches).
    [gps_module_M10478.fcstd, pcb.fcstd, pressure_sensor_MS5806-02BA.fcstd, usb_connector_1551629.fcstd]
2014-07-11 mec: Add button and display 3D models (based on sketches). Add mounting holes to pcb.
    [button_EVQP4.fcstd, display_LS013B7DH03.fcstd, pcb.fcstd]
2014-07-13 small modification to first draft case
    [watch_case-testing-crazy-idea.fcstd, watch_case.fcstd]
2014-07-15 correction of the pocket for pressure sensore
    [pcb.fcstd]
2014-07-15 assembly of PCB components (and a bonus of rivet_buttons)
    [pcb_assembly.fcstd]
2014-07-15 added rivet button model (with o-ring and circlip
    [Rivet_button.fcstd]
2014-07-15 more experimenting with the case shape
    [watch_case.v2.fcstd]
2014-07-16 corrected PCB (with measurement of real) and finalized placement of components in the assembly
    [pcb.fcstd, pcb_assembly.fcstd]
2014-07-16 starting point (pcb assemply + buttons) for the case design
    [watch_case.v1.fcstd]
2014-07-16 added vibrating motor
    [pcb_assembly.fcstd]
2014-07-16 updated case startup
    [watch_case.v1.fcstd]
2014-07-17 vibration motor moving
    [watch_case.v1.fcstd]
2014-07-17 case with 0.4mm screw-up
    [watch_case.v1.fcstd]
2014-07-17 added sapphire glass (to make it look cool...
    [watch_case.v1.fcstd]
2014-07-21 corrected case (no 0.4mm screw-up)
    [watch_case.v2.fcstd]
2014-07-23 started addding log
    [watch_case.v2.fcstd]
2014-07-24 Removed the remaining LCD driver garbage from efm32_hello.
2014-07-24 seems final version of the first version of the case which is called v2
2014-07-24 model with simple copies of case components
    [watch_case.v2-simple.fcstd]
2014-07-24 exports of case parts to to some standard formats
    [Bottom.step, Bottom.stl, Top.step, Top.stl, TopLeft.step, TopLeft.stl, TopRight.step, TopRight.stl]
2014-07-27 updated all the files per Matthieu comments regarding additional screws and USB pocket
    [Bottom.step, Bottom.stl, Top.step, Top.stl, TopLeft.step, TopLeft.stl, TopRight.step, TopRight.stl]
2014-07-28 Removed (incomplete) fuel gauge driver from Makefile.
2014-07-28 Groundwork for DMA transfers in LCD driver.
2014-07-29 sw: Skeleton for the altimeter driver.
2014-07-30 sw: Work on altimeter driver, can read calibration data and print on screen but doesn't look good...
    [altimeter.c, altimeter.h, i2cdrv.c, i2cdrv.h, main.c]
2014-07-31 Initial (*not finished*) version of the fuel gauge driver. I2C driver sometimes chokes on transfers - it has to be fixed yet.
    [i2cdrv.c, i2cdrv.h, main.c, max17047.c, max17047.h]
2014-08-01 sw: Debug altimeter driver, can read calibration data without error.
    [altimeter.c, altimeter.h, i2cdrv.c, main.c]
2014-08-03 sw: Working altimeter driver. Put delay function in separate files. Add pressure to altitude conversion function.
2014-08-03 sw: Add filtering option to pressure reading.
2014-08-03 sw: Change altimeter pressure filter parameter to boolean.
2014-08-03 sw: Add light sensor driver skeleton. Lux reading works.
2014-08-04 modifications based on 3d-printed case (not finished)
2014-08-05 Finished the fuel gauge driver. *Needs testing* with real battery: charge state, remaining time.
2014-08-05 sw: Add backlight test using pwm.
2014-08-06 sw: Change get current return variable type to signed. Add init and save functions skeleton.
2014-08-06 corrected buttons, usb, screws, pressure-eye
2014-08-06 added exports (with unified/single top)
    [top.stl]
2014-08-07 Fixed types in the fuel gauge driver.
    [max17047.c]
2014-08-07 Fix screen clearing in DMA mode.
    [lcd.c]
2014-08-07 sw: Switch backlight off in fuel gauge test.
2014-08-07 mec: Fix a few bugs. Add bottom in stl format.
    [bottom.stl, top.stl]
2014-08-09 sw: Change blinky example for watch pcb v1.
2014-08-10 sw: fix bug in backup rtc example, was using LFRCO instead of LFXO.
    [main.c]
2014-08-11 mec: Work on 3d printed buttons.
    [3d_printed_button.fcstd]
2014-08-13 mec: Add several model of 3d printed button and an array of buttons for printing.
    [3d_printed_button.fcstd, array_test.fcstd]
2014-08-14 hw: update block diagram (1.8V dircetly from battery).
2014-08-18 mec: increase base and connecting cylinder to 2mm (1mm version was rejected by Sculpteo).
    [array_test.fcstd]
2014-08-18 bootloader: build missing bootloader and linker script
    [autobaud.c, autobaud.h, boot.c, boot.h, bootldio.c, bootldio.h, cdc.c, cdc.h]
2014-08-18 common: function to reset MCU
    [freewatch_utils.c, freewatch_utils.h]
2014-08-18 common: fix blinky function
    [freewatch_utils.c]
2014-08-24 bootloader: remove gcc optimization
    The GCC optimization *brake* the bootloader code. It was happening
    that on BOOT_jump() function call the ARM registers were not properly
    set. The result was that the PC and SP register were pointing at the wrong
    addresses.
2014-09-03 mec: add glass text design and howto create kicad module from bitmap.
2014-09-24 bootloader: FreeRTOS app now boots properly
    The issue was the SysTick timer, which was configured by the bootloader to
    blink the backlight LEDs, but was not de-configured before booting to the
    application.
    Without the SysTick timer de-configured, the FreeRTOS tick timer, which relies
    on the SysTick timer, fired before FreeRTOS could be properly configured. Since
    the FreeRTOS SysTick handler contains some OS-specific functions and data, the
    fact that these were not initialized probably led to a segfault.
    This issue was fixed in boot.c, by de-configuring the SysTick timer.
    Conflicts:
    sw/bootloader-an0042/main.c
    [boot.c]
2014-09-28 sw: add clock display, use buttons to increase/decrease backlight intensity.
2014-09-28 hw: add waterproof usb connector footprint, work on v2 schematics.
    [freewatch_v1.sch, mcu_display.sch, periph_sensors.sch, usb_power.sch]
2014-09-28 Test for button interrupt handlers.
2014-09-28 Added an example application (button tester).
2014-09-28 Renamed EVENT and EV_TYPE. Removed not used button_test.{c,h}.
2014-09-28 Fixed infinite queue of random events.
    [buttons.c]
2014-09-28 menu: Displays a fake list of application. It is possible to switch between menu & clock screens.
2014-09-28 menu & clock: Remapped buttons.
2014-09-28 sw: add altitude to pressure helper function and example for altitude calibration.
2014-09-28 buttons: Moved OS-related irq handling to irq_dispatcher.c.
2014-09-28 lcd: Fixed off-by-one error.
    [lcd.c]
2014-09-28 sw: work on pressure graph display (still buggy).
    [main.c]
2014-09-28 lcd: EXTCOMIN signal is directly controlled by a timer.
2014-09-28 buttons: Minor changes.
2014-09-28 buzzer: Driver, basic routines. Updated the example application.
    [buzzer.c, buzzer.h]
2014-09-28 vibra: Driver, basic functions.
2014-09-28 buttons: Rotated 180 degrees to match the current LCD display mode.
2014-09-28 backlight: Driver, basic functions.
2014-09-28 lcd: DMA mode
2014-09-28 lcd: Removed delays (experimental, revert in case of problems).
    [lcd.c, udelay.c, udelay.h]
2014-09-28 magnetometer & compass: Interrupt events are supported (*not tested yet*).
2014-09-28 light: Changed calculations to fixed point. Increased resolution. Fixed light sensor demo.
    [light_sensor.c, light_sensor.h, main.c]
2014-09-28 freertos: Automatic backlight adjustment (has to be calibrated).
2014-09-28 lcd: Fixed the tearing effect (at least in FreeRTOS).
    [lcd.c, lcd.h, lcd_dma.c]
2014-09-28 i2c: Transfers are synchronized using semaphores.
2014-09-28 ui: Experimental battery status icon.
2014-09-28 adding LSM303C accelerometer and compass driver from ST
    Initial commit, functions to read/write registers still to be filled.
2014-09-28 acc/mag driver: fixed and filled with read/write spi functions
    [lsm303c.c, lsm303c.h]
2014-09-28 lightweight printf implementation taken from wrpc-sw
2014-09-28 lsm303c: unified minimalistic driver for both accelerometer and compass
2014-09-28 LSM303C: update old driver spi calls
2014-09-28 lsm303: print compass samples to UART for hard/soft-iron calibration
2014-09-28 lsm303: adding python log analyzer for simple hard/soft-iron calibration
2014-09-28 lsm303: apply hard-iron calibration to each compass sample, hardcoded
2014-09-28 drivers/lsm303c: allow on-the-fly calibration
2014-09-28 sw: FreeRTOS blinky up and running
    [efm32_stlink2.cfg, init.cfg]
2014-09-28 sw: Moved Linux-compilable comparison projects to os-comparison/
    [efm32_stlink2.cfg, init.cfg]
2014-09-28 sw : cpying roject freertos_blink_fat as a copy of freertos_blink + integration of FAT-SL now it doesn't produce a valid binary (compliation is ok but file is too big)
    [main.c]
2014-09-28 added SPI implementation provided by EnergyMicro , created file for implementing driver FAT on SD through SPI
2014-09-28 compilation of SD driver OK (only skeletton right now)
2014-09-28 fixing SPI specificities for freewatch
2014-09-28 working on implementation of SD driver throug SPI
2014-09-28 main() test a bit the basic I/O of the SPI for SD
2014-09-28 SD protocol on SPI have a first implementation
2014-09-28 Creating project simple_spi_sd to test only the SD card. Functions of SD are implemented in ../common/drivers/sd.c and ../common/drivers/sd.h to be OS-independent
    [efm32_stlink2.cfg, init.cfg]
2014-09-28 The SPI drivers works (we see expected stuff with data analyzer)
2014-09-28 SD via SPI : now the basic is done (init of the card, need to test read and write functions)
2014-09-28 SD via SPI : works thanks to efm32 implementation. We use fatfs to implement FAT32 (instead of FAT-SL) Project sw/os-comparison/an0030_efm32_fat_on_sd_card compiles and run the FAT32 : it writes a fi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
    [efm32_stlink2.cfg, init.cfg]
2014-09-28 gpx: Small fixes to make GPX files importable into, e.g., OpenStreetMap
    Some of the GPX end tags were missing the '/' corresponding to XML end tags
    and this meant websites such as OpenStreetMap [1] or MapBBCode [2] could not
    import the GPX files created using test_covert_files.
    The tags were added and now these sites can import our GPX traces.
    [1] openstreetmap.org
    [2] http://share.mapbbcode.org
2014-09-28 usbdmsd: Add USB mass storage device test project and MSD drivers.
2014-09-28 sw: Make altimeter test work with dma lcd.
2014-09-29 move lsm303c driver, we won't use the one from ST
    [lsm303c.c, lsm303c.h, main.c]
2014-10-03 Replaced usbdesc.c for usbdbg.c where USB debug was used
    [gps.c, gps.h]
2014-10-04 Add GPS background `task' and make changes accordingly
    Two more events were added to the event type (event.h)
    - GPS_TICK -- tick from GPS background task
    - GPS_OFF -- to signal the status bar that the GPS was turned off,
    so it can remove the icon
    The status bar and GPS coordinate app were changed to react to the
    proper events, i.e., both events above in the case of the status bar
    and the GPS_TICK event in the case of the GPS coordinate app.
2014-10-05 status_bar: Fixed battery indicator.
2014-10-05 compass: Disabled the calibration.
2014-10-06 Use TR button to exit from USB mass storage app
    All other apps use the same button to exit, so the USB mass storage app was
    changed in kind.
2014-10-06 Fixed non-working GPS module in release mode
    The bloody compiler optimization was screwing over NMEA parsing, which made the
    GPS not work anymore.
    Thank you GCC for taking away 2 hrs of my life, just like that: POOF!
2014-10-07 Work towards track file naming, no particular progress
2014-10-07 Fix charging indicator.
2014-10-07 Fixed xQueueReceive() ticks-to-wait parameter in tasks.
    [buzzer.c]
2014-10-07 Fixed switching between coordinates and elevation in gps_coord.
2014-10-07 lcd: Disable DMA transfers depending on the power saving mode.
2014-10-07 ui: Battery indicator shows the proper status at the beginning.
2014-10-07 Work towards reliable GPS trace storage, not there yet.
    work:
    - configured FatFs to support long file names
    - configured FreeRTOS for max sleep mode = EM1 (this makes the GPS work with the
    OS putting the MCU in sleep mode)
    - set optimization level to -O0, to make the accelerometer and compass work
    - fooling around in GPS background task to try to store GPS trace
2014-10-09 Removed test projects, copied freertos to freewatch
    The test projects are now in the test-projects branch
    [efm32_stlink2.cfg, init.cfg]
2014-10-11 Fixed the GPLv3 license web address.
    [altimeter.c, altimeter.h, backlight.c, backlight.h, battery_task.c, battery_task.h]
2015-01-12 Added code for GPS tracking in background task. Doesn't work yet.
    [gpsbkgnd_task.c, settings.c]
2015-02-09 Debugging track storage to SD card
2015-02-09 Fixed non-storing tracking setting
    [settings.c]
2015-02-09 Removed GPS_OFF event and fixed an error related to turn-on-turn-off
    [gpsbkgnd_task.c, status_bar.c]
2015-02-09 Changed GPS fix status storage in GPS driver
    [gps.c]
2015-02-09 Fixed not storing to file issue and corrected track file name on file open
    [gpsbkgnd_task.c]
2015-02-09 Added reset icon and attached to reset app
2015-02-09 Added checking of GPS WAKEUP pin
2016-06-16 Added promotional material and hardware files.
    [watch_case.v2-simple.fcstd, watch_case.v2.fcstd]
