gymneus/f-watch/(notices)

Notices in the files:
sw/freewatch/src/apps/settings/settings.c:
modify it under the terms of the GNU General Public License
